smart-swimmingpool/pool-controller/openspec/changes/controller-architecture-contracts/tasks.md

# Tasks

- [x] Add typed `OperationMode` with stable external conversion helpers.
- [x] Keep operation-mode conversion compatible with the firmware C++ toolchain.
- [x] Add fixed-size `ControllerCommand` and source/type enums.
- [x] Cover the existing temperature-circulation setters in the command contract.
- [x] Preserve independent timer-start and timer-end update semantics in the command contract.
- [x] Cover mutable runtime controller settings (loop interval, timezone, time-loss and NORVI button thresholds).
- [x] Add `SensorSnapshot` and `SystemSnapshot` read models.
- [x] Project sensor mapping identity and configured/found state through `SensorSnapshot`.
- [x] Project timer schedule, effective runtime and circulation-extension state through `SystemSnapshot`.
- [x] Project temperature-circulation configuration through `SystemSnapshot`.
- [x] Project runtime controller settings through `SystemSnapshot`.
- [x] Preserve GREEN/YELLOW/RED time degradation in the health read model.
- [x] Project local IPv4 state through `NetworkSnapshot` without dynamic allocation.
- [x] Project both free heap and maximum allocatable heap through `SystemSnapshot`.
- [x] Assert command/snapshot value types remain trivially copyable.
- [x] Add bounded NTP-server command and settings projection with explicit non-truncating copy/validation.
- [x] Represent relative pool/solar pump toggles and mode cycling independently of adapter snapshots.
- [x] Preserve Web/NORVI/Olimex toggle mode policy as a single owner action.
- [x] Project the detected inventory with a 20-device cap, ROMs and independent temperature validity.
- [x] Add native tests for compatibility, text boundaries, full/empty inventory, diagnostics and copy semantics.
- [x] Document the minimal dependency graph, current #218 progress, #170 ownership gate and sensor projection bridge.
- [x] Add a bounded, allocation-free `ControllerCommandQueue` for adapter-to-loop hand-over.
- [x] Add a synchronized `ControllerSnapshotStore` for complete read-model publication.
- [ ] In #216/#217, verify the expanded payloads and transport resource budgets.
- [ ] In #218, validate Web/legacy NTP input without silent truncation and complete owner/adapter regressions.
- [ ] In #218/#220, verify both-bus inventory aggregation, deduplication, overflow and rescan replacement on the owning task.
- [x] Register native tests in CMake/test runner.
- [x] Store operation mode internally as the typed enum while preserving String compatibility at boundaries.
- [ ] Adopt typed commands in MQTT/Web/local UI in a follow-up change.
- [ ] Adopt `SystemSnapshot` in MQTT/Web/display in a follow-up change.
- [ ] Replace direct rule-to-relay writes with application decisions in a follow-up change.
