smart-swimmingpool/pool-controller/docs/security-references.de.md

# Sicherheitsreferenzen & Best Practices

Dieses Dokument enthält Sicherheitsreferenzen, Best Practices und
Implementierungsrichtlinien für das Pool Controller Projekt. Diese Referenzen
wurden während der umfassenden IoT-Sicherheitsanalyse am 2025-01-15 zusammengestellt.

## 📚 Sicherheitsstandards & Richtlinien

### Allgemeine Sicherheitsframeworks

- **[OWASP IoT Security Guidance](https://owasp.org/www-project-internet-of-things/)**
  Umfassendes IoT-Sicherheitsframework, das Gerätesicherheit, Netzwerksicherheit und Datenschutz abdeckt.

- \*\*[OWASP Secure Coding Practices Quick Reference Guide](https://owasp.org/www-project-secure-coding-practices-quick-reference-guide/)

\*\*
Allgemeine Richtlinien für sicheres Codieren, anwendbar auf eingebettete Systeme und IoT-Geräte.

- **[NIST IoT Device Cybersecurity Guidance](https://www.nist.gov/iot)**
  NIST-Empfehlungen für IoT-Gerätesicherheit, einschließlich Risikomanagement und Sicherheitskontrollen.

### Webanwendungssicherheit

- \*\*[OWASP CSRF Prevention Cheat Sheet](https://cheatsheetseries.owasp.org/cheatsheets/Cross-Site_Request_Forgery_Prevention_Cheat_Sheet.html)

\*\*
Umfassender Leitfaden zu CSRF-Schutzstrategien, einschließlich Token-basierter Ansätze und SameSite-Cookie-Attribute.

- \*\*[OWASP Session Management Cheat Sheet](https://cheatsheetseries.owasp.org/cheatsheets/Session_Management_Cheat_Sheet.html)

\*\*
Best Practices für sicheres Session-Management, einschließlich Timeout-Handling und Cookie-Sicherheit.

- **[OWASP Authentication Cheat Sheet](https://cheatsheetseries.owasp.org/cheatsheets/Authentication_Cheat_Sheet.html)**
  Richtlinien für sichere Authentifizierungsimplementierung, Passwortspeicherung und Credential-Management.

## 🔒 ESP32-spezifische Sicherheit

### Offizielle Espressif-Dokumentation

- **[ESP32 Sicherheitsfunktionen](https://docs.espressif.com/projects/esp-idf/en/latest/esp32/security/index.html)**
  Offizielle Espressif-Sicherheitsdokumentation, die alle Sicherheitsaspekte der ESP32-Plattform abdeckt.

- **[ESP32 Secure Boot](https://docs.espressif.com/projects/esp-idf/en/latest/esp32/security/secure-boot.html)**
  Vollständiger Leitfaden zur Implementierung von Secure Boot auf ESP32, einschließlich Schlüsselgenerierung und
  eFuse-Konfiguration.

- \*\*[ESP32 Flash-Verschlüsselung](https://docs.espressif.com/projects/esp-idf/en/latest/esp32/security/flash-encryption.html)

\*\*
Detaillierte Dokumentation zur Flash-Verschlüsselungskonfiguration und -implementierung.

- **[ESP32 eFuse-Referenz](https://docs.espressif.com/projects/esp-idf/en/latest/esp32/api-reference/system/efuse.html)
  **
  Referenzdokumentation für eFuse-Brennen und Konfigurationsoptionen.

- **[ESP32 Speichertypen](https://docs.espressif.com/projects/esp-idf/en/latest/esp32/api-guides/memory-types.html)**
  Verständnis der ESP32-Speicherarchitektur und verschiedener Speichertypen (DRAM, IRAM, etc.).

- \*\*[ESP32 Speicherverwaltung](https://docs.espressif.com/projects/esp-idf/en/latest/esp32/api-guides/memory-management.html)

\*\*
Speicherzuweisungsstrategien und Best Practices für die ESP32-Entwicklung.

- \*\*[ESP32 Heap-Fragmentierung](https://docs.espressif.com/projects/esp-idf/en/latest/esp32/api-guides/heap-fragmentation.html)

\*\*
Verständnis und Vermeidung von Heap-Fragmentierung in ESP32-Anwendungen.

- \*\*[ESP-IDF Speicher-Debugging](https://docs.espressif.com/projects/esp-idf/en/latest/esp32/api-guides/debugging/memory-leaks.html)

\*\*
Tools und Techniken zum Erkennen und Debuggen von Speicherlecks in ESP32-Anwendungen.

### Praktische Implementierungsbeispiele

- **[ESP32 HTTPS-Server](https://github.com/espressif/esp-idf/tree/master/examples/protocols/https_server)**
  Beispielimplementierung eines HTTPS-Servers auf ESP32 mit Zertifikatskonfiguration.

- **[ESP32 TLS-Client](https://github.com/espressif/esp-idf/tree/master/examples/protocols/https_request)**
  Beispiel für sichere Client-Verbindungen mit TLS auf ESP32.

## 🌐 Netzwerksicherheit

- **[IETF RFC 8520 - Manufacturer Usage Description (MUD)](https://datatracker.ietf.org/doc/html/rfc8520)**
  Standard für Manufacturer Usage Description, um Netzwerkgeräten zu ermöglichen, ihr beabsichtigtes Netzwerkverhalten
  zu signalisieren.

- **[NIST SP 800-213: IoT Device Cybersecurity Guidance](https://csrc.nist.gov/publications/detail/sp/800-213/final)**
  NIST Special Publication mit Leitlinien zur Cybersicherheit für IoT-Geräte.

## 🔧 Speicheroptimierung & Performance

### ESP32-Speicherverwaltung

- \*\*[ESP32 Speicheroptimierungsleitfaden](https://github.com/espressif/esp-idf/blob/master/docs/en/api-guides/memory-types.rst)

\*\*
Offizielle Speicheroptimierungsstrategien für die ESP32-Entwicklung.

- \*\*[Heap-Nutzungsüberwachung](https://docs.espressif.com/projects/esp-idf/en/latest/esp32/api-reference/system/heap_debug.html)

\*\*
ESP32 Heap-Debugging-Funktionen und Verwendungsbeispiele.

### Arduino & C++ Optimierung

- **[Arduino String vs char arrays](https://www.arduino.cc/en/Reference/String)**
  Wann String vs char arrays verwendet werden sollten, mit Performance-Überlegungen.

- **[ArduinoJson Speicheroptimierung](https://arduinojson.org/v6/how-to/reduce-memory-usage/)**
  Techniken zur Reduzierung des Speicherverbrauchs mit der ArduinoJson-Bibliothek.

- **[ArduinoJson Assistant](https://arduinojson.org/v6/assistant/)**
  Online-Tool zur Berechnung der benötigten Puffergrößen für JSON-Dokumente.

- **[Vermeiden von String in Arduino](https://hackingmajenkoblog.wordpress.com/2016/02/04/the-evils-of-arduino-strings/)
  **
  Warum und wie man die String-Klasse in Arduino für besseres Speichermanagement vermeidet.

- **[Statische vs Dynamische Zuweisung](https://embeddedartistry.com/blog/2017/02/22/always-use-the-right-sized-integer/)
  **
  Wahl der richtigen Zuweisungsstrategie für eingebettete Systeme.

- \*\*[Google C++ Style Guide - Speicherverwaltung](https://google.github.io/styleguide/cppguide.html#Ownership_and_Smart_Pointers)

\*\*
Richtlinien für die Verwendung von Smart Pointern und Speicherverwaltung.

## 🛡️ Sicherheitstools & Scanner

### Statische Analyse & Linting

- **[Gitleaks](https://github.com/gitleaks/gitleaks)**
  Schnelles und effizientes Erkennen von Geheimnissen in Git-Repositories. Wird in diesem Projekt zum Erkennen von
  hartcodierten Anmeldedaten und sensiblen Daten verwendet.

- **[CodeQL](https://codeql.github.com/)**
  Semantische Code-Analyse-Engine zum Auffinden von Sicherheitslücken. In GitHub Actions CI integriert.

- **[MegaLinter](https://megalinter.io/)**
  Multi-Sprachen-Linting-Framework von OX Security, das mehrere Linter kombiniert. Wird in der CI-Pipeline dieses Projekts verwendet.

- **[cpplint](https://github.com/cpplint/cpplint)**
  Googles C++-Linter zur Durchsetzung von Codierstandards und Erkennung potenzieller Probleme.

- **[clang-tidy](https://clang.llvm.org/extra/clang-tidy/)**
  Clang-basiertes statisches Analyse-Tool für C++-Code.

### Formatierungstools

- **[clang-format](https://clang.llvm.org/docs/ClangFormat.html)**
  Code-Formatierungstool mit konfigurierbaren Stilen. Wird in diesem Projekt mit benutzerdefinierter Konfiguration
  verwendet.

- **[Prettier](https://prettier.io/)**
  Meinungsstarkes Code-Formatierungstool für YAML-, JSON- und Markdown-Dateien.

- **[EditorConfig](https://editorconfig.org/)**
  Konsistente Codierstile über verschiedene Editoren und IDEs hinweg.

## 📋 Code-Qualität & CI/CD

### CI/CD Best Practices

- **[GitHub Actions Dokumentation](https://docs.github.com/en/actions)**
  Offizielle Dokumentation für die Konfiguration und Best Practices von GitHub Actions Workflows.

- **[PlatformIO CI](https://docs.platformio.org/en/latest/integration/ci/github-actions.html)**
  PlatformIO-Integration mit GitHub Actions für eingebettete Projekt-Builds.

- **[Quality Gates Pattern](https://martinfowler.com/articles/continuousIntegration.html#QualityGates)**
  Strategien zur Implementierung von Qualitätsgates in CI/CD-Pipelines.

### Linting & Formatierung

- **[MegaLinter Konfiguration](https://megalinter.io/latest/configuration/)**
  Konfigurations- und Anpassungsleitfaden für MegaLinter.

- **[clang-format Konfiguration](https://clang.llvm.org/docs/ClangFormatStyleOptions.html)**
  Vollständige Referenz für clang-format-Stiloptionen.

- **[EditorConfig-Eigenschaften](https://editorconfig.org/#file-format-details)**
  Verfügbare Konfigurationsoptionen für EditorConfig-Dateien.

## 🔐 Kryptographie & TLS

- **[mbedTLS-Dokumentation](https://github.com/Mbed-TLS/mbedtls)**
  TLS/SSL-Bibliothek, die von ESP32 für sichere Kommunikation verwendet wird.

- **[OpenSSL-Dokumentation](https://www.openssl.org/docs/)**
  Umfassende Dokumentation für die OpenSSL-Kryptographiebibliothek.

## 📖 Implementierungsleitfäden in diesem Projekt

### Sicherheitsverbesserungen (PR #112)

Die folgenden Sicherheitsverbesserungen wurden in
[PR #112](https://github.com/smart-swimmingpool/pool-controller/pull/112)
implementiert:

1. **CSRF-Schutz**

   - Token-Generierung und -Validierungssystem
   - SameSite-Cookie-Attribute für XSS/CSRF-Schutz
   - 30-minütige Token-Ablaufzeit mit automatischer Regenerierung

2. **Geheimnisverwaltung**

   - Gitleaks-Konfiguration für False Positives
   - Verbesserte Dokumentation für den Standard-Passwort-Hash
   - Bessere Code-Kommentare, die das absichtliche Hardcoding erklären

3. **Speichersicherheit**

   - Vermeidung von Dangling Pointern in TimeClientHelper
   - Speichereffiziente Utility-Funktionen in Utils.hpp
   - String-Optimierungs-Utilities

4. **Code-Qualität**
   - Zeilenlängen-Einhaltung (<130 Zeichen)
   - Entfernung von Trailing Whitespace
   - Korrekte Formatierung von Kontrollstrukturen

### Verwendungsbeispiele

#### CSRF-Token-Verwendung

```cpp
// CSRF-Tokens generieren und validieren
String token = WebPortal::generateCsrfToken();
bool isValid = WebPortal::validateCsrfToken(submittedToken);
String currentToken = WebPortal::getCurrentCsrfToken();
```

#### Speichereffiziente String-Operationen

```cpp
// Utility-Funktionen für speichereffiziente String-Operationen verwenden
String result;
Utils::safeStringConcat(result, "Hallo ", 32);
Utils::safeStringConcat(result, "Welt!", 32);

// Oder vorreservierte Strings erstellen
String reserved = Utils::createReservedString("Initial", 64);
```

## 🎯 Verwandte Skills

- **[IoT Security Skill](../.opencode/skills/iot-security/SKILL.md)** - Umfassende IoT-Sicherheitsrichtlinien
- **[C++ Memory Optimization Skill](../.opencode/skills/cpp-memory-opt/SKILL.md)** - Speicheroptimierungstechniken
- **[C++ Code Quality Skill](../.opencode/skills/cpp-code-quality/SKILL.md)** - Code-Qualitäts- und Linting-Standards

## 📝 Beitragsrichtlinien

Beim Beitragen von Sicherheitsverbesserungen zu diesem Projekt:

1. **OWASP-Richtlinien befolgen**: Halten Sie sich an OWASP-Sicherheitsbest Practices
2. **Etablierte Bibliotheken verwenden**: Bevorzugen Sie gut getestete Bibliotheken vor benutzerdefinierten Implementierungen
3. **Sicherheitsentscheidungen dokumentieren**: Dokumentieren Sie alle Sicherheitskompromisse klar
4. **Sicherheitsfunktionen testen**: Stellen Sie sicher, dass Sicherheitsfunktionen ordnungsgemäß getestet werden
5. **Dokumentation aktualisieren**: Halten Sie die Sicherheitsdokumentation auf dem neuesten Stand

## 🔍 Sicherheits-Audit-Checkliste

Verwenden Sie diese Checkliste bei der Durchführung von Sicherheitsaudits:

- [ ] Alle Anmeldedaten verschlüsselt im Ruhezustand (nicht im Klartext)
- [ ] Sichere Kommunikationsprotokolle verwendet (TLS/HTTPS)
- [ ] Eingabevalidierung für alle Benutzereingaben implementiert
- [ ] Ausgabe-Kodierung zur Verhinderung von Injection-Angriffen
- [ ] Session-Management mit angemessenen Timeouts
- [ ] CSRF-Schutz für alle zustandsändernden Operationen
- [ ] Ratenbegrenzung auf Authentifizierungs-Endpunkten
- [ ] Fehlermeldungen enthüllen keine sensiblen Informationen
- [ ] Logging enthält keine sensiblen Daten
- [ ] Speicherverwaltung verhindert Lecks und Beschädigungen

---

**📅 Zuletzt aktualisiert**: 2025-01-15
**🔍 Analyse durchgeführt von**: Vibe Code - IoT Security Expert Mode
**📝 Verwandter PR**: [#112 - IoT Security & Memory Optimization Analysis](https://github.com/smart-swimmingpool/pool-controller/pull/112)
