smart-swimmingpool/pool-controller/docs/security-references.md

# Security References & Best Practices

This document contains security references, best practices, and implementation
guidelines for the Pool Controller project. These references were compiled during the
comprehensive IoT security analysis performed on 2025-01-15.

## 📚 Security Standards & Guidelines

### General Security Frameworks

- **[OWASP IoT Security Guidance](https://owasp.org/www-project-internet-of-things/)**
  Comprehensive IoT security framework covering device security, network security, and data protection.

- \*\*[OWASP Secure Coding Practices Quick Reference Guide](https://owasp.org/www-project-secure-coding-practices-quick-reference-guide/)

\*\*

General secure coding guidelines applicable to embedded systems and IoT
devices.

- **[NIST IoT Device Cybersecurity Guidance](https://www.nist.gov/iot)**
  NIST recommendations for IoT device security, including risk management and security controls.

### Web Application Security

- \*\*[OWASP CSRF Prevention Cheat Sheet](https://cheatsheetseries.owasp.org/cheatsheets/Cross-Site_Request_Forgery_Prevention_Cheat_Sheet.html)

\*\*

Comprehensive guide to CSRF protection strategies, including token-based
approaches and SameSite cookie attributes.

- \*\*[OWASP Session Management Cheat Sheet](https://cheatsheetseries.owasp.org/cheatsheets/Session_Management_Cheat_Sheet.html)

\*\*

Best practices for secure session management, including timeout handling and
cookie security.

- **[OWASP Authentication Cheat Sheet](https://cheatsheetseries.owasp.org/cheatsheets/Authentication_Cheat_Sheet.html)**
  Guidelines for secure authentication implementation, password storage, and credential management.

## 🔒 ESP32 Specific Security

### Official Espressif Documentation

- **[ESP32 Security Features](https://docs.espressif.com/projects/esp-idf/en/latest/esp32/security/index.html)**
  Official Espressif security documentation covering all security aspects of the ESP32 platform.

- **[ESP32 Secure Boot](https://docs.espressif.com/projects/esp-idf/en/latest/esp32/security/secure-boot.html)**
  Complete guide to implementing Secure Boot on ESP32, including key generation and eFuse configuration.

- **[ESP32 Flash Encryption](https://docs.espressif.com/projects/esp-idf/en/latest/esp32/security/flash-encryption.html)
  **

  Detailed documentation on flash encryption configuration and implementation.

- **[ESP32 eFuse Reference](https://docs.espressif.com/projects/esp-idf/en/latest/esp32/api-reference/system/efuse.html)
  **

  Reference documentation for eFuse burning and configuration options.

- **[ESP32 Memory Types](https://docs.espressif.com/projects/esp-idf/en/latest/esp32/api-guides/memory-types.html)**
  Understanding ESP32 memory architecture and different memory types (DRAM, IRAM, etc.).

- \*\*[ESP32 Memory Management](https://docs.espressif.com/projects/esp-idf/en/latest/esp32/api-guides/memory-management.html)

\*\*

Memory allocation strategies and best practices for ESP32 development.

- \*\*[ESP32 Heap Fragmentation](https://docs.espressif.com/projects/esp-idf/en/latest/esp32/api-guides/heap-fragmentation.html)

\*\*

Understanding and preventing heap fragmentation in ESP32 applications.

- \*\*[ESP-IDF Memory Debugging](https://docs.espressif.com/projects/esp-idf/en/latest/esp32/api-guides/debugging/memory-leaks.html)

\*\*

Tools and techniques for detecting and debugging memory leaks in ESP32
applications.

### Practical Implementation Examples

- **[ESP32 HTTPS Server](https://github.com/espressif/esp-idf/tree/master/examples/protocols/https_server)**
  Example implementation of HTTPS server on ESP32 with certificate configuration.

- **[ESP32 TLS Client](https://github.com/espressif/esp-idf/tree/master/examples/protocols/https_request)**
  Example of secure client connections using TLS on ESP32.

## 🌐 Network Security

- **[IETF RFC 8520 - Manufacturer Usage Description (MUD)](https://datatracker.ietf.org/doc/html/rfc8520)**
  Standard for manufacturer usage description to enable network devices to signal their intended network behavior.

- **[NIST SP 800-213: IoT Device Cybersecurity Guidance](https://csrc.nist.gov/publications/detail/sp/800-213/final)**
  NIST Special Publication providing guidance on cybersecurity for IoT devices.

## 🔧 Memory Optimization & Performance

### ESP32 Memory Management

- \*\*[ESP32 Memory Optimization Guide](https://github.com/espressif/esp-idf/blob/master/docs/en/api-guides/memory-types.rst)

\*\*

Official memory optimization strategies for ESP32 development.

- \*\*[Heap Usage Monitoring](https://docs.espressif.com/projects/esp-idf/en/latest/esp32/api-reference/system/heap_debug.html)

\*\*

ESP32 heap debugging functions and usage examples.

### Arduino & C++ Optimization

- **[Arduino String vs char arrays](https://www.arduino.cc/en/Reference/String)**
  When to use String vs char arrays, with performance considerations.

- **[ArduinoJson Memory Optimization](https://arduinojson.org/v6/how-to/reduce-memory-usage/)**
  Techniques for reducing memory usage with ArduinoJson library.

- **[ArduinoJson Assistant](https://arduinojson.org/v6/assistant/)**
  Online tool to calculate required buffer sizes for JSON documents.

- **[Avoiding String in Arduino](https://hackingmajenkoblog.wordpress.com/2016/02/04/the-evils-of-arduino-strings/)**
  Why and how to avoid the String class in Arduino for better memory management.

- **[Static vs Dynamic Allocation](https://embeddedartistry.com/blog/2017/02/22/always-use-the-right-sized-integer/)**
  Choosing the right allocation strategy for embedded systems.

- \*\*[Google C++ Style Guide - Memory Management](https://google.github.io/styleguide/cppguide.html#Ownership_and_Smart_Pointers)

\*\*

Smart pointer usage guidelines and memory management best practices.

## 🛡️ Security Tools & Scanners

### Static Analysis & Linting

- **[Gitleaks](https://github.com/gitleaks/gitleaks)**
  Fast and efficient secret detection in git repositories. Used in this project
  for detecting hardcoded credentials and sensitive data.

- **[CodeQL](https://codeql.github.com/)**
  Semantic code analysis engine for finding security vulnerabilities. Integrated into GitHub Actions CI.

- **[MegaLinter](https://megalinter.io/)**
  Multi-language linting framework by OX Security. Combines multiple linters. Used in this project's CI pipeline.

- **[cpplint](https://github.com/cpplint/cpplint)**
  Google's C++ linter for enforcing coding style and detecting potential issues.

- **[clang-tidy](https://clang.llvm.org/extra/clang-tidy/)**
  Clang-based static analysis tool for C++ code.

### Formatting Tools

- **[clang-format](https://clang.llvm.org/docs/ClangFormat.html)**
  Code formatting tool with configurable styles. Used in this project with custom configuration.

- **[Prettier](https://prettier.io/)**
  Opinionated code formatter for YAML, JSON, and Markdown files.

- **[EditorConfig](https://editorconfig.org/)**
  Consistent coding styles across different editors and IDEs.

## 📋 Code Quality & CI/CD

### CI/CD Best Practices

- **[GitHub Actions Documentation](https://docs.github.com/en/actions)**
  Official documentation for GitHub Actions workflow configuration and best practices.

- **[PlatformIO CI](https://docs.platformio.org/en/latest/integration/ci/github-actions.html)**
  PlatformIO integration with GitHub Actions for embedded project builds.

- **[Quality Gates Pattern](https://martinfowler.com/articles/continuousIntegration.html#QualityGates)**
  Strategies for implementing quality gates in CI/CD pipelines.

### Linting & Formatting

- **[MegaLinter Configuration](https://megalinter.io/latest/configuration/)**
  Configuration and customization guide for MegaLinter.

- **[clang-format Configuration](https://clang.llvm.org/docs/ClangFormatStyleOptions.html)**
  Complete reference for clang-format style options.

- **[EditorConfig Properties](https://editorconfig.org/#file-format-details)**
  Available configuration options for EditorConfig files.

## 🔐 Cryptography & TLS

- **[mbedTLS Documentation](https://github.com/Mbed-TLS/mbedtls)**
  TLS/SSL library used by ESP32 for secure communications.

- **[OpenSSL Documentation](https://www.openssl.org/docs/)**
  Comprehensive documentation for OpenSSL cryptographic library.

## 📖 Implementation Guides in This Project

### Security Improvements (PR #112)

The following security improvements were implemented in
[PR #112](https://github.com/smart-swimmingpool/pool-controller/pull/112):

1. **CSRF Protection**

   - Token generation and validation system
   - SameSite cookie attributes for XSS/CSRF protection
   - 30-minute token expiration with automatic regeneration

2. **Secret Management**

   - Gitleaks configuration for handling false positives
   - Improved documentation for default password hash
   - Better code comments explaining intentional hardcoding

3. **Memory Safety**

   - Dangling pointer prevention in TimeClientHelper
   - Memory-efficient utility functions in Utils.hpp
   - String optimization utilities

4. **Code Quality**
   - Line length compliance (<130 characters)
   - Trailing whitespace removal
   - Proper control structure formatting

### Usage Examples

#### CSRF Token Usage

```cpp
// Generate and validate CSRF tokens
String token = WebPortal::generateCsrfToken();
bool isValid = WebPortal::validateCsrfToken(submittedToken);
String currentToken = WebPortal::getCurrentCsrfToken();
```

#### Memory-Efficient String Operations

```cpp
// Use utility functions for memory-efficient string operations
String result;
Utils::safeStringConcat(result, "Hello ", 32);
Utils::safeStringConcat(result, "World!", 32);

// Or create pre-reserved strings
String reserved = Utils::createReservedString("Initial", 64);
```

## 🎯 Related Skills

- **[IoT Security Skill](../.opencode/skills/iot-security/SKILL.md)** - Comprehensive IoT security guidelines
- **[C++ Memory Optimization Skill](../.opencode/skills/cpp-memory-opt/SKILL.md)** - Memory optimization techniques
- **[C++ Code Quality Skill](../.opencode/skills/cpp-code-quality/SKILL.md)** - Code quality and linting standards

## 📝 Contribution Guidelines

When contributing security improvements to this project:

1. **Follow OWASP Guidelines**: Adhere to OWASP security best practices
2. **Use Established Libraries**: Prefer well-tested libraries over custom implementations
3. **Document Security Decisions**: Clearly document any security trade-offs
4. **Test Security Features**: Ensure security features are properly tested
5. **Update Documentation**: Keep security documentation up to date

## 🔍 Security Audit Checklist

Use this checklist when performing security audits:

- [ ] All credentials encrypted at rest (not in plaintext)
- [ ] Secure communication protocols used (TLS/HTTPS)
- [ ] Input validation implemented for all user inputs
- [ ] Output encoding to prevent injection attacks
- [ ] Session management with proper timeouts
- [ ] CSRF protection for all state-changing operations
- [ ] Rate limiting on authentication endpoints
- [ ] Error messages don't reveal sensitive information
- [ ] Logging doesn't contain sensitive data
- [ ] Memory management prevents leaks and corruption

---

**📅 Last Updated**: 2025-01-15
**🔍 Analysis Performed By**: Vibe Code - IoT Security Expert Mode
**📝 Related PR**:
[#112 - IoT Security & Memory Optimization Analysis](https://github.com/smart-swimmingpool/pool-controller/pull/112)
