smart-swimmingpool/pool-controller/.slim/deepwork/pr113-and-branches.md

# Deepwork: PR #113 + Branch Audit

## Current State

### PR #113 — `vibe/security-memory-fixes-255c07` → `main`

**Merge Status**: Branch is up to date with main (0 behind, 15 ahead).
GitHub shows CONFLICTING but `git rebase main` says "up to date" — this is a stale status.

**CI Failures**:
1. **Super-Linter**: ❌ CPP (cpplint) + EDITORCONFIG errors
2. **test-and-coverage**: ❌ Compilation error in `test_security.cpp`

**Test Compilation Root Cause**: The `// NOLINT \` construct in `ASSERT_GT`/`ASSERT_GTE`/`ASSERT_LT` macros.
Backslash-newline splicing happens BEFORE comment processing (C++ phases 2→3), so `// NOLINT \` makes
the rest of the macro body a comment, leaving the `if` body unclosed.

**Codex Reviews**: 15 reviews, all COMMENTED. Most are boilerplate (no actual suggestions).
One substantive P2 comment: "Allow clearing MQTT passwords" — still unresolved.
Earlier P1/P2 comments have been addressed in subsequent commits.
The `@stritti` replied with detailed summaries (3x), all marked as addressed.
Codex hit usage limits, no further reviews possible.

**Last relevant Codex comment**: P2 about MQTT password clearing.

### Branches Overview

| Branch | Behind | Ahead | Status |
|---|---|---|---|
| `fix/ca-cert-isrg-root-x1` | 0 | 6 | current |
| `feat/kicad-schematics` | 0 | 12 | current |
| `docs/security-checklist` | 4 | 3 | stale |
| `docs/troubleshooting-matrix` | 4 | 3 | stale |
| `docs/build-from-zero` | 4 | 1 | stale |
| `opencode/lucky-garden` | 7 | 8 | stale |
| `opencode/witty-star` | 7 | 10 | stale |
| `fix/telemetry-mqtt-discovery` | 7 | 8 | stale |
| `chore/cleanup-dht-and-format` | 24 | 2 | very stale |
| `chore/skill-editorconfig-all-files` | 24 | 1 | very stale |
| `feat/mdns-discoverable` | 26 | 1 | very stale |
| `feature/norvi-ae01-r` | 26 | 7 | very stale |
| `feat/temp-based-circulation` | 44 | 5 | very stale |
| `feat/ha-climate-entity` | 46 | 4 | very stale |
