smart-swimmingpool/pool-controller/.opencode/skills/clean-code/SKILL.md

---
name: clean-code
description: "Clean Code checklist for the pool-controller C++ codebase — derived from Codex Review PR #143 findings. Systematic review categories for heap safety, duplication, debris, logging hygiene, boot sequencing, naming, const correctness, and testability. 🇩🇪 Deutsche Trigger: Sauberer Code, Code-Review, Clean Code Checkliste, Heap-Sicherheit, String-Verbot, Duplikate, Toter Code, Logging, Boot-Reihenfolge, const correctness, Testbarkeit, Entkopplung, Lesbarkeit, Wartbarkeit."
keywords:
  - clean code
  - sauberer code
  - code review checkliste
  - code review checklist
  - heap sicherheit
  - heap safety
  - string verbot
  - no string
  - duplikate vermeiden
  - code duplication
  - toter code
  - dead code
  - debris
  - logging hygiene
  - debug output
  - boot sequenz
  - boot sequence
  - degradation
  - const correctness
  - testbarkeit
  - testability
  - entkopplung
  - decoupling
  - lesbarkeit
  - readability
  - wartbarkeit
  - maintainability
  - codestandards
  - coding standards
  - naming conventions
  - early return
  - single responsibility
  - small functions
  - include hygiene
  - pre-merge review
---

# Clean Code — Pool Controller

Systematische Clean Code Review-Kategorien abgeleitet aus dem [Codex Review PR #143](https://github.com/smart-swimmingpool/pool-controller/pull/143).
Jede Kategorie beschreibt ein konkretes, prüfbares Muster — keine abstrakten Prinzipien.

Jeder PR durchläuft **alle 8 Kategorien** vor dem Merge.

> **🔍 Code Search**: `semble search "String" src/` → Heap-Verstöße finden.
> `semble search "Preferences.begin" src/` → mögliche NVS-Duplikate.
> `semble search "Serial.print" src/` → Debug-Output in Produktionscode.

---

## K1 — Heap Safety (String-Verbot in Hot Paths)

Heap-Allokationen fragmentieren den ESP32-Speicher und führen nach Tagen/Wochen zum OOM-Crash.
`String`, `std::string` und dynamische `new`-Allokationen sind nur in **Setup-/einmaligem Code** erlaubt.

### Prüfliste

| Check | Beschreibung | Konsequenz |
| --- | --- | --- |
| `String` im Loop/zyklischen Code | String-Konkatenation in `publishStates()`, `loop()`, `check*()` | **Blocked** — char-Buffer verwenden |
| `getBaseTopic()` kehrt `String` zurück | Rückgabe als `String` zwingt Caller zur Heap-Allokation | **Blocked** — `void getBaseTopic(char*, size_t, ...)` |
| `serializeJson(doc, payload)` mit `String payload` | ArduinoJson serialisiert in `String` → Heap | **Blocked** — `serializeJson(doc, payloadBuf, sizeof(payloadBuf))` |
| `String(poolTemp, 1)` für MQTT-Publish | temporäre String-Objekte im Hot Path | **Blocked** — `snprintf(valBuf, sizeof(valBuf), "%.1f", temp)` |
| `String` als Funktionsparameter | Kopie bei jedem Aufruf | `const String&` oder `const char*` |
| `str + str2` Konkatenation | Erzeugt temporäre String-Objekte | char-Array + `strlcat`/`snprintf` |

### Beispiel: Gut vs. Schlecht

```cpp
// ❌ BAD — Heap-Allokation im Hot Path
String MqttPublisher::getBaseTopic(const char *component, const char *objectId) {
  return String("homeassistant/") + component + "/pool-controller/" + objectId;
}
// → 3+ temporäre String-Objekte pro Aufruf, ~80ns + Heap-Fragmentierung

// ✅ GOOD — Stack-only
void MqttPublisher::getBaseTopic(char *buf, size_t bufSize, const char *component, const char *objectId) {
  snprintf(buf, bufSize, "homeassistant/%s/pool-controller/%s", component, objectId);
}
```

```cpp
// ❌ BAD — String als MQTT-Payload
String payload;
serializeJson(doc, payload);
NetworkManager::publish(topic, payload.c_str(), true);

// ✅ GOOD — pre-allocated char buffer
char payloadBuf[1024];
serializeJson(doc, payloadBuf, sizeof(payloadBuf));
NetworkManager::publish(topic, payloadBuf, true);
```

### Ausnahmen (akzeptabel)

- `deviceId_` im Konstruktor/`begin()` einmal gesetzt (nicht in Hot Path)
- `OtaUpdater::downloadUrl_` nur bei OTA-Update (selten)
- `ConfigManager` String-Member — nur bei `load()`/`save()` genutzt

---

## K2 — Code Duplication (DRY)

Duplizierte Logik = duplizierte Bugs. Jede Geschäftslogik existiert genau einmal.

### Prüfliste

| Muster | Fundort | Fix |
| --- | --- | --- |
| Identische NVS-Zugriffe (`Preferences::begin("ds18b20")`) | PoolController.cpp + WebPortal.cpp + ConfigManager | In ConfigManager zentralisieren |
| Gleiche Discovery-Payload-Struktur | Alle `publish*Discovery()` Methoden | Template-Methode oder Helper |
| Wiederholte `getBaseTopic(...) + "/state"` | publishStates() | `TopicBuilder`-Helper (anonymes namespace) |
| Gleiche Sensor-Mapping-Konvertierung (hexToString/addressToString) | PoolController.cpp + WebPortal.cpp | In ConfigManager oder Utility |
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
