smart-swimmingpool/pool-controller/docs/img/IMG_8198.jpg

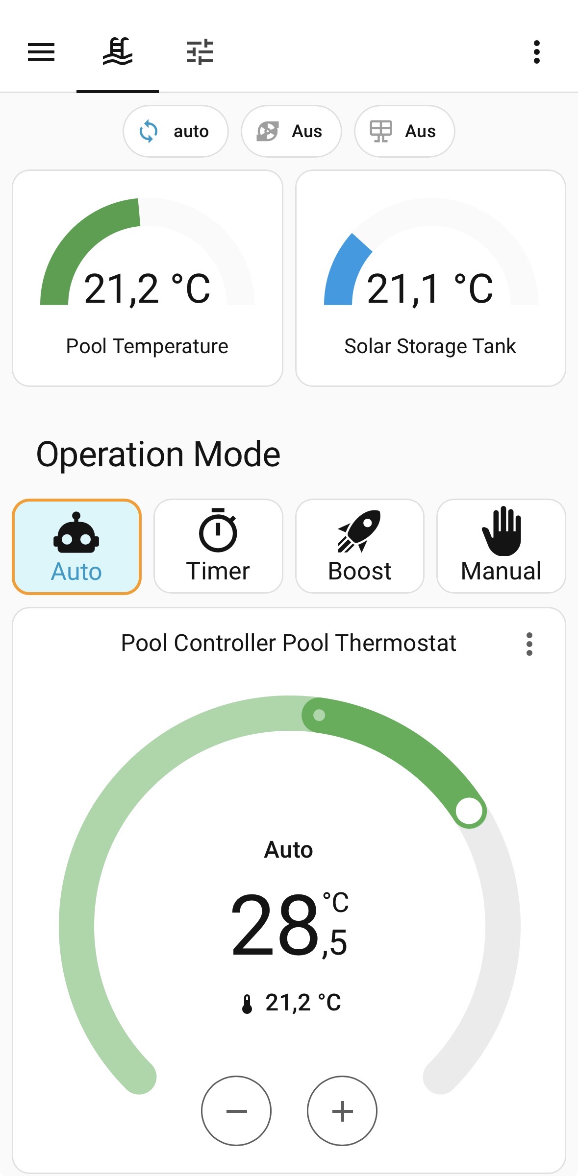
docs/img/IMG_8198.jpg
