smart-swimmingpool/pool-controller/docs/img/IMG_8199.jpg

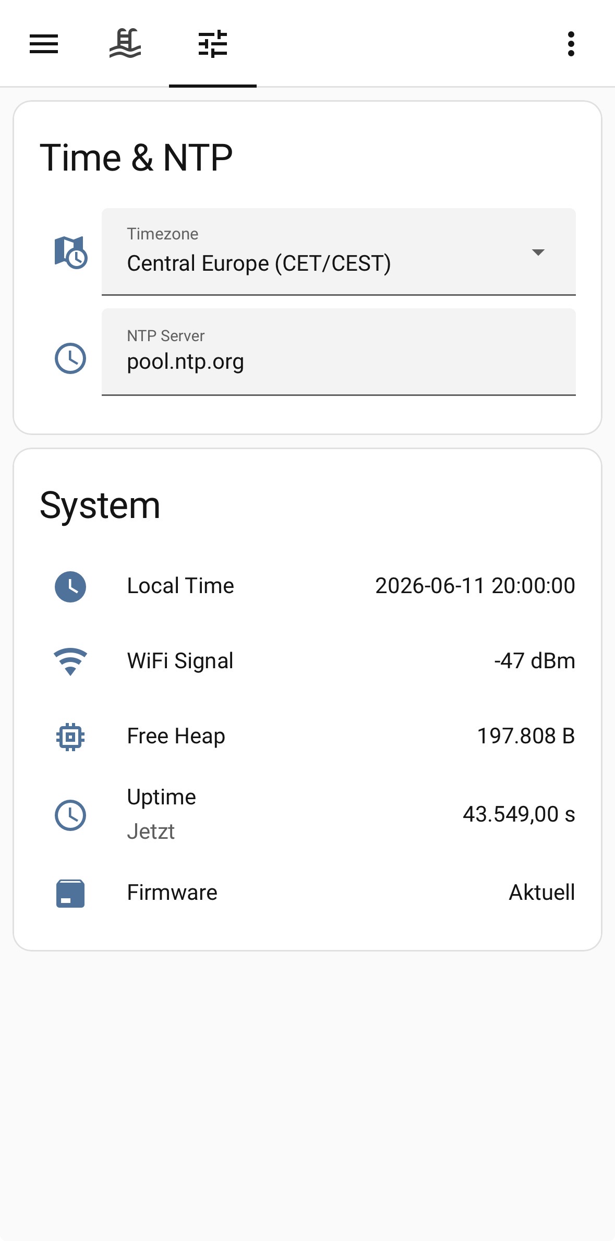
docs/img/IMG_8199.jpg
