smart-swimmingpool/pool-controller/docs/img/IMG_8200.jpg

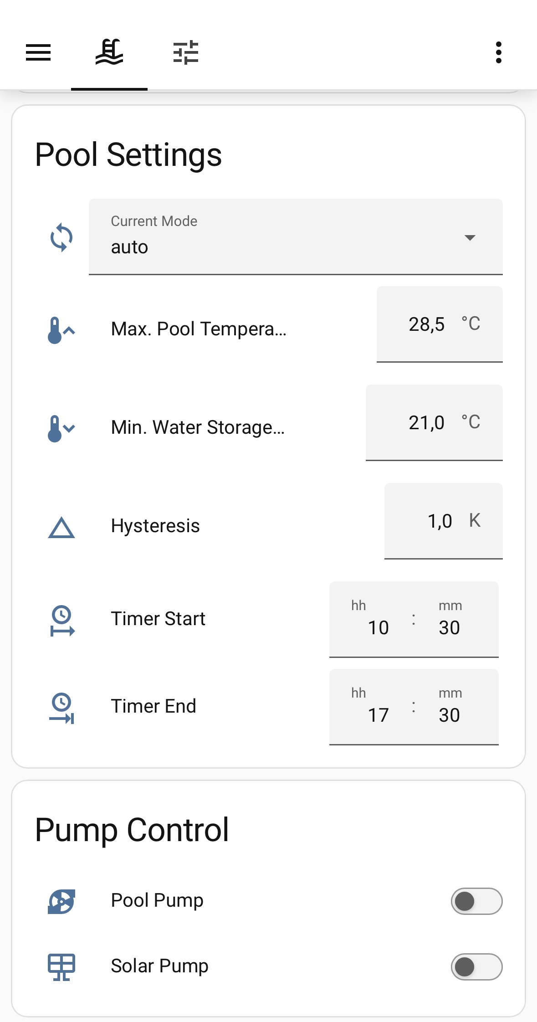
docs/img/IMG_8200.jpg
