smart-swimmingpool/pool-controller/docs/img/IMG_8207.jpg

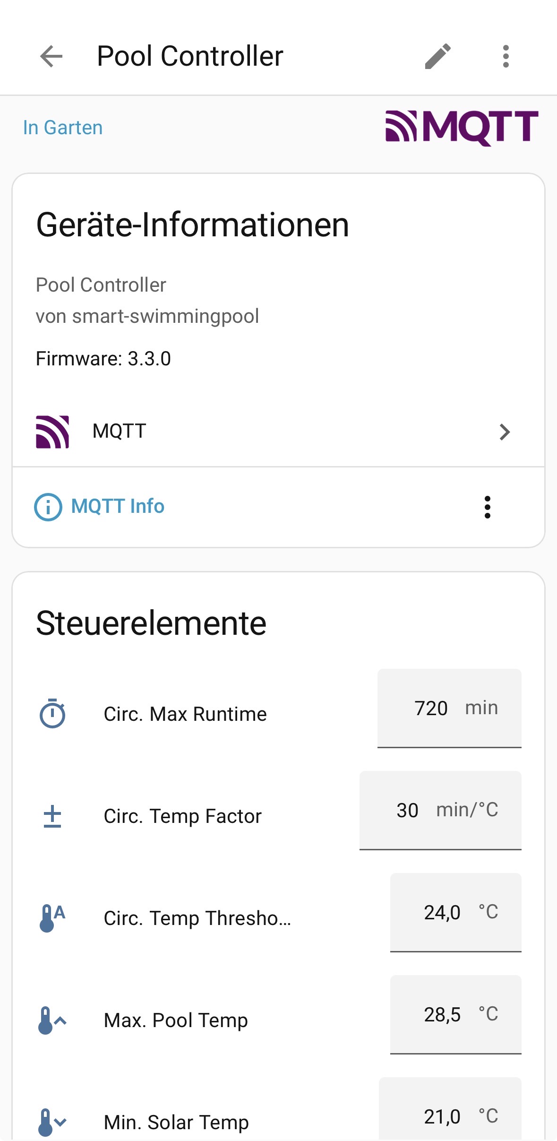
docs/img/IMG_8207.jpg
