smart-swimmingpool/pool-controller/docs/hardware-guide.de.md

---
title: Hardware-Anleitung
summary: Schritt-für-Schritt-Hardware-Anleitung für den ESP32-Pool-Controller — Teileliste mit Bezugsquellen, Schaltplan für DS18B20-Sensoren und Relaismodul, Löt- und Fertigungstipps, Stromversorgung und Inbetriebnahme
date: "2026-06-07"
lastmod: "2026-07-13"
draft: false
toc: true
type: docs
featured: true
tags: ["docs", "hardware", "anleitung", "schaltplan", "aufbau", "loeten"]
menu:
  docs:
    parent: Pool Controller
    name: Hardware-Anleitung
    weight: 20
---

## Übersicht

Diese Anleitung führt dich Schritt für Schritt durch den Hardware-Aufbau des
Pool-Controllers — von der Teileauswahl bis zur fertigen Schaltung. Auch wenn
du noch nie gelötet hast, helfen dir die detaillierten Erklärungen, alles
richtig zusammenzubauen.

> **Zielgruppe**: Elektronik-Bastler mit grundlegenden Lötkenntnissen.
> Gesamtkosten: **unter 100€** (ohne Pumpen und Pool-Infrastruktur).

## Sicherheitshinweise ⚠️

- Der Controller schaltet **230V Netzspannung** für die Pumpen. Fehlerhafte
  Verdrahtung kann zu Stromschlag oder Brand führen.
- Arbeite nur **spannungsfrei** an der Schaltung.
- Verwende einen **FI-Schutzschalter (RCD)** für den Pumpenstromkreis.
- Sensorleitungen (Niederspannung) und Netzleitungen **räumlich getrennt** führen.
- Im Zweifel die Netzinstallation von einem **Elektrofachbetrieb** prüfen lassen.

---

## Benötigte Teile (BOM)

| # | Bauteil | Menge |  ca. Preis  | Hinweise |
| --- | --- | :---: | :---: | --- |
| 1 | ESP32-Entwicklungsboard (z.B. ESP32 DevKit V1, NodeMCU-32S) | 1 | 10–15€ | Mindestens 4MB Flash |
| 2 | DS18B20-Temperatursensor (wasserfest, Edelstahl, 1m Kabel) | 2 | 8–12€ | Einer für Poolwasser, einer für Solarkollektor |
| 3 | 2-Kanal-5V-Relaismodul (mit Optokoppler) | 1 | 5–8€ | **Muss** active-high sein (siehe Hinweise) |
| 4 | Widerstand 4,7kΩ (¼W oder ⅛W, Metall- oder Kohleschicht) | 2 | < 1€ | Pull-up für die OneWire-Datenleitungen |
| 5 | Breadboard + Jumper-Kabel (zum Testen) **ODER** Lochrasterplatine + Stiftleisten/Schraubklemmen (für Daueraufbau) | 1 | 3–8€ | |
| 6 | USB-Netzteil 5V/≥1A (z.B. Handy-Ladegerät) | 1 | 5–10€ | Für den ESP32 allein |
| 7 | Schaltdraht, 0,14–0,5mm², verschiedene Farben | — | 3–5€ | |
| 8 | Optional: Gehäuse (ABS/PVC-Projektbox, IP54 oder besser) | 1 | 5–10€ | Schutz vor Spritzwasser/Staub |
| 9 | Optional: Schraubklemmen (2-polig, 5mm Raster) |  4–6  | 2–3€ | Für steckbare Sensor-/Stromanschlüsse |
| 10 | Optional: DS3231 RTC-Modul | 1 | 3–5€ | Backup-Uhr (nicht nötig bei NTP-Betrieb) |
| **Gesamt** | | | **~45–75€** | Ohne Gehäuse; deutlich unter 100€ |

### Bezugsquellen

Alle Teile gibt es bei Amazon, AliExpress, eBay oder bei Elektronik-Distributoren
wie:

- **Reichelt** (reichelt.de) — zuverlässig, schneller Versand in DE/AT
- **Pollin** (pollin.de) — günstige Komponenten
- **Conrad** (conrad.de) — großes Sortiment, etwas teurer
- **Amazon** — bequem, aber oft Aufpreis

Suchbegriffe:

- **ESP32**: "ESP32 DevKit V1" oder "ESP32 NodeMCU-32S". Kein ESP32-S2/S3/C3
  kaufen — die Firmware läuft auf dem Standard-ESP32 (Xtensa Dual-Core).
- **DS18B20**: **Edelstahl, wasserdicht** mit 1m Kabel. Günstige
  Kunststoff-Varianten gehen auch, sind aber weniger haltbar im Außeneinsatz.
- **Relaismodul**: **Achtung: Logikpegel prüfen!** Die Firmware schaltet per
  **active-high** (GPIO HIGH → Relais EIN). Viele günstige Module sind
  active-low (mit Jumper zum Umschalten). Vor dem Festlöten prüfen.

---

## Pin-Belegung (Firmware-Standard)

Die Firmware verwendet eine **optimierte Pin-Belegung**, die Strapping-Pins und
ADC2-Probleme vermeidet (Details siehe
[Alternative Pin-Belegung](#alternative-pin-belegung-original)). Definiert in
`src/Config.hpp`:

| Konstante | GPIO | Zweck |
| --- | :---: | --- |
| `PIN_DS_SOLAR` | **GPIO32** | DS18B20 Daten — Solarkollektor-Temperatur |
| `PIN_DS_POOL` | **GPIO33** | DS18B20 Daten — Pool-Wassertemperatur |
| `PIN_RELAY_POOL`  | **GPIO25** | Relais-Ansteuerung — Pool-Umwälzpumpe |
| `PIN_RELAY_SOLAR` | **GPIO26** | Relais-Ansteuerung — Solar-Heizungspumpe  |
| `PIN_LED_STATUS`  | **Eingebaute LED** | Status-LED (Homie-Blink-Codes) |

> **Hinweis**: Diese Pins sind auf maximale Kompatibilität ausgelegt. Die
> ursprüngliche Belegung (GPIO15/16/18/19) funktioniert ebenfalls, aber die
> optimierten Pins eliminieren jedes Boot-Risiko und vermeiden ADC2-Pins.

---

## Schaltplan

### Stromversorgung

```svgbob
 .---------------.        .---------------------.        .------------------.
 |  USB-Netzteil |        |        ESP32        |        |   Relaismodul    |
 |    5V, 1A+    |        |                     |        |     2 Kanal      |
 |               |        |                     |        |                  |
 |         5V o--+--------+--o VIN        5V o--+--------+--o VCC           |
 |               |        |                     |        |                  |
 |        GND o--+--------+--o GND       GND o--+--------+--o GND           |
 '---------------'        '---------------------'        '------------------'
```

### Sensoren

Beide Sensoren teilen sich die 3,3V-Schiene. Der 4,7kΩ-Widerstand ist die einzige Verbindung zwischen DATA und 3,3V.

```svgbob
 .---------------------.             .--------------------.
 |        ESP32        |             |   DS18B20 Solar    |
 |                     |             |                    |
 |           GPIO32 o--+----*--------+--o DATA            |
 |                     |    |        |                    |
 |                     | .--+--.     |                    |
 |                     | |4.7k |     |                    |
 |                     | '--+--'     |                    |
 |                     |    |        |                    |
 |              3V3 o--+----*--------+--o VDD             |
 |                     |             |                    |
 |              GND o--+-------------+--o GND             |
 '---------------------'             '--------------------'
```
```svgbob
 .---------------------.             .--------------------.
 |        ESP32        |             |    DS18B20 Pool    |
 |                     |             |                    |
 |           GPIO33 o--+----*--------+--o DATA            |
 |                     |    |        |                    |
 |                     | .--+--.     |                    |
 |                     | |4.7k |     |                    |
 |                     | '--+--'     |                    |
 |                     |    |        |                    |
 |              3V3 o--+----*--------+--o VDD             |
 |                     |             |                    |
 |              GND o--+-------------+--o GND             |
 '---------------------'             '--------------------'
```

### Relais-Steuersignale

```svgbob
 .---------------------.        .--------------------.
 |        ESP32        |        |    Relaismodul     |
 |                     |        |      2 Kanal       |
 |           GPIO25 o--+--------+--o IN1             |
 |           GPIO26 o--+--------+--o IN2             |
 |               5V o--+--------+--o VCC             |
 |              GND o--+--------+--o GND             |
 '---------------------'        '--------------------'
```

Statusanzeige: Die eingebaute LED (GPIO2) zeigt die Status-Blinkcodes (Homie).

---

## Schritt-für-Schritt-Verdrahtung

### 1. Temperatursensoren (DS18B20)

Der DS18B20 hat drei Adern (bei wasserdichten Fühlern: **rot = VDD**,
**gelb/weiß = DATA**, **schwarz = GND** — **immer mit Datenblatt deines
Sensors vergleichen!**):

| DS18B20-Ader | Farbe (typisch) | Anschluss |
| :---: | :---: | --- |
| VDD | **Rot** | ESP32 **3,3V** |
| GND | **Schwarz** | ESP32 **GND** |
| DATA |  **Gelb/Weiß**  | ESP32 **GPIO32** (Solar) oder **GPIO33** (Pool) |

**Wichtig — den 4,7kΩ-Pull-Up-Widerstand nicht vergessen:**

Jede DATA-Leitung **muss** über einen **4,7kΩ-Widerstand** mit **3,3V**
verbunden werden. Ohne diesen Widerstand wird der Sensor nicht erkannt —
das ist die **häufigste Fehlerquelle**.

```svgbob
 Solar DATA o----[ 4.7k ]----o 3V3
 Pool  DATA o----[ 4.7k ]----o 3V3
```

Löte den Widerstand möglichst nahe am ESP32-Pin-Header, zwischen DATA-Pin
und der 3,3V-Schiene. Geeignet ist jeder 4,7kΩ ±5%-Widerstand (¼W oder ⅛W,
Metall- oder Kohleschicht).

### 2. Relaismodul

| Relais-Anschluss | Typische Bezeichnung | Anschluss |  Kabelfarbe |
| :---: | :---: | --- | :---: |
| Modul-Versorgung | `VCC` oder `VDD` | **5V** (vom ESP32-VIN oder externem 5V-Netzteil) | **Rot** |
| Masse | `GND` | **GND** (gemeinsame Masse mit ESP32) |  **Schwarz**  |
| Steuereingang 1  | `IN1` oder `D1` | **GPIO25** (Pool-Pumpe) | **Gelb/Blau** |
| Steuereingang 2  | `IN2` oder `D2` | **GPIO26** (Solar-Pumpe) | **Grün/Blau** |

**Wichtig — Logikpegel**: Die Firmware setzt den GPIO-Pin auf **HIGH (3,3V)**
um das Relais zu aktivieren (active-high). Wenn dein Modul bei LOW schaltet
(active-low), suche nach einem **Jumper** auf der Modulplatine, um den Modus
zu wechseln. Active-high-Module sind einfacher in der Handhabung.

**Lastseite (230V-Seite) — Standard-Relaismodul:**

Lastseite des Relais (230V AC), dargestellt ist Kanal 1.
Kanal 2 (Solarpumpe) wird identisch verdrahtet. Der Neutralleiter geht direkt von der Neutralschiene zur Pumpe und wird nicht geschaltet.

```svgbob
 .-------------.   .---------------.   .---------------.   .----------------.   .-------------.
 |     Netz    |   |       FI      |   |       LS      |   |  Relaismodul   |   |    Pumpe    |
 |   230V AC   |   |               |   |               |   |    Kontakt     |   |             |
 |             |   |               |   |               |   |                |   |             |
 |        L o--+---+--o in  out o--+---+--o in  out o--+---+--o COM   NO o--+---+--o L        |
 '-------------'   '---------------'   '---------------'   '----------------'   '-------------'
```

- Den Außenleiter (L) der Pumpe an den **COM**-Kontakt (Mitte) des Relais.
- Den **NO**-Kontakt (Schließer, "normally open") mit der Pumpe verbinden.
- Den anderen Pumpenanschluss an **Neutralleiter (N)**.
- Den 230V-Stromkreis **immer** über einen FI-Schutzschalter und einen
  passend abgesicherten Leitungsschutzschalter führen.

   ╔══════════════════════════════════════════════════════════════════════╗
   ║  ⚠ WICHTIG — Grenze bei Motorlast (gleiches Problem wie NORVI)     ║
   ║                                                                     ║
   ║  Externe 5V-Relaismodule (z.B. SRD-05VDC-SL-C) sind für ohmsche    ║
   ║  Last spezifiziert (typ. 10A/250V AC). Eine **Pumpe ist eine        ║
   ║  induktive Motorlast** mit 5–10× höherem Einschaltstrom, der die    ║
   ║  Relaiskontakte nach wiederholtem Schalten verschweißen kann —      ║
   ║  genauso wie bei den NORVI-Bordrelais.                              ║
   ║                                                                     ║
   ║  Falls du Pumpen oder andere Motorlasten >300W schaltest:           ║
   ║  → Verwende das ESP32-Relais nur zur Ansteuerung eines              ║
   ║    **Hutschienen-Schützes** (Contacteur)                            ║
   ║  → Das Schütz übernimmt die Motorlast; das 5V-Relais ist nur        ║
   ║    noch die Steuerschnittstelle (kein Kontaktverschleiß)            ║
   ║                                                                     ║
   ║  Siehe → **[Schütz-Schaltung für Pumpen](contactor-guide.de.md)**   ║
   ╚══════════════════════════════════════════════════════════════════════╝

### 3. Stromversorgung

| Komponente | Spannung | Quelle | Hinweise |
| --- | :---: | --- | --- |
| ESP32-Board |  **5V**  | USB-Ladebuchse (am ESP32) | Versorgt Board + stellt 5V am VIN-Pin bereit |
| Relaisspulen |  **5V**  | ESP32-VIN-Pin (gleicher USB-Eingang) | Relaismodul bezieht Strom aus derselben 5V-Versorgung |
| DS18B20-Sensoren | **3,3V** | ESP32-3V3-Ausgangspin | Beide Sensoren teilen sich 3,3V-Schiene |
| (Optional) RTC DS3231 | **3,3V** | ESP32-3V3-Ausgangspin | Dieselbe Schiene wie Sensoren |

> **Wichtig**: Der eingebaute 3,3V-Spannungsregler des ESP32 liefert ca. 600mA.
> Die DS18B20-Sensoren brauchen zusammen < 5mA — völlig unkritisch. Wenn du
> viele zusätzliche 3,3V-Komponenten anschließt, einen externen 3,3V-Regler
> verwenden.

---

## Aufbau-Schritte

### Testaufbau auf dem Breadboard

1. **ESP32 aufstecken** — mittig auf dem Breadboard, über die Mittellücke
2. **Stromschienen verbinden** — 3,3V und GND auf beiden Seiten
3. **Pull-Up-Widerstände einstecken** — zwischen DATA-Reihe und 3,3V-Schiene
4. **DS18B20-Sensoren anschließen** — Jumper-Kabel für VDD (3,3V), GND und DATA
5. **Relaismodul anschließen** — Jumper für VCC (5V), GND, IN1, IN2
6. **Stromversorgung per USB** — Der VIN/USB-Pin des ESP32 liefert 5V fürs
   Relaismodul
7. **Alle Verbindungen prüfen** bevor du Spannung anlegst
8. **Test**: Siehe [Inbetriebnahme](#inbetriebnahme-und-test)

{{< figure
  library="true"
  src="pool-controller_breadboard.png"
  title="Pool-Controller Breadboard-Aufbau mit ESP32, zwei DS18B20-Temperatursensoren, 4,7kΩ-Pull-Up-Widerständen und 2-Kanal-Relaismodul"
  lightbox="true" >}}

> 💡 **Tipp**: Unterschiedliche Jumper-Farben verwenden — z.B. rot für
> Spannung (3,3V/5V), schwarz für Masse (GND), gelb für Sensordaten, blau für
> Relais-Steuerung.

### Dauerhafter Aufbau auf Lochrasterplatine

Wenn der Testaufbau auf dem Breadboard funktioniert, baust du die endgültige
Version:

1. **Layout planen**: Komponenten vor dem Löten auf der Platine anordnen.
   230V-Relais-Anschlüsse an einer Kante, Sensoranschlüsse an der gegenüber-
   liegenden Seite.
2. **In dieser Reihenfolge löten**:
   - Stiftleisten / Schraubklemmen für den ESP32 (fasse ihn in eine Sockelleiste,
     löte nicht direkt auf die Platine)
   - Widerstände (4,7kΩ)
   - Stiftleisten fürs Relaismodul (auch hier sockeln)
   - Schraubklemmen für Sensoranschlüsse
3. **Verbindungen führen**: Massivdraht für die Verbindungen. Datenleitungen
   kurz halten.
4. **Auf Lötzinnbrücken prüfen**: Jede Lötstelle mit der Lupe oder Multimeter
   (Durchgangsprüfung) kontrollieren.
5. **Ins Gehäuse einbauen**: Abstandsbolzen oder doppelseitiges Klebeband
   verwenden. Löcher für Sensor- und Relaiskabel bohren. **Kabelverschraubungen**
   (PG7/PG9) für wasserdichte Kabeldurchführung nutzen.

---

## Fertigungstipps

### Löten

- **Blei-Lot verwenden** (Sn60Pb40 oder Sn63Pb37) — es fließt besser als
  bleifreies Lot, besonders für Anfänger. (In DE/AT für Hobbyzwecke weiterhin
  erlaubt und empfohlen.)
- **Flussmittel**: Flussmittelkern-Lot nehmen; bei widerspenstigen Lötstellen
  zusätzlich Flüssig-Flussmittel.
- **Temperatur**: Lötkolben auf 320–350°C (Bleilot) oder 370–400°C (bleifrei)
  einstellen.
- **Spitze sauber halten**: Vor **jeder** Lötstelle an feuchtem Schwamm oder
  Messingwolle reinigen.
- **Gute Lötstelle**: Glänzend, konkave Verrundung, die um den Draht herum
  fließt. Eine matte, rissige oder kugelförmige Stelle ist **schlecht** —
  nachwärmen und frisches Lot zugeben.

### Gehäuse

- **ABS- oder PVC-Projektbox** mit mindestens IP54-Schutzart für den
  Außeneinsatz (Spritzwasserschutz).
- **Lüftungsschlitze** bohren, wenn das Relaismodul warm wird — aber nach
  unten gerichtet, damit kein Wasser eindringt.
- ESP32 auf **M2,5- oder M3-Nylon-Abstandsbolzen** montieren, um
  Kurzschlüsse zu vermeiden.
- Außenanschlüsse beschriften (Pool-Sensor, Solar-Sensor, Pumpe 1, Pumpe 2,
  USB-Strom).
- **Kabelverschraubungen** (PG7 für dünne Sensorkabel, PG9 für dickere
  Stromkabel) an den Kabeleinführungen verwenden.

### Kabelmanagement

- **Beide Enden jedes Kabels beschriften** — mit Schrumpfschlauch-Etiketten
  oder kleinen Klebeetiketten. Zukünftiges Du wird es dir danken.
- **Sensor- und Relaiskabel getrennt führen** im Gehäuse, um
  Einstreuungen zu minimieren.
- **Zugentlastung**: Kabel an Montagepunkten oder mit Kabelbindern fixieren,
  damit Zug an den Außenkabeln nicht die Lötstellen belastet.
- **Service-Schlaufe**: Genug Drahtreserve im Gehäuse lassen, damit du es
  öffnen und arbeiten kannst ohne alles zu trennen.

### Sensoren im Außenbereich

- **DS18B20-Fühler** sind wasserdicht, aber der Kabeleingang am Sensor ist
  nicht immer dicht. **Schrumpfschlauch** über die Kabelverbindung ziehen
  oder **selbstverschmelzendes Silikonband** für Außeninstallationen.
- Sensorkabel in **Leerrohr** (PVC oder flexibel) verlegen, wo sie
  mechanisch belastet werden (Rasen, Einfahrt).
- **Maximale Kabellänge**: DS18B20 funktioniert zuverlässig bis ca. 30m mit
  4,7kΩ-Pull-up und verdrilltem Kabel. Bei längeren Strecken den Pull-up auf
  2,2kΩ verringern oder einen OneWire-Treiber verwenden.
- Pool-Sensor in den **Pumpenkreislauf** einbauen (nach dem Filter, vor dem
  Rücklauf) für eine genaue Durchschnittstemperatur.
- Solar-Sensor an der **heißesten Stelle des Solarkollektors** (meist das
  obere Austrittsrohr) anlegen.

---

## Stromversorgungs-Optionen

| Option | Vorteile | Nachteile |
| --- | --- | --- |
| **USB-Handy-Ladegerät** (5V/1A+) | Günstig, überall verfügbar, sicher | Begrenzter Strom für Zusatzgeräte |
| **Hutschienen-Netzteil** (Mean Well HDR-15-5 o.ä.) | Professionell, zuverlässig, passt in Verteiler | Etwas teurer (~15€) |
| **ESP32-VIN via USB** + Relais von derselben 5V | Einfache Verdrahtung | Gesamtstrom muss unter Grenze des ESP32-Boards bleiben |

**Empfehlung**: Wenn du einen festen Installationsort in der Nähe deiner
Pumpensteuerung hast, nimm ein **Hutschienen-5V-Netzteil** (z.B. Mean Well
HDR-15-5). Das ist sauber, zuverlässig und versorgt ESP32 und Relaismodul
problemlos.

> **Alternative — Industriesteuerung:** Der [NORVI IIOT-AE01-R](norvi-ae01-r.de.md)
> ist ein ESP32-basierter Industriecontroller mit **integrierten Relais,
> 24V-DC-Versorgung, Hutschienenmontage und CE-Zertifizierung**. Wenn du bereits
> ein 230V AC → 24V DC Netzteil hast, wird kein zusätzliches 5V-Netzteil
> benötigt. Siehe [NORVI AE01-R Konfigurationsanleitung](norvi-ae01-r.de.md) für
> Details.

---

## Inbetriebnahme und Test

### 1. Sichtprüfung

Vor dem Anlegen der Spannung:

- Auf **Lötbrücken** zwischen benachbarten Pins prüfen
- **Polung** aller Komponenten kontrollieren (DS18B20 VDD/GND, Relais VCC/GND)
- **Keine losen Drahtenden**, die benachbarte Pins kurzschließen
- Widerstand zwischen **3,3V und GND** messen — sollte > 10kΩ sein (kein Kurzschluss)

### 2. Einschalten

1. USB-Strom (oder 5V-Netzteil) anschließen
2. Die **eingebaute LED** zeigt den Systemstatus nach Homie-Convention:
   - **Schnelles Blinken (5 Hz)** — AP-Modus (kein WLAN konfiguriert)
   - **Langsames Blinken (1 Hz)** — WLAN-Verbindung läuft
   - **Meist an, kurzes Blinken alle 2s** — WLAN OK, MQTT getrennt
   - **Dauerhaft an** — WLAN + MQTT verbunden

### 3. Sensoren prüfen

Serielles Monitor öffnen (115200 Baud):

```
Pool Controller v3.3.0
Starting up...
✓ Pin configuration validated - no conflicts (optimierte Belegung)
  Solar Temp (DS18B20): GPIO32
  Pool Temp  (DS18B20): GPIO33
  Pool Pump  (Relay):   GPIO25
  Solar Pump (Relay):   GPIO26
  Status LED:           GPIO2 (LED_BUILTIN)
```

Wenn die Sensoren angeschlossen sind und funktionieren:

```
Solar temperature: 25.3°C
Pool temperature:  22.1°C
```

Bei `Sensor error` oder `-127°C`, prüfe:

- [ ] 4,7kΩ-Pull-up-Widerstand auf jeder DATA-Leitung vorhanden?
- [ ] DS18B20 VDD an 3,3V (nicht 5V)?
- [ ] DS18B20 GND an gemeinsamer Masse?
- [ ] DATA-Pin stimmt mit Firmware-Konfiguration überein?

### 4. Relais testen

Über das Web-UI (Reiter Konfiguration) oder per seriellem Befehl:

```
Mode: manual
Pool pump: ON  → Relais klickt hörbar, Pumpe läuft an
Solar pump: ON → Relais klickt hörbar, Pumpe läuft an
```

Wenn das Relais nicht klickt:

- [ ] Ist das Relaismodul mit Strom versorgt (5V zwischen VCC und GND)?
- [ ] Stimmt der Logikpegel (active-high vs. active-low)?
- [ ] Leuchtet die LED auf dem Relaismodul, wenn GPIO auf HIGH geht?

---

## ⚠ Wichtig: Relaiskontakte bei Motorlast (Pumpen)

Die verwendeten Relais (NORVI-Bordrelais wie auch externe 5V-Module) sind für
**ohmsche Lasten** spezifiziert. Eine **Pumpe ist eine induktive Motorlast**
mit 5–10× höherem Einschaltstrom (Inrush). Dies kann nach einigen hundert
Schaltvorgängen zu **verschweißten Relaiskontakten** führen — das Relais
klickt dann zwar noch, aber der NO-Kontakt trennt nicht mehr, und die Pumpe
läuft dauerhaft, obwohl der Controller AUS anzeigt.

**Empfehlung:** Verwende bei Pumpen >300W grundsätzlich **externe
Installationsschütze** zwischen Relais und Pumpe. Das Relais schaltet dann
nur die 24V-Spule des Schützes (einige mA) — die Hauptkontakte des Schützes
schalten die 230V-Last. Siehe die separate Anleitung:

👉 **[Schütz-Schaltung für Pumpen – Anleitung](contactor-guide.de.md)**

## Fehlersuche

| Symptom | Wahrscheinliche Ursache | Lösung |
| --- | --- | --- |
| "Sensor error" oder `-127°C` | Pull-up-Widerstand fehlt | 4,7kΩ zwischen DATA und 3,3V einlöten |
| "Sensor error" | Falscher GPIO-Pin | `PIN_DS_SOLAR`/`PIN_DS_POOL` in `src/Config.hpp` prüfen |
| Unbeständige Messwerte | Wackelkontakt oder Einstreuungen | Lötstellen prüfen, Daten- und Relaisleitungen trennen |
| Relais schaltet nicht | Falscher Logikpegel | Active-high vs. active-low prüfen; Jumper umstecken |
| Relais klickt, Pumpe läuft nicht | 230V-Verdrahtungsfehler | COM/NO-Kontakte prüfen, Pumpenanschluss kontrollieren |
| Pumpe läuft trotz AUS-Anzeige | Relaiskontakt verschweißt (Motorlast) | **Schütz zwischenschalten** (siehe [Schütz-Anleitung](contactor-guide.de.md)) |
| ESP32 startet nicht (Brownout) | Zu schwache Stromversorgung | 5V/≥1A-Netzteil verwenden; 100µF-Kondensator nahe VIN |
| ESP32 resetet beim Relais-Schalten | Spannungsspitze an der Relais-Spule | Freilaufdiode parallel zur Spule, oder Modul mit eingebautem Schutz |
| Messwerte springen beim Schalten | Elektrisches Rauschen | Sensorleitungen getrennt von Relais-/Stromkabeln führen |

---

## Alternative Pin-Belegung (Original)

Die Firmware verwendet jetzt standardmäßig die **optimierten Pins (GPIO32/33/25/26)**
(siehe [Pin-Belegung](#pin-belegung-firmware-standard) oben). Die ursprüngliche
Belegung (GPIO15/16/18/19) steht als Alternative zur Verfügung, falls du
Legacy-Hardware oder bestimmte Shield-Boards verwenden möchtest:

```cpp
constexpr uint8_t PIN_DS_SOLAR{15};     // war 32
constexpr uint8_t PIN_DS_POOL{16};      // war 33
constexpr uint8_t PIN_RELAY_POOL{18};   // war 25
constexpr uint8_t PIN_RELAY_SOLAR{19};  // war 26
```

| Funktion | Optimiert (Default) | Original-Pin | Grund der Änderung |
| --- | :---: | :---: | --- |
| DS18B20 Solar | **GPIO32** | GPIO15 | GPIO15 ist Strapping-Pin — OneWire entfernt Boot-Risiko |
| DS18B20 Pool  | **GPIO33** | GPIO16 | Saubere Trennung vom verbleibenden Strapping-Pin GPIO0 |
| Relais Pool | **GPIO25** | GPIO18 | ADC2-Pins (18/19) vermieden; GPIO25 ist sauberer Digitalausgang |
| Relais Solar  | **GPIO26** | GPIO19 | Gleicher Grund wie oben |

Die Optimierung ist im Dokument
[ESP32 Schaltplananalyse und Optimierung](esp32-schematic-optimization.de.md)
ausführlich analysiert und begründet.

---

## LED-Status-Codes (Homie-Convention)

Der Controller nutzt die **eingebaute LED** zur Signalisierung des
Systemzustands nach der [Homie Convention](https://homieiot.github.io/),
dem Standard für IoT-Statusanzeigen.

| LED-Muster | Systemzustand | Darstellung |
| --- | --- | --- |
| **Schnelles Blinken** (100ms an/aus = 5 Hz) | **AP-Modus** — kein WLAN konfiguriert, Setup-Portal aktiv | |
| **Langsames Blinken** (500ms an/aus = 1 Hz) | **Verbindungsaufbau** — WLAN-Verbindung läuft | WLAN-Verbindung |
| **Meist an, kurzer Aus-Blinker alle 2s** | **WLAN OK, MQTT getrennt** — Netzwerk aktiv, Broker nicht erreichbar | MQTT getrennt |
| **Dauerhaft an** | **Voll verbunden** — WLAN + MQTT betriebsbereit | |
| **Sehr schnelles Blinken** (50ms an/aus = 10 Hz) | **OTA-Update** — Firmware-Download/-Installation aktiv | |
| **Doppel-Blink** (200/200/200/600ms) | **Safe-Mode** — Boot-Loop erkannt oder kritische Degradation | |

**Was beim ersten Einschalten passiert:**

1. **Schnelles Blinken** — AP-Modus (noch kein WLAN konfiguriert)
2. Nach WLAN-Konfiguration im Webportal → **langsames Blinken** während der Verbindung
3. Sobald WLAN verbunden → **meist an** während MQTT-Verbindung
4. **Dauerhaft an** — alles läuft normal

> **Tipp**: Bleibt die LED nach dem Einschalten im **schnellen Blinken**,
> öffne das WLAN-Netzwerk `Pool-Controller-Setup`, um dein Heim-WLAN zu
> konfigurieren.

---

## Referenzen

- Fritzing-Quelldatei: [pool-controller.fzz](pool-controller.fzz)
- [KiCad-Schaltplan: ESP32 Dev Board](kicad/esp32-dev-board/esp32-dev-board-schematic.pdf) — KiCad-9.0-PDF-Export
- [KiCad-Schaltplan: NORVI AE01-R](kicad/norvi-ae01-r/norvi-ae01-r-schematic.pdf) — KiCad-9.0-PDF-Export
- [NORVI AE01-R Konfigurationsanleitung](norvi-ae01-r.de.md) — Industrie-ESP32-Controller Pinbelegung & Verdrahtung
- [ESP32 Schaltplananalyse und Optimierung](esp32-schematic-optimization.de.md)
- [ESP32 Komplett-Schaltplan](esp32-complete-wiring-schematic.de.md)
- [Schütz-Schaltung für Pumpen](contactor-guide.de.md) — Externe Schütze für dauerhaft zuverlässiges Pumpenschalten
- [SVG-Schaltplan: Schütz-Schaltung](wiring-contactor.svg)
- [DS18B20 Datenblatt](https://www.analog.com/media/en/technical-documentation/data-sheets/DS18B20.pdf)
- [ESP32 Pin-Referenz](https://docs.espressif.com/projects/esp-idf/en/latest/esp32/api-reference/peripherals/gpio.html)
- [Config.hpp Pin-Quelle](https://github.com/smart-swimmingpool/pool-controller/blob/main/src/Config.hpp)
