smart-swimmingpool/pool-controller/(threads)

Thread 3 (2019-08-03):

Automatic adjustable filtration runs

stritti, 2019-08-03:
The pool user wants automatic calculation of filtration runs depending on water temperature to have optimal water quality.

Verify, that
* the water of the pool is completely filtered at 20°C on time.
* the water of the pool is completely filtered at 28°C twice.
* the volume of the pool (m³) is configurable.
* the pump capacity (m³/h) is configurable.

See also:
https://poolinfos.de/poolfilter/pumpe/dimensionierung-poolpumpe-berechnen/
https://poolinfos.de/poolfilter/sandfilter/richtige-laufzeit-der-sandfilteranlage/

Thread 7 (2020-08-03):

Memory leaks

MrTroble, 2020-08-03:
https://github.com/smart-swimmingpool/pool-controller/blob/97b6b59d9d36d87e5567086f0d6f9f531a3b8d4a/src/DallasTemperatureNode.cpp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

Sie zerstören die Memory nie, da sie keinen Dekonstruktor haben. Daher entsteht hier ein Memory leak, weil die Ressourcen nicht mehr freigegeben werden.

"An object created by 'new' lives until destroyed by delete" - Bjarne Stroustrup, A Tour of C++

Ich schlage vor einfach das new weg zu lassen und die (de)allocation RAII zu überlassen.

 ```c++
oneWire = OneWire(_pin);
sensor  = DallasTemperature(oneWire);
```

Ich würde auch raten das überall zu ändern.

MrTroble, 2020-09-16:
I will try to make a PR to fix all memory leaks that I can find in the next couple of days.
Let's see how this will go...

Closed 2022-01-11.

Thread 9 (2020-09-16):

After several days the controller looses WIFI connection

stritti, 2020-09-16:
After several days (3-4) the controller looses WIFI connection and does not reconnect automatically.
A restart is required. Probably also a result of https://github.com/smart-swimmingpool/pool-controller/issues/7

May be a restart could be initiated by something like mentioned on Twitter:
https://twitter.com/Alpensichtung/status/1304730957598142466

MrTroble, 2020-09-16:
I would certainly try to find the underlying issue then just restarting the controller xD
I can say with confidence that memory leaks can cause such behavior.

MrTroble, 2020-09-16:
I can look over it in the next couple of days

MrTroble, 2020-09-24:
So it would be good to know if it only kills the wifi or it just kills the whole device. I have the feeling that the growing log exceeds the memory limit at some point and just kills everything because it overflows. Haven't tried to look deeper into it tho

stritti, 2020-09-25:
It seems to just drop the connection. The system LED is blinking for status "connecting Wi-Fi..."

Thread 11 (2021-01-11):

Config.json file is ignored if additional settings are not defined

2delarosa, 2021-01-11:
To bypass the GUI config mode, one must define loglevel, logserial, and flushlog in the settings section of the config.json for it to be valid.  See log output below for loglevel

12:42:52.553 > 68 [DEBUG]: void setup(): Before Homie setup())
12:42:52.608 > ✖ Config file is not valid, reason: loglevel setting is missing
12:42:52.614 > Configuration invalid. Using CONFIG MODE
12:42:52.692 > 💡 Firmware pool-controller (2.0.0)
12:42:52.692 > 🔌 Booting into config mode 🔌

Thread 12 (2021-01-11):

Implement invert signal in RelayModuleNode.cpp

2delarosa, 2021-01-11:
Simple enhancement to accommodate a greater number of relays and configuration options.

  relay = new RelayModule(_pin, **true**); // The second parameter is whether to invert the signal.  The default value is false if omitted.

Thread 13 (2021-02-17):

Add WPS mode for WiFi connection

stritti, 2021-02-17:
For initial connection WPS should be supported.

See:

https://github.com/espressif/arduino-esp32/blob/master/libraries/WiFi/examples/WPS/WPS.ino

https://www.az-delivery.de/blogs/azdelivery-blog-fur-arduino-und-raspberry-pi/wps-mit-dem-esp8266

Thread 14 (2021-08-10):

Wemos D1 mini Pro crashed in debug mode because of watchdog reset

breezer15, 2021-08-10:
Hi,

I wanted to run the pool controller on a "Wemos D1 mini Pro".

Unfortunately the ESP always crashed (WDT reset), see in the log.

The code is only executable when I change "build_type = release" to "build_type = build" in the platformio.ini.

Is it possible that the code is too slow in debug mode or that the serial interface is too slow and the watchdog is triggered as a result?

Many greetings

log:
```
11:29:27.817 > ✖ /homie/config.json doesn't exist

11:29:27.817 > Configuration invalid. Using CONFIG MODE

11:29:27.817 > 💡 Firmware pool-controller (2.0.0)

11:29:27.817 > 🔌 Booting into config mode 🔌

11:29:27.817 > Device ID is f4cfa2d0904a

11:29:27.817 > AP started as smart-swimmingpool-f4cfa2d0904a with IP 192.168.123.1

11:29:27.817 > 1227 [DEBUG]: void setup(): ngpool-f4cfa2d0904a
11:29:27.817 > Free heap: 31080

11:29:27.817 > Triggering Wi-Fi scan...

11:29:35.377 >

11:29:35.378 >  ets Jan  8 2013,rst cause:4, boot mode:(3,7)

11:29:35.378 >

11:29:35.378 > wdt reset

11:29:35.378 > load 0x4010f000, len 3656, room 16

11:29:35.384 > tail 8

11:29:35.385 > chksum 0x0c

11:29:35.385 > csum 0x0c

11:29:35.385 > v9c56ed1f

11:29:35.385 > ~ld
11:29:35.456 > 72 [DEBUG]: void setup(): Before Homie setup())
11:29:36.547 > ✖ /homie/config.json doesn't exist

11:29:36.548 > Configuration invalid. Using CONFIG MODE

11:29:36.625 > 💡 Firmware pool-controller (2.0.0)

11:29:36.626 > 🔌 Booting into config mode 🔌

11:29:36.626 > Device ID is f4cfa2d0904a

11:29:36.626 > AP started as smart-swimmingpool-f4cfa2d0904a with IP 192.168.123.1

11:29:36.626 > 1228 [DEBUG]: void setup(): ngpool-f4cfa2d0904a
11:29:36.626 > Free heap: 31080

11:29:36.626 > Triggering Wi-Fi scan...

11:29:44.999 >

11:29:44.999 >  ets Jan  8 2013,rst cause:4, boot mode:(3,7)

11:29:44.999 >

11:29:44.999 > wdt reset

11:29:44.999 > load 0x4010f000, len 3656, room 16

11:29:45.006 > tail 8

11:29:45.006 > chksum 0x0c

11:29:45.006 > csum 0x0c

11:29:45.006 > v9c56ed1f

11:29:45.006 > ~ld
```

platformio.ini:
```
; PlatformIO Project Configuration File
;
;   Build options: build flags, source filter
;   Upload options: custom upload port, speed and extra flags
;   Library options: dependencies, extra library storages
;   Advanced options: extra scripting
;
; Please visit documentation for the other options and examples
; https://docs.platformio.org/page/projectconf.html

[platformio]
;default_envs = esp32dev
;default_envs = nodemcuv2
default_envs = d1_mini_pro

[common]
; build_flags = -g -DDEBUG_PORT=Serial
;Add the PIO_FRAMEWORK_ARDUINO_LWIP2_LOW_MEMORY build flag to ensure reliable OTA updates.
build_flags = -D PIO_FRAMEWORK_ARDUINO_LWIP2_LOW_MEMORY

; serial_speed = 74880
serial_speed = 115200

; You MUST inject these options into [env:] section
; using ${common_env_data.***} (see below)
[common_env_data]
lib_deps =
	DallasTemperature
	Wire
	paulstoffregen/OneWire
	Adafruit Unified Sensor
	DHT sensor library
	RelayModule
	NTPClient @ 3.1.0
	TimeZone @ 1.2.4
	ArduinoJson @ 6.18.0
	me-no-dev/ESP Async WebServer
  	thomasfredericks/Bounce2
  	marvinroger/AsyncMqttClient
	Homie
	; git+https://github.com/xoseperez/Time.git
	; git+https://github.com/homieiot/homie-esp8266.git#develop
	;../homie-esp8266

[env:esp32dev]
platform = espressif32
board = esp32dev
framework = arduino
build_flags = -D SERIAL_SPEED=${common.serial_speed}
build_unflags = -Werror=reorder
lib_deps = ${common_env_data.lib_deps}
monitor_speed = ${common.serial_speed}

; Monitor filters: https://docs.platformio.org/en/latest/core/userguide/device/cmd_monitor.html#filters
monitor_filters = esp32_exception_decoder, log2file, time, default

upload_speed = 230400
;upload_protocol = esptool
;upload_port = 192.168.178.23
;upload_flags =
;  --timeout=20
;  --port=3232
;   --auth=st25277472

; Unit Testing options
test_ignore = test_desktop

[env:nodemcuv2]
platform = espressif8266 @ 2.5.0
board = nodemcuv2
framework = arduino
build_type = debug
build_flags = -D SERIAL_SPEED=${common.serial_speed}
lib_deps = ${common_env_data.lib_deps}
monitor_speed = ${common.serial_speed}

; Monitor filters: https://docs.platformio.org/en/latest/core/userguide/device/cmd_monitor.html#filters
monitor_filters = esp8266_exception_decoder, log2file, time, default

upload_speed = 230400
test_ignore = test_desktop

[env:d1_mini_pro]
platform = espressif8266 @ 2.5.0
board = d1_mini_pro
board_build.filesystem = SPIFFS
board_build.ldscript = eagle.flash.8m7m.ld
framework = arduino
build_type = debug
build_flags = -D SERIAL_SPEED=${common.serial_speed}
lib_deps = ${common_env_data.lib_deps}
monitor_speed = ${common.serial_speed}

; Monitor filters: https://docs.platformio.org/en/latest/core/userguide/device/cmd_monitor.html#filters
monitor_filters = esp8266_exception_decoder, log2file, time, default

upload_speed = 115200
```

stritti, 2021-08-15:
Hm, probably the memory of D1 is too small. The release version is smaller than debug version.
