smart-swimmingpool/pool-controller/docs/kicad/esp32-dev-board/esp32-dev-board-schematic.pdf

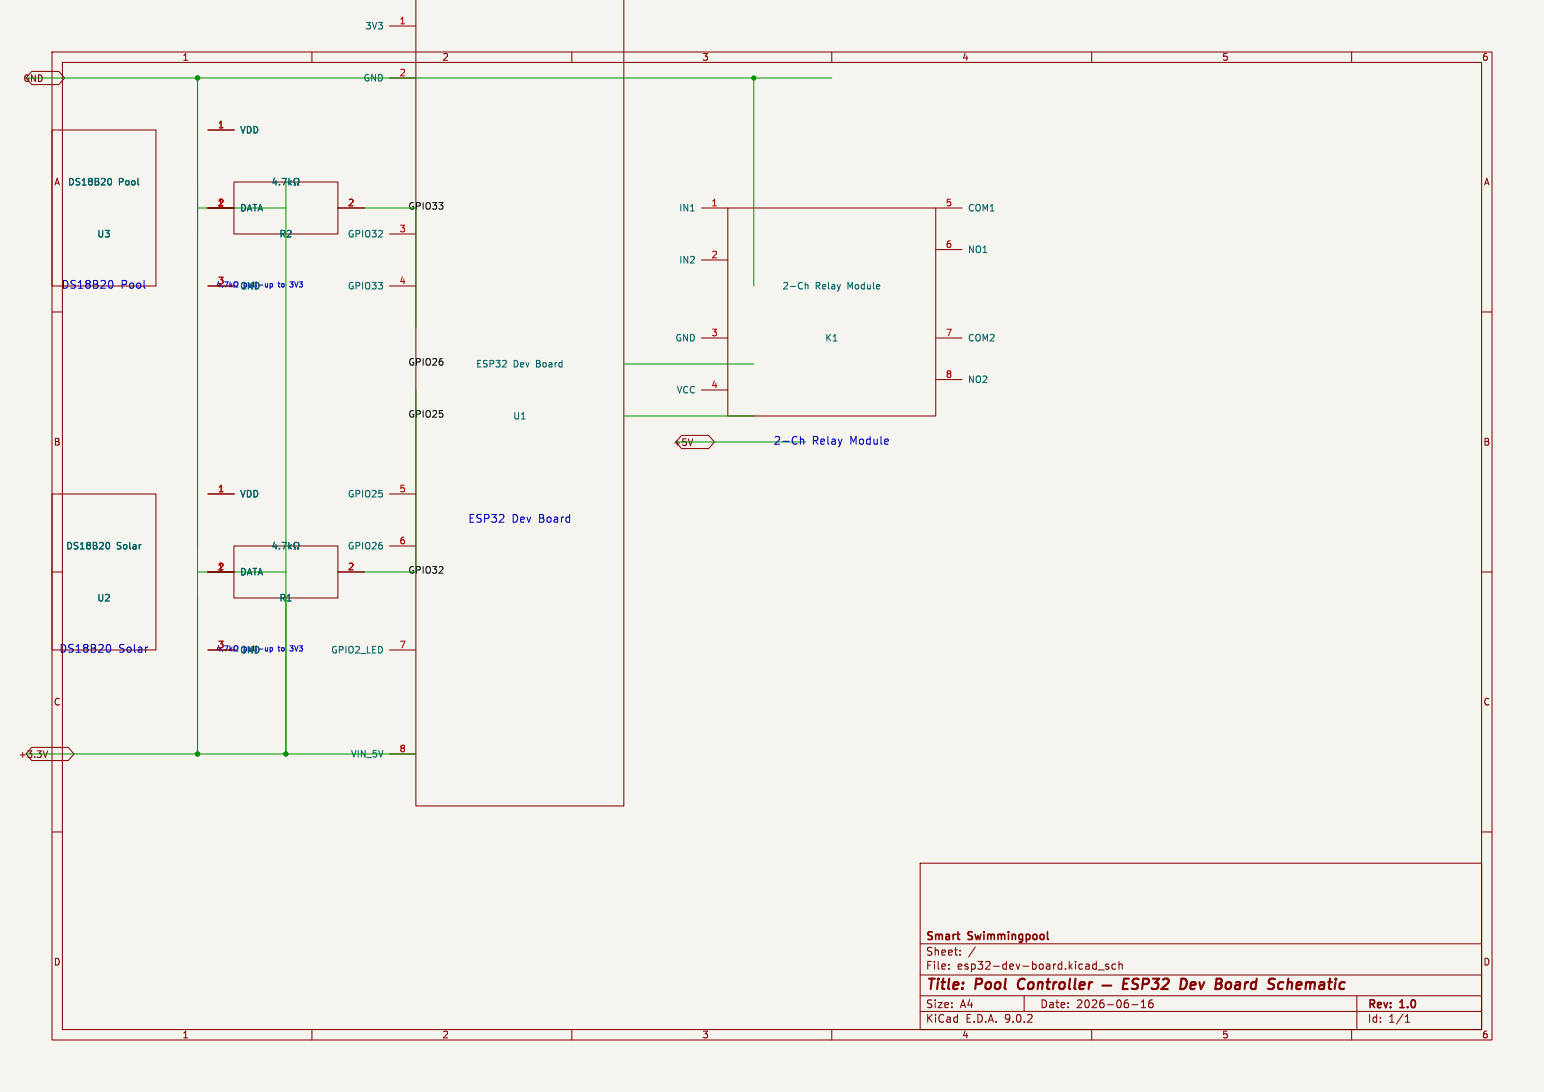
[picture p6: page 1]

File: esp32-dev-board.kicad_sch Sheet: / Smart Swimmingpool

Id: 1/1 Title: Pool Controller þÿ ESP32 Dev Board Schematic
