smart-swimmingpool/pool-controller/docs/kicad/norvi-ae01-r/norvi-ae01-r-schematic.pdf

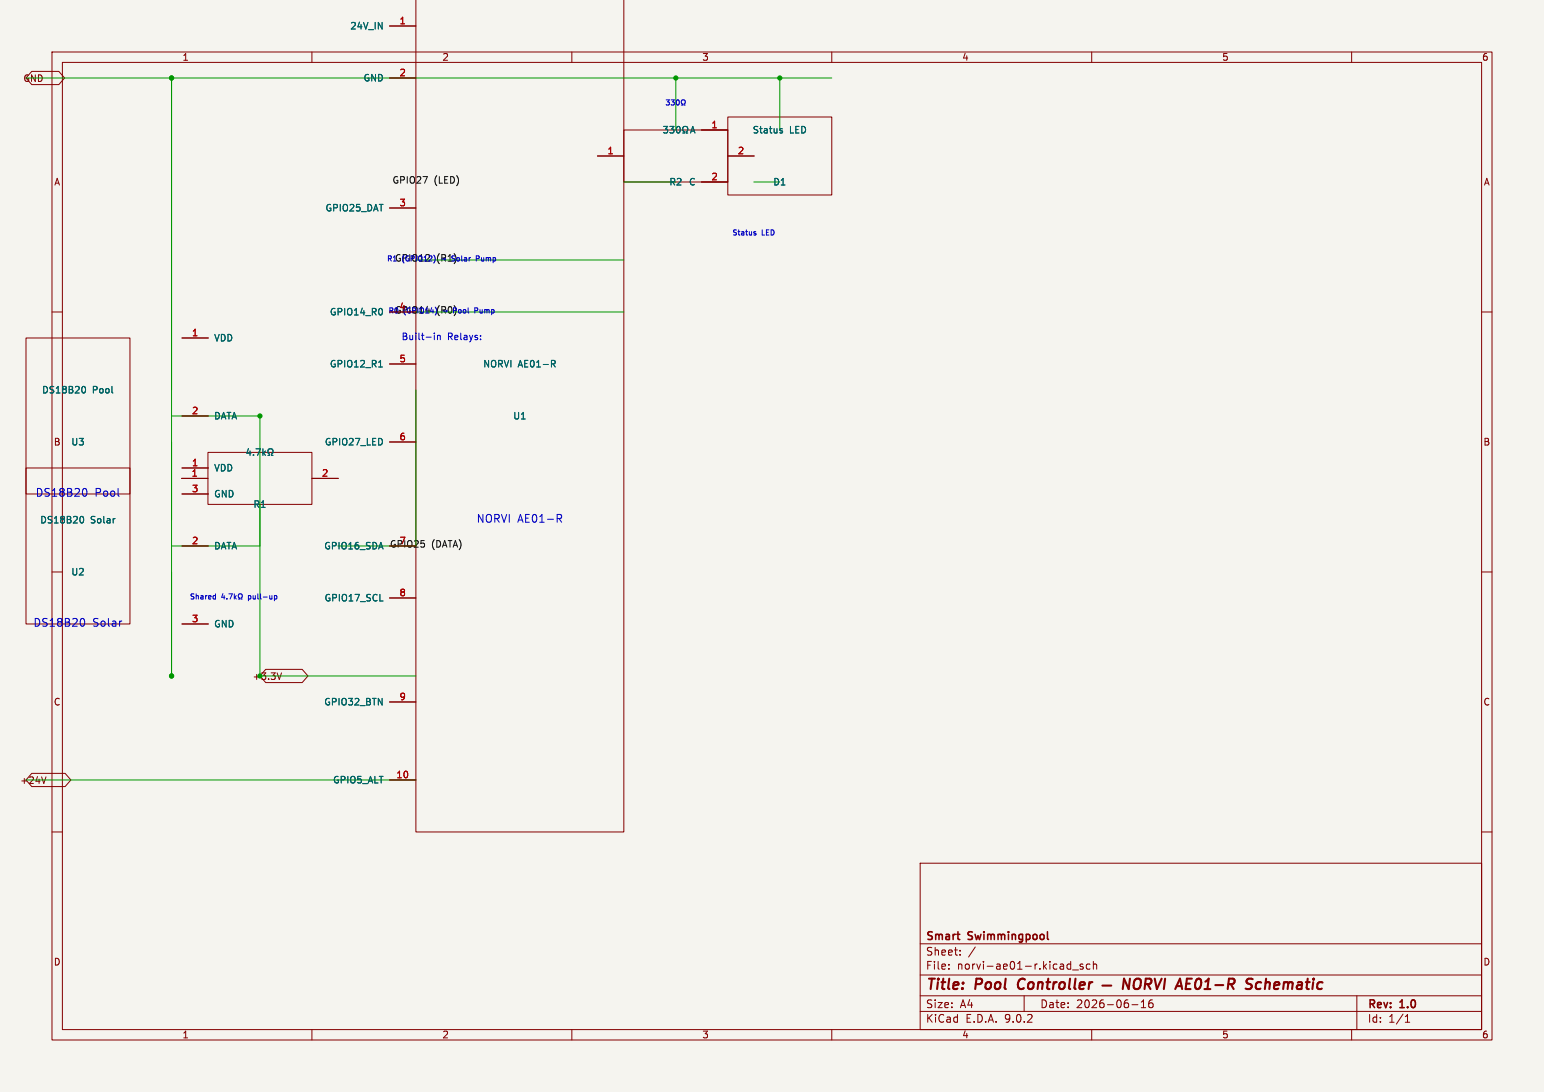
[picture p7: page 1]

File: norvi-ae01-r.kicad_sch Sheet: / Smart Swimmingpool
