smart-swimmingpool/pool-controller/(list of files, drawings)

Other design files:
docs/pool-controller.fzz
