smart-swimmingpool/pool-controller/docs/kicad/esp32-dev-board/esp32-dev-board.kicad_sch

## KiCad design docs/kicad/esp32-dev-board/esp32-dev-board.kicad_sch (2026-06-17)

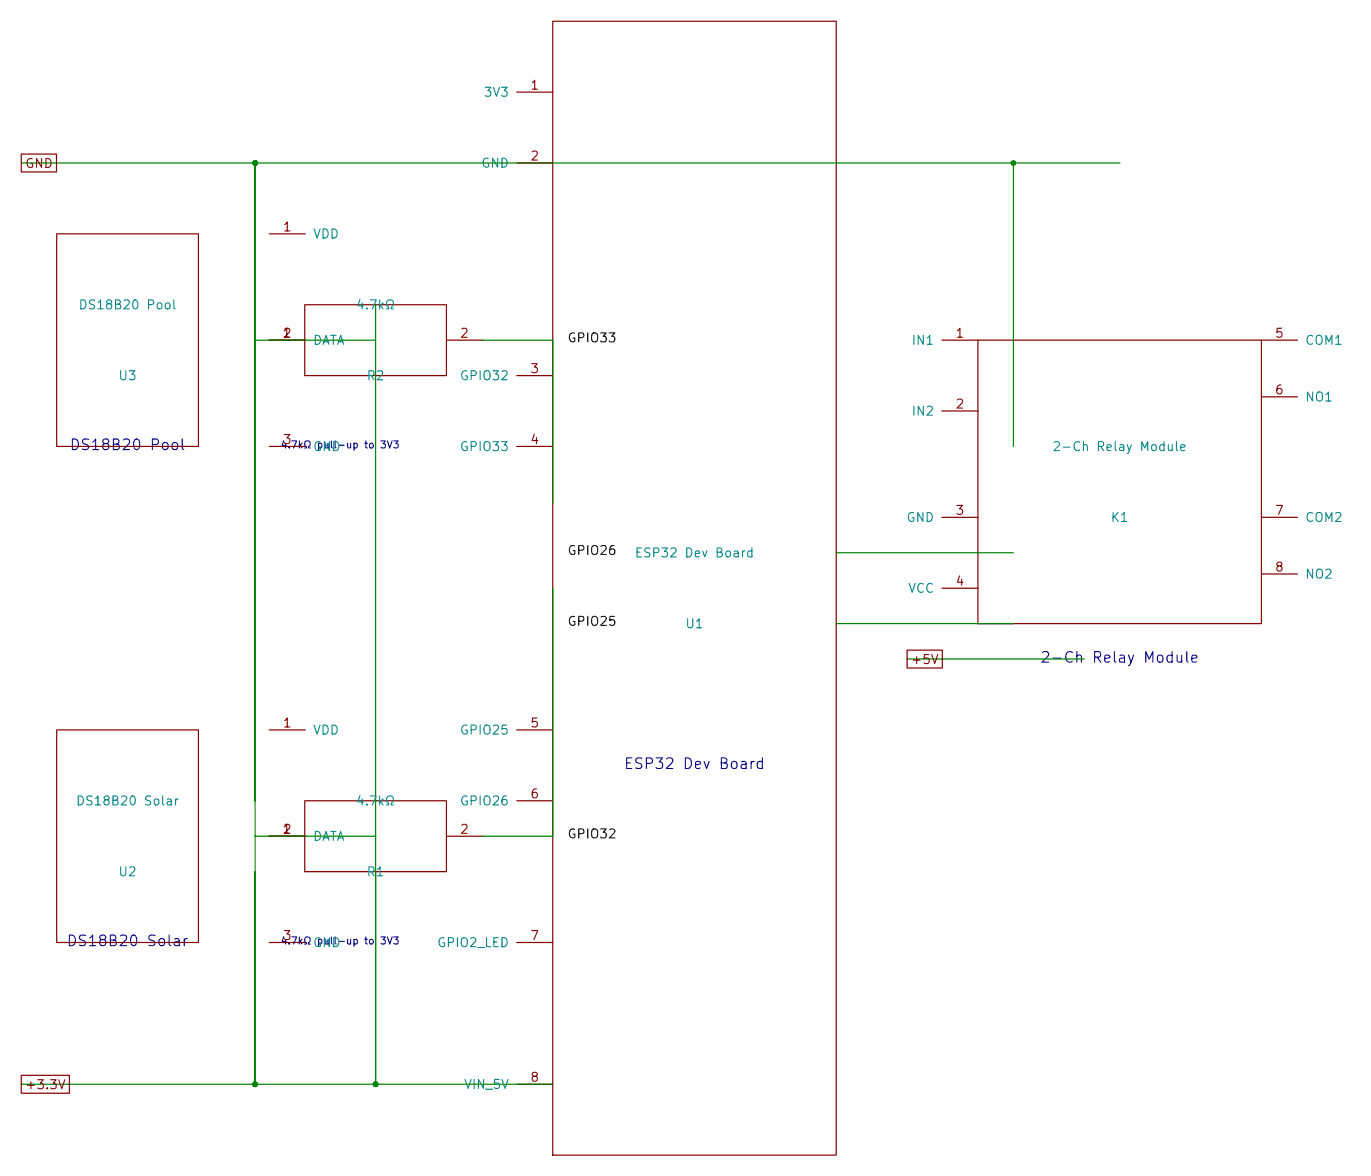
[picture p8: schematic esp32-dev-board.kicad_sch]

Parts:
K1: 2-Ch Relay Module
R1, R2: 4.7kΩ
U1: ESP32 Dev Board
U2: DS18B20 Solar
U3: DS18B20 Pool

Connections:
+3.3V: U1.8 (VIN_5V)

Notes on the sheet:
DS18B20 Solar
DS18B20 Pool
4.7kΩ pull-up to 3V3
ESP32 Dev Board
2-Ch Relay Module
