smart-swimmingpool/pool-controller/docs/kicad/norvi-ae01-r/norvi-ae01-r.kicad_sch

## KiCad design docs/kicad/norvi-ae01-r/norvi-ae01-r.kicad_sch (2026-06-17)

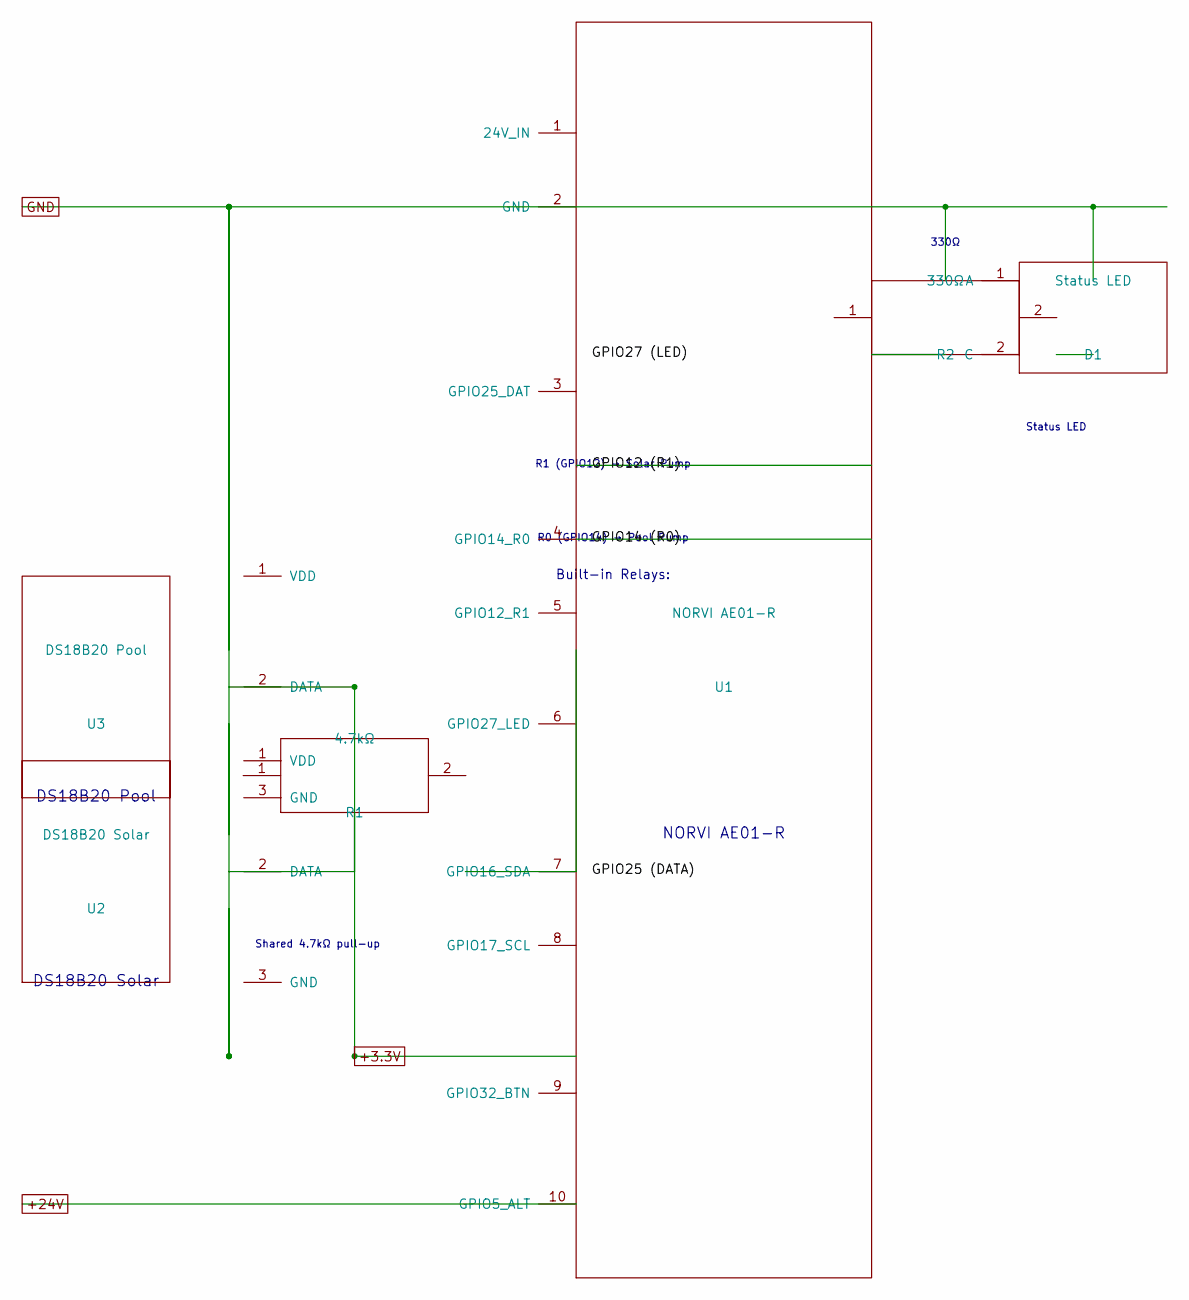
[picture p9: schematic norvi-ae01-r.kicad_sch]

Parts:
D1: Status LED
R1: 4.7kΩ
R2: 330Ω
U1: NORVI AE01-R
U2: DS18B20 Solar
U3: DS18B20 Pool

Connections:
+24V: U1.10 (GPIO5_ALT)
GPIO14 (R0): U1.4 (GPIO14_R0)

Notes on the sheet:
DS18B20 Solar
DS18B20 Pool
Shared 4.7kΩ pull-up
NORVI AE01-R
Status LED
330Ω
Built-in Relays:
R0 (GPIO14) → Pool Pump
R1 (GPIO12) → Solar Pump
