smart-swimmingpool/pool-controller/src/pool-control.hpp

#pragma once

#include <Homie.h>

#include <OneWire.h>
#include <DallasTemperature.h>
#include <RCSwitch.h>

#include "CurrentValue.hpp"


#define cHumidity "humidity"
#define cSwitch "switch"
#define cVoltage "voltage"

#define cDataTypFloat "float"
#define cDataTypBoolean "boolean"

#define cUnitTemperature "°C"
