smart-swimmingpool/pool-controller/src/WebPortal.cpp

// Copyright (c) 2018-2026 Smart Swimming Pool, Stephan Strittmatter
//
// SPDX-License-Identifier: MIT

/**
 * @file WebPortal.cpp
 * @brief Web server implementation — dashboard HTML, REST API handlers,
 *        static asset serving, session management, and OTA upload.
 */

#include "WebPortal.hpp"

#include <memory>

#include <ArduinoJson.h>
#include <LittleFS.h>
#include <Preferences.h>
#include <Update.h>

// ESP32 specific headers
#if defined(ESP32) || defined(ARDUINO_ARCH_ESP32)
#include <esp_random.h>
#else
#include <cstdlib>  // for random() in native tests
#include <ctime>    // for time() in native tests
#endif

#include "ConfigManager.hpp"
#include "DegradationManager.hpp"
#include "DallasTemperatureNode.hpp"
#include "ESP32TemperatureNode.hpp"
#include "NetworkManager.hpp"
#include "Nodes.hpp"
#include "OtaUpdater.hpp"
#include "OperationModeNode.hpp"
#include "PoolController.hpp"
#include "RelayModuleNode.hpp"
#include "SystemMonitor.hpp"
#include "TimeClientHelper.hpp"
#include "Version.h"
#include "LogCapture.hpp"

#ifdef NORVI_AE01_R
#include "NorviButtonHandler.hpp"
#include "CalibrationManager.hpp"
#endif

namespace PoolController {

// File-scoped state for streaming LittleFS upload (used by handleFsUploadStream)
static File fsUploadFile;

WebServer WebPortal::server_(80);
DNSServer WebPortal::dnsServer_;
bool WebPortal::dnsServerStarted_ = false;
String WebPortal::activeSessionToken_ = "";
String WebPortal::csrfToken_ = "";
uint32_t WebPortal::sessionStartTime_ = 0;
uint32_t WebPortal::lastLoginAttemptTime_ = 0;
uint8_t WebPortal::loginAttemptCount_ = 0;
constexpr uint32_t WebPortal::kSessionTimeoutMs;
constexpr uint16_t WebPortal::kDnsPort;

// PROGMEM fallbacks removed — web assets are served from LittleFS only.
// Run `pio run --target uploadfs` to deploy data/web/ to the device.

bool WebPortal::begin() {
  if (!LittleFS.begin(false)) {
    LOG_ERROR("✖ LittleFS mount failed — static web assets may be unavailable\n");
  }

  setupRoutes();

  // If AP mode, setup Captive DNS Server
  if (NetworkManager::isApMode()) {
    dnsServer_.setErrorReplyCode(DNSReplyCode::NoError);
    dnsServer_.start(kDnsPort, "*", WiFi.softAPIP());
    LOG_INFO("✓ Captive Portal DNS running.\n");
    dnsServerStarted_ = true;
  }

  server_.begin();
  LOG_INFO("✓ Web Server running on port 80.\n");

  // Initialize CSRF token
  generateCsrfToken();

  return true;
}

void WebPortal::loop() {
  if (NetworkManager::isApMode()) {
    if (!dnsServerStarted_) {
      dnsServer_.setErrorReplyCode(DNSReplyCode::NoError);
      dnsServer_.start(kDnsPort, "*", WiFi.softAPIP());
      LOG_INFO("✓ Captive Portal DNS running.\n");
      dnsServerStarted_ = true;
    }
    dnsServer_.processNextRequest();
  }
  server_.handleClient();

  // Session timeout checking
  if (activeSessionToken_.length() > 0 && (millis() - sessionStartTime_ > kSessionTimeoutMs)) {
    LOG_WARN("Session timed out.\n");
    activeSessionToken_ = "";
  }
}

// Generate secure random token - uses ESP32 hardware RNG when available
static String generateSecureToken(size_t length) {
  const char charset[] = "abcdefghijklmnopqrstuvwxyzABCDEFGHIJKLMNOPQRSTUVWXYZ0123456789";
  String token;

#if !defined(ESP32) && !defined(ARDUINO_ARCH_ESP32)
  // Seed random for native tests
  static bool seeded = false;
  if (!seeded) {
    srandom(time(nullptr));
    seeded = true;
  }
#endif

  for (size_t i = 0; i < length; i++) {
#if defined(ESP32) || defined(ARDUINO_ARCH_ESP32)
    // Use ESP32 hardware RNG for cryptographic security
    uint32_t randomValue = esp_random();
    token += charset[randomValue % (sizeof(charset) - 1)];
#else
    // Fallback for native tests - use standard random
    // Use String constructor with single char and then append
    char c = charset[random() % (sizeof(charset) - 1)];
    token = token + String(c);
#endif
  }

  return token;
}

void WebPortal::generateSessionToken() {
  // Generate cryptographically secure session token using ESP32 hardware RNG
  activeSessionToken_ = generateSecureToken(32);  // 32 characters = 192 bits of entropy
  csrfToken_ = generateSecureToken(32);           // Generate new CSRF token for the session
  sessionStartTime_ = millis();
  loginAttemptCount_ = 0;  // Reset login attempts on new session
}

void WebPortal::generateCsrfToken() {
  csrfToken_ = generateSecureToken(32);
}

String WebPortal::getCsrfToken() {
  return csrfToken_;
}

bool WebPortal::isClientAuthenticated() {
  if (NetworkManager::isApMode()) {
    // In AP fallback mode with saved credentials, require admin password.
    // Only allow unauthenticated AP access for truly unconfigured devices.
    if (!ConfigManager::isConfigured()) {
      return true;  // Initial setup — no password set yet
    }
    // Fall through to session-cookie check below
  }

  // Only check cookie if a session token was actually generated
  // (empty token would match 'session=' in any cookie)
  if (activeSessionToken_.length() > 0 && server_.hasHeader("Cookie")) {
    String cookie = server_.header("Cookie");
    if (cookie.indexOf("session=" + activeSessionToken_) != -1) {
      sessionStartTime_ = millis();  // Refresh timeout
      return true;
    }
  }
  return false;
}

bool WebPortal::handleAuthentication() {
  if (!isClientAuthenticated()) {
    handleLogin();
    return false;
  }
  return true;
}

void WebPortal::setupRoutes() {
  // HTML Handlers
  server_.on("/", handleRoot);
  server_.on("/login", handleLogin);

  // Static web assets (no authentication required)
  server_.on("/style.css", HTTP_GET, handleStyleCss);
  server_.on("/app.js", HTTP_GET, handleAppJs);
  server_.on("/manifest.json", HTTP_GET, handleManifestJson);
  server_.on("/sw.js", HTTP_GET, handleSwJs);
  server_.on("/icon.svg", HTTP_GET, handleIconSvg);

  // API Handlers (some password protected)
  server_.on("/api/status", HTTP_GET, apiGetStatus);
  server_.on("/api/scan", HTTP_GET, []() {
    if (!handleAuthentication())
      return;
    apiScanWiFi();
  });
  server_.on("/api/config", HTTP_GET, []() {
    if (!handleAuthentication())
      return;
    apiGetConfig();
  });
  server_.on("/api/config", HTTP_POST, []() {
    if (!handleAuthentication())
      return;
    apiSaveConfig();
  });

#ifdef NORVI_AE01_R
  // Button calibration wizard (NORVI)
  server_.on("/api/calibrate/start", HTTP_POST, []() {
    if (!handleAuthentication())
      return;
    apiCalibrateStart();
  });
  server_.on("/api/calibrate/status", HTTP_GET, []() {
    if (!handleAuthentication())
      return;
    apiCalibrateStatus();
  });
  server_.on("/api/calibrate/cancel", HTTP_POST, []() {
    if (!handleAuthentication())
      return;
    apiCalibrateCancel();
  });
#endif
  server_.on("/api/mode", HTTP_POST, []() {
    if (!handleAuthentication())
      return;
    apiSetMode();
  });
  server_.on("/api/pump", HTTP_POST, []() {
    if (!handleAuthentication())
      return;
    apiTogglePump();
  });

  server_.on("/api/login", HTTP_POST, apiLogin);
  server_.on("/api/logout", HTTP_GET, apiLogout);
  server_.on("/api/restart", HTTP_GET, []() {
    if (!handleAuthentication())
      return;
    apiRestart();
  });
  server_.on("/api/factory_reset", HTTP_GET, []() {
    if (!handleAuthentication())
      return;
    apiFactoryReset();
  });

  // OTA Update management
  server_.on("/api/update/check", HTTP_GET, []() {
    if (!handleAuthentication())
      return;
    apiUpdateCheck();
  });
  server_.on("/api/update/status", HTTP_GET, []() {
    if (!handleAuthentication())
      return;
    apiUpdateStatus();
  });
  server_.on("/api/update/install", HTTP_POST, []() {
    if (!handleAuthentication())
      return;
    apiUpdateInstall();
  });

  // Sensor mapping endpoints — GET is unauthenticated (read-only display),
  // POST (save) remains authenticated.
  server_.on("/api/sensors", HTTP_GET, apiGetSensors);
  server_.on("/api/sensors/map", HTTP_POST, []() {
    if (!handleAuthentication())
      return;
    apiSaveSensorMapping();
  });

  // Log view — GET is unauthenticated (read-only), clear remains authenticated.
  server_.on("/api/logs", HTTP_GET, apiGetLogs);
  server_.on("/api/logs/clear", HTTP_POST, []() {
    if (!handleAuthentication())
      return;
    apiClearLogs();
  });

  // LittleFS file upload (for OTA-safe web asset deployment)
  server_.on(
    "/api/fs/upload", HTTP_POST,
    []() {
      if (!handleAuthentication())
        return;
      apiFsUpload();
    },
    []() { handleFsUploadStream(); });

  // OTA Firmware handling (manual upload via web form)
  server_.on(
    "/api/update", HTTP_POST,
    []() {
      if (!handleAuthentication())
        return;
      server_.sendHeader("Connection", "close");
      server_.send(Update.hasError() ? 500 : 200, "text/plain", Update.hasError() ? "FAIL" : "OK");
      NetworkManager::restart();
    },
    []() {
      if (!isClientAuthenticated())
        return;
      HTTPUpload &upload = server_.upload();
      if (upload.status == UPLOAD_FILE_START) {
        LOG_INFO("Signed OTA Update Starting: %s\n", upload.filename.c_str());
        if (!Update.begin(UPDATE_SIZE_UNKNOWN)) {
          Update.printError(Serial);
        }
      } else if (upload.status == UPLOAD_FILE_WRITE) {
        if (Update.write(upload.buf, upload.currentSize) != upload.currentSize) {
          Update.printError(Serial);
        }
      } else if (upload.status == UPLOAD_FILE_END) {
        if (Update.end(true)) {
          LOG_INFO("Signed OTA Update Success: %u bytes\n", upload.totalSize);
        } else {
          Update.printError(Serial);
        }
      }
    });

  server_.onNotFound(handleNotFound);

  // Collect Cookie headers for authentication checking
  const char *headerkeys[] = {"Cookie"};
  server_.collectHeaders(headerkeys, 1);
}

// Serve a LittleFS web asset, preferring a pre-compressed .gz variant (created
// by scripts/gzip-web-assets.sh before upload). Falls back to the plain file
// when no .gz is present, so deployments without the script keep working.
bool WebPortal::serveWebFile(const char *path, const char *contentType, const char *cacheControl) {
  char gzPath[64];
  snprintf(gzPath, sizeof(gzPath), "%s.gz", path);

  File f = LittleFS.open(gzPath, "r");
  if (f) {
    // streamFile() sets Content-Encoding: gzip automatically for .gz files.
    server_.sendHeader("Cache-Control", cacheControl);
    server_.streamFile(f, contentType);
    f.close();
    return true;
  }

  f = LittleFS.open(path, "r");
  if (f) {
    server_.sendHeader("Cache-Control", cacheControl);
    server_.streamFile(f, contentType);
    f.close();
    return true;
  }
  return false;
}

void WebPortal::handleRoot() {
  // Dashboard is always served — interactive controls are gated by the frontend
  // based on the "authenticated" field from /api/status.
  // Entry point: always revalidate so freshly uploaded assets are picked up.
  // The service worker provides the instant-load cache for repeat visits.
  if (serveWebFile("/web/index.html", "text/html", "no-cache"))
    return;

  // No PROGMEM fallback — tell user to upload web assets
  String html = R"HTML(
<!DOCTYPE html><html><head>
<meta charset="utf-8"><meta name="viewport" content="width=device-width,initial-scale=1">
<title>Pool Controller</title>
<style>body{background:#06121e;color:#8aadc4;font-family:system-ui,sans-serif;display:flex;flex-direction:column;align-items:center;justify-content:center;min-height:100vh;padding:2rem;text-align:center;line-height:1.6}
h1{color:#00e5ff;margin-bottom:0.5rem}a{color:#48cae4}</style>
</head><body>
<h1>Pool Controller</h1>
<p>Firmware is running but web assets are not uploaded.</p>
<p style="font-size:0.875rem">Run <code style="background:rgba(255,255,255,0.08);padding:0.2rem 0.5rem;border-radius:4px">pio run --target uploadfs</code> to deploy <code>data/web/</code> to the device.</p>
<p style="margin-top:2rem;font-size:0.8rem">Or visit <a href="/update">/update</a> for OTA firmware update.</p>
</body></html>
)HTML";
  server_.send(200, "text/html", html);
}

void WebPortal::handleStyleCss() {
  if (serveWebFile("/web/style.css", "text/css", "public, max-age=3600"))
    return;
  server_.send(404, "text/plain", "Not Found");
}

void WebPortal::handleAppJs() {
  if (serveWebFile("/web/app.js", "application/javascript", "public, max-age=3600"))
    return;
  server_.send(404, "text/plain", "Not Found");
}

void WebPortal::handleManifestJson() {
  if (serveWebFile("/web/manifest.json", "application/manifest+json", "public, max-age=3600"))
    return;
  server_.send(404, "text/plain", "Not Found");
}

void WebPortal::handleSwJs() {
  // Never cache the service worker script — browsers must check for updates
  // on every navigation so new cache versions take effect promptly.
  if (serveWebFile("/web/sw.js", "application/javascript", "no-cache"))
    return;
  server_.send(404, "text/plain", "Not Found");
}

void WebPortal::handleIconSvg() {
  if (serveWebFile("/web/icon.svg", "image/svg+xml", "public, max-age=3600"))
    return;
  server_.send(404, "text/plain", "Not Found");
}

// Minimal inline login — no PROGMEM CSS framework, just a functional form
void WebPortal::handleLogin() {
  String html = R"HTML(
<!DOCTYPE html><html><head>
<meta charset="utf-8"><meta name="viewport" content="width=device-width,initial-scale=1">
<title>Pool Controller — Login</title>
<style>body{background:#06121e;color:#e2f0f7;font-family:system-ui,sans-serif;display:flex;flex-direction:column;align-items:center;justify-content:center;min-height:100vh;padding:2rem}
.card{background:rgba(8,28,48,0.75);backdrop-filter:blur(16px);border:1px solid rgba(0,200,220,0.12);border-radius:16px;padding:2rem;max-width:400px;width:100%}
h1{color:#00e5ff;text-align:center;margin-bottom:0.25rem;font-size:1.5rem}
p{color:#8aadc4;text-align:center;margin-bottom:2rem;font-size:0.9rem}
input{width:100%;padding:0.75rem 1rem;background:rgba(0,0,0,0.3);border:1px solid rgba(0,200,220,0.1);border-radius:8px;color:#e2f0f7;font-size:1rem}
input:focus{outline:none;border-color:#00e5ff;box-shadow:0 0 0 3px rgba(0,229,255,0.2)}
button{width:100%;padding:0.75rem;margin-top:1rem;background:linear-gradient(135deg,#00b4d8,#00e5ff);border:none;border-radius:8px;color:#000;font-weight:600;font-size:1rem;cursor:pointer}
.error{color:#ef4444;margin-top:0.5rem;display:none;font-size:0.875rem}
</style></head><body>
<div class="card">
<h1>Pool Controller</h1>
<p>Web Administration Sign In</p>
<form id="loginForm">
<input type="password" id="password" required placeholder="Administrator Password">
<div class="error" id="error">Invalid Password!</div>
<button type="submit">Unlock Console</button>
</form></div>
<script>
document.getElementById('loginForm').addEventListener('submit', async (e) => {
  e.preventDefault();
  const pwd = document.getElementById('password').value;
  const err = document.getElementById('error');
  const res = await fetch('/api/login', {
    method: 'POST',
    headers: { 'Content-Type': 'application/x-www-form-urlencoded' },
    body: 'password=' + encodeURIComponent(pwd)
  });
  if (res.status === 200) { window.location.reload(); }
  else { err.style.display = 'block'; }
});
</script></body></html>
)HTML";
  server_.send(200, "text/html", html);
}
void WebPortal::handleNotFound() {
  // Captive Portal DNS redirection
  if (NetworkManager::isApMode()) {
    server_.sendHeader("Location", "http://192.168.4.1/", true);
    server_.send(302, "text/plain", "");
    return;
  }

  server_.send(404, "text/plain", "Page Not Found");
}

void WebPortal::apiGetStatus() {
  JsonDocument doc;

  doc["pool_temp"] = poolTemperatureNode.getTemperature();
  doc["solar_temp"] = solarTemperatureNode.getTemperature();
  doc["ctrl_temp"] = ctrlTemperatureNode.getTemperature();
  doc["pool_pump"] = poolPumpNode.getSwitch();
  doc["solar_pump"] = solarPumpNode.getSwitch();
  doc["op_mode"] = operationModeNode.getMode();
  doc["uptime"] = millis() / 1000;
  doc["free_heap"] = ESP.getFreeHeap();
  doc["max_alloc"] = ESP.getMaxAllocHeap();
  doc["ap_mode"] = NetworkManager::isApMode();
  doc["rssi"] = NetworkManager::getWiFiRSSI();
  doc["wifi_connected"] = NetworkManager::isWiFiConnected();
  doc["mqtt_connected"] = NetworkManager::isMqttConnected();
  doc["local_ip"] = NetworkManager::getLocalIP();
  doc["fw_version"] = FW_VERSION;
  doc["authenticated"] = isClientAuthenticated();
#ifdef NORVI_AE01_R
  doc["norvi"] = true;
#else
  doc["norvi"] = false;
#endif

  // Current date/time in configured timezone
  TimeChangeRule *tcr;
  time_t localTime = getTimeFor(ConfigManager::getSettings().timezoneIndex, &tcr);
  char timeBuf[64];
  snprintf(timeBuf, sizeof(timeBuf), "%04d-%02d-%02d %02d:%02d:%02d", year(localTime), month(localTime), day(localTime),
    hour(localTime), minute(localTime), second(localTime));
  doc["local_time"] = timeBuf;
  doc["local_time_epoch"] = static_cast<long>(localTime);
  doc["timezone_name"] = getTimeInfoFor(ConfigManager::getSettings().timezoneIndex);
  doc["time_degradation"] = static_cast<int>(getTimeDegradation());

  // Thresholds — also in apiGetConfig, but duplicated here so the dashboard
  // can show them without authentication (apiGetStatus is unauthenticated).
  doc["temp_max_pool"] = ConfigManager::getSettings().tempMaxPool;
  doc["temp_min_solar"] = ConfigManager::getSettings().tempMinSolar;
  doc["temp_hysteresis"] = ConfigManager::getSettings().tempHysteresis;
  doc["temp_circ_threshold"] = ConfigManager::getSettings().tempCircThreshold;
  doc["temp_circ_factor"] = ConfigManager::getSettings().tempCircFactor;
  doc["temp_circ_max_runtime"] = ConfigManager::getSettings().tempCircMaxRuntime;
  doc["loop_interval"] = ConfigManager::getSettings().loopInterval;
  doc["timezone"] = ConfigManager::getSettings().timezoneIndex;
  doc["time_loss_green_hours"] = ConfigManager::getSettings().timeLossGreenHours;
  doc["time_loss_red_hours"] = ConfigManager::getSettings().timeLossRedHours;
  doc["ntp_server"] = ConfigManager::getNtp().server;

  // Effective runtime (temperature-based circulation) — actual minutes, not end-of-day
  {
    Rule *active = operationModeNode.getRule();
    doc["effective_runtime"] = (active != nullptr) ? active->getEffectiveRuntimeMinutes() : 0;
    doc["circulation_extension"] = (active != nullptr) ? active->getCirculationExtensionMinutes() : 0;
  }

  // Timer settings for dashboard display
  {
    TimerSetting ts = operationModeNode.getTimerSetting();
    doc["timer_start_h"] = ts.timerStartHour;
    doc["timer_start_m"] = ts.timerStartMinutes;
    doc["timer_end_h"] = ts.timerEndHour;
    doc["timer_end_m"] = ts.timerEndMinutes;

    // Extended end time in minutes since midnight (0 when no extension active)
    Rule *active = operationModeNode.getRule();
    doc["timer_extended_end"] = (active != nullptr) ? active->getActiveEndMinutes() : 0;
  }

  // Serialize directly to a pre-allocated buffer to minimize String usage
  // Use a static buffer to avoid heap fragmentation
  static char jsonBuffer[1536];
  size_t jsonLength = serializeJson(doc, jsonBuffer, sizeof(jsonBuffer));
  if (jsonLength > 0) {
    server_.send(200, "application/json", jsonBuffer);
  } else {
    server_.send(500, "text/plain", "JSON serialization error");
  }
}

// ── Log view (REST /api/logs) ──────────────────────────────────────────────

size_t WebPortal::buildLogsJson(uint32_t since, uint32_t epoch, size_t count, LogLevel minLevel, char *buf, size_t bufSize) {
  if (buf == nullptr || bufSize == 0) {
    return 0;
  }

  // Copy entries out of the ring into a fixed array (snapshot consistency —
  // getEntries reads under the log mutex). Static: no stack pressure.
  static LogEntry entries[LogCapture::LOG_BUFFER_ENTRIES];
  size_t n = LogCapture::getEntries(since, epoch, count, minLevel, entries, LogCapture::LOG_BUFFER_ENTRIES);

  JsonDocument doc;
  doc["ok"] = true;
  // The client echoes the boot epoch it last saw; a mismatch with the current
  // boot tells it to discard its cursor even when the new sequence has already
  // grown past it. Always report the CURRENT epoch, not the requested one.
  doc["boot"] = LogCapture::epoch();
  // getEntries() treats `since` as an exclusive cursor (skips entry.seq <= since),
  // so next must be the highest sequence actually consumed, not lastSeq()+1:
  // a cursor of lastSeq()+1 would skip the entry whose seq equals that value on
  // the next poll, and truncated responses would jump past unreturned entries.
  // With no entries, keep the previous cursor (no progress, nothing skipped).
  doc["next"] = (n > 0) ? entries[n - 1].seq : since;

  JsonArray arr = doc["entries"].to<JsonArray>();
  for (size_t i = 0; i < n; ++i) {
    JsonObject obj = arr.add<JsonObject>();
    obj["seq"] = entries[i].seq;
    obj["t"] = entries[i].uptimeMs;
    obj["level"] = LogCapture::levelName(entries[i].level);
    obj["msg"] = entries[i].message;
  }

  size_t jsonLength = serializeJson(doc, buf, bufSize);
  // Signal truncation (buffer too small) instead of returning broken JSON
  if (jsonLength >= bufSize) {
    return 0;
  }
  return jsonLength;
}

void WebPortal::apiGetLogs() {
  uint32_t since = 0;
  // Omitted boot parameter = current boot: the documented since-polling flow
  // keeps working incrementally. Only clients that explicitly send a boot epoch
  // get reboot detection (a stale epoch forces a full dump).
  uint32_t epoch = LogCapture::epoch();
  size_t count = 200;
  LogLevel minLevel = LogLevel::Info;

  if (server_.hasArg("since")) {
    since = static_cast<uint32_t>(atol(server_.arg("since").c_str()));
  }
  if (server_.hasArg("boot")) {
    // Parse as unsigned 32-bit: esp_random() produces values above LONG_MAX
    // on roughly half of boots, which atol() would overflow (→ stale epoch →
    // full ring + duplicate entries on every poll). strtoul reconstructs the
    // full uint32 range; on invalid input we keep the current boot (safe
    // fallback that preserves incremental since-polling).
    char *end = nullptr;
    const unsigned long v = strtoul(server_.arg("boot").c_str(), &end, 10);
    if (end != server_.arg("boot").c_str() && v <= UINT32_MAX) {
      epoch = static_cast<uint32_t>(v);
    }
  }
  if (server_.hasArg("count")) {
    long c = atol(server_.arg("count").c_str());
    if (c > 0 && c <= 500) {
      count = static_cast<size_t>(c);
    }
  }
  if (server_.hasArg("level")) {
    minLevel = LogCapture::parseLevel(server_.arg("level").c_str());
  }

  // Serialize directly to a pre-allocated buffer to minimize String usage.
  // Worst case: LOG_BUFFER_ENTRIES entries x ~140 bytes each + envelope.
  // Use a static buffer to avoid heap fragmentation.
  static char jsonBuffer[16384];
  size_t jsonLength = buildLogsJson(since, epoch, count, minLevel, jsonBuffer, sizeof(jsonBuffer));
  if (jsonLength > 0) {
    server_.send(200, "application/json", jsonBuffer);
  } else {
    server_.send(500, "text/plain", "JSON serialization error");
  }
}

void WebPortal::apiClearLogs() {
  LogCapture::clear();
  server_.send(200, "application/json", "{\"ok\":true}");
}

void WebPortal::apiScanWiFi() {
  int n = WiFi.scanNetworks();
  JsonDocument doc;
  JsonArray arr = doc.to<JsonArray>();

  for (int i = 0; i < n; ++i) {
    JsonObject obj = arr.add<JsonObject>();
    obj["ssid"] = WiFi.SSID(i);
    obj["rssi"] = WiFi.RSSI(i);
    obj["secure"] = WiFi.encryptionType(i) != WIFI_AUTH_OPEN;
  }

  // Serialize directly to buffer to minimize String usage
  // Increased buffer size to handle environments with many visible APs or long SSIDs
  // Per P2 review: avoid truncating WiFi scan JSON responses
  static char jsonBuffer[4096];
  size_t jsonLength = serializeJson(doc, jsonBuffer, sizeof(jsonBuffer));
  if (jsonLength > 0) {
    // Check if serialization was truncated
    if (jsonLength >= sizeof(jsonBuffer) - 1) {
      server_.send(500, "text/plain", "JSON buffer overflow");
      return;
    }
    server_.send(200, "application/json", jsonBuffer);
  } else {
    server_.send(500, "text/plain", "JSON serialization error");
  }
}

void WebPortal::apiGetConfig() {
  JsonDocument doc;

  JsonObject wifiObj = doc["wifi"].to<JsonObject>();
  wifiObj["ssid"] = ConfigManager::getWiFi().ssid;

  JsonObject mqttObj = doc["mqtt"].to<JsonObject>();
  mqttObj["host"] = ConfigManager::getMqtt().host;
  mqttObj["port"] = ConfigManager::getMqtt().port;
  mqttObj["username"] = ConfigManager::getMqtt().username;

  JsonObject ntpObj = doc["ntp"].to<JsonObject>();
  ntpObj["server"] = ConfigManager::getNtp().server;

  JsonObject settingsObj = doc["settings"].to<JsonObject>();
  settingsObj["op_mode"] = ConfigManager::getSettings().opMode;
  settingsObj["loop_interval"] = ConfigManager::getSettings().loopInterval;
  settingsObj["temp_max_pool"] = ConfigManager::getSettings().tempMaxPool;
  settingsObj["temp_min_solar"] = ConfigManager::getSettings().tempMinSolar;
  settingsObj["temp_hysteresis"] = ConfigManager::getSettings().tempHysteresis;
  settingsObj["temp_circ_threshold"] = ConfigManager::getSettings().tempCircThreshold;
  settingsObj["temp_circ_factor"] = ConfigManager::getSettings().tempCircFactor;
  settingsObj["temp_circ_max_runtime"] = ConfigManager::getSettings().tempCircMaxRuntime;
  settingsObj["timezone"] = ConfigManager::getSettings().timezoneIndex;
  settingsObj["time_loss_green_hours"] = ConfigManager::getSettings().timeLossGreenHours;
  settingsObj["time_loss_red_hours"] = ConfigManager::getSettings().timeLossRedHours;
  settingsObj["btn1_min"] = ConfigManager::getSettings().btn1Min;
  settingsObj["btn1_max"] = ConfigManager::getSettings().btn1Max;
  settingsObj["btn2_min"] = ConfigManager::getSettings().btn2Min;
  settingsObj["btn2_max"] = ConfigManager::getSettings().btn2Max;
  settingsObj["btn3_min"] = ConfigManager::getSettings().btn3Min;
  settingsObj["btn3_max"] = ConfigManager::getSettings().btn3Max;
  settingsObj["btn_no_press"] = ConfigManager::getSettings().btnNoPress;
  settingsObj["timer_start_hour"] = operationModeNode.getTimerSetting().timerStartHour;
  settingsObj["timer_start_min"] = operationModeNode.getTimerSetting().timerStartMinutes;
  settingsObj["timer_end_hour"] = operationModeNode.getTimerSetting().timerEndHour;
  settingsObj["timer_end_min"] = operationModeNode.getTimerSetting().timerEndMinutes;

  // Serialize directly to buffer to minimize String usage
  // Increased buffer size to handle long MQTT host/user and NTP server values
  // Per P2 review: check config JSON serialization for truncation
  static char jsonBuffer[2048];
  size_t jsonLength = serializeJson(doc, jsonBuffer, sizeof(jsonBuffer));
  if (jsonLength > 0) {
    // Check if serialization was truncated
    if (jsonLength >= sizeof(jsonBuffer) - 1) {
      server_.send(500, "text/plain", "JSON buffer overflow");
      return;
    }
    server_.send(200, "application/json", jsonBuffer);
  } else {
    server_.send(500, "text/plain", "JSON serialization error");
  }
}

void WebPortal::apiSaveConfig() {
  if (!server_.hasArg("type")) {
    server_.send(400, "text/plain", "Missing Configuration Type");
    return;
  }

  String type = server_.arg("type");

  if (type == "wifi") {
    String ssid = server_.arg("ssid");
    String password = server_.arg("password");

    // Input validation for SSID
    if (ssid.length() == 0 || ssid.length() > 32) {
      server_.send(400, "text/plain", "Invalid SSID length (1-32 characters)");
      return;
    }

    // Input validation for password
    if (password.length() > 64) {
      server_.send(400, "text/plain", "Password too long (max 64 characters)");
      return;
    }

    // SSIDs are limited by byte length (32 bytes), not by character set
    // Allow any byte values including UTF-8/non-ASCII characters
    // The ESP32 WiFi stack handles the actual validation

    ConfigManager::getWiFi().ssid = ssid;
    ConfigManager::getWiFi().password = password;
    ConfigManager::setConfigured(true);  // P1: Mark device as configured
    ConfigManager::save();
    server_.send(200, "text/plain", "OK");

    // Restart to apply new WiFi connection setup
    NetworkManager::restart();
    return;
  } else if (type == "mqtt") {
    ConfigManager::getMqtt().host = server_.arg("host");
    ConfigManager::getMqtt().port = server_.arg("port").toInt();
    ConfigManager::getMqtt().username = server_.arg("username");
    // Always update password (even blank) to allow clearing stale passwords
    // This allows switching to a username-only/no-password broker
    ConfigManager::getMqtt().password = server_.arg("password");
    ConfigManager::save();

    // Disconnect MQTT to reconnect immediately with new config
    NetworkManager::disconnectMqtt();
    server_.send(200, "text/plain", "OK");
    return;
  } else if (type == "settings") {
    ConfigManager::getSettings().opMode = server_.arg("mode");
    ConfigManager::getSettings().loopInterval = server_.arg("interval").toInt();
    ConfigManager::getSettings().tempMaxPool = server_.arg("max_pool").toFloat();
    ConfigManager::getSettings().tempMinSolar = server_.arg("min_solar").toFloat();
    ConfigManager::getSettings().tempHysteresis = server_.arg("hysteresis").toFloat();
    if (server_.hasArg("circ_threshold"))
      ConfigManager::getSettings().tempCircThreshold = server_.arg("circ_threshold").toFloat();
    if (server_.hasArg("circ_factor"))
      ConfigManager::getSettings().tempCircFactor = server_.arg("circ_factor").toInt();
    if (server_.hasArg("circ_max_runtime"))
      ConfigManager::getSettings().tempCircMaxRuntime = server_.arg("circ_max_runtime").toInt();
    if (server_.hasArg("btn1_min"))
      ConfigManager::getSettings().btn1Min = server_.arg("btn1_min").toInt();
    if (server_.hasArg("btn1_max"))
      ConfigManager::getSettings().btn1Max = server_.arg("btn1_max").toInt();
    if (server_.hasArg("btn2_min"))
      ConfigManager::getSettings().btn2Min = server_.arg("btn2_min").toInt();
    if (server_.hasArg("btn2_max"))
      ConfigManager::getSettings().btn2Max = server_.arg("btn2_max").toInt();
    if (server_.hasArg("btn3_min"))
      ConfigManager::getSettings().btn3Min = server_.arg("btn3_min").toInt();
    if (server_.hasArg("btn3_max"))
      ConfigManager::getSettings().btn3Max = server_.arg("btn3_max").toInt();
    if (server_.hasArg("btn_no_press"))
      ConfigManager::getSettings().btnNoPress = server_.arg("btn_no_press").toInt();
    ConfigManager::getSettings().timezoneIndex = server_.arg("timezone").toInt();
    ConfigManager::getSettings().timeLossGreenHours = server_.arg("green").toInt();
    ConfigManager::getSettings().timeLossRedHours = server_.arg("red").toInt();

    ConfigManager::save();

#ifdef NORVI_AE01_R
    // Apply button thresholds to the running handler immediately so the
    // new values take effect without a reboot (P2 review fix).
    NorviButtonHandler::applySettings();
#endif

    // Apply timezone change to running clock immediately (P2)
    setTimezoneIndex(ConfigManager::getSettings().timezoneIndex);

    // Apply time-loss degradation thresholds immediately (P2 review fix)
    setTimeDegradationGreenHours(static_cast<uint8_t>(ConfigManager::getSettings().timeLossGreenHours));
    setTimeDegradationRedHours(static_cast<uint8_t>(ConfigManager::getSettings().timeLossRedHours));

    // Propagate loop interval to all running nodes (P2 review fix)
    solarTemperatureNode.setMeasurementInterval(ConfigManager::getSettings().loopInterval);
    poolTemperatureNode.setMeasurementInterval(ConfigManager::getSettings().loopInterval);
    ctrlTemperatureNode.setMeasurementInterval(ConfigManager::getSettings().loopInterval);
    poolPumpNode.setMeasurementInterval(ConfigManager::getSettings().loopInterval);
    solarPumpNode.setMeasurementInterval(ConfigManager::getSettings().loopInterval);
    operationModeNode.setMeasurementInterval(ConfigManager::getSettings().loopInterval);

    // Propagate changes directly into runtime parameters
    operationModeNode.setMode(ConfigManager::getSettings().opMode.c_str(), "web:settings");
    operationModeNode.setPoolMaxTemperature(ConfigManager::getSettings().tempMaxPool);
    operationModeNode.setSolarMinTemperature(ConfigManager::getSettings().tempMinSolar);
    operationModeNode.setTemperatureHysteresis(ConfigManager::getSettings().tempHysteresis);

    // NTP server live update
    if (server_.hasArg("ntp_server")) {
      ConfigManager::getNtp().server = server_.arg("ntp_server");
      ConfigManager::save();
      timeClientSetup(ConfigManager::getNtp().server.c_str());
    }

    // Apply timer settings
    {
      TimerSetting ts = operationModeNode.getTimerSetting();
      if (server_.hasArg("timer_start_h"))
        ts.timerStartHour = server_.arg("timer_start_h").toInt();
      if (server_.hasArg("timer_start_m"))
        ts.timerStartMinutes = server_.arg("timer_start_m").toInt();
      if (server_.hasArg("timer_end_h"))
        ts.timerEndHour = server_.arg("timer_end_h").toInt();
      if (server_.hasArg("timer_end_m"))
        ts.timerEndMinutes = server_.arg("timer_end_m").toInt();
      operationModeNode.setTimerSetting(ts);
    }

    server_.send(200, "text/plain", "OK");
    return;
  } else if (type == "password") {
    String currentPassword = server_.arg("current_password");
    String newPassword = server_.arg("password");
    String confirmPassword = server_.arg("password_confirm");

    // Verify current password
    if (!ConfigManager::verifyAdminPassword(currentPassword)) {
      server_.send(403, "text/plain", "Current password is incorrect");
      return;
    }

    // Input validation for new password - align with UI (min 4 chars)
    if (newPassword.length() < 4) {
      server_.send(400, "text/plain", "New password must be at least 4 characters");
      return;
    }

    if (newPassword.length() > 64) {
      server_.send(400, "text/plain", "New password too long (max 64 characters)");
      return;
    }

    // Verify confirmation matches
    if (newPassword != confirmPassword) {
      server_.send(400, "text/plain", "New password and confirmation do not match");
      return;
    }

    ConfigManager::setAdminPassword(newPassword);
    ConfigManager::save();
    server_.send(200, "text/plain", "OK");
    return;
  }

  server_.send(400, "text/plain", "Invalid Config Request");
}

#ifdef NORVI_AE01_R
// ── Button calibration (NORVI) ────────────────────────────────────────────

void WebPortal::apiCalibrateStart() {
  if (!CalibrationManager::start()) {
    server_.send(409, "text/plain", "Calibration already running");
    return;
  }
  server_.send(200, "text/plain", "OK");
}

void WebPortal::apiCalibrateStatus() {
  const auto st = CalibrationManager::getStatus();
  JsonDocument doc;
  doc["step"] = static_cast<int>(st.step);
  doc["live_adc"] = st.liveAdc;
  doc["resting"] = st.restingLevel;
  doc["s1"] = st.s1;
  doc["s2"] = st.s2;
  doc["s3"] = st.s3;
  doc["message"] = st.message;
  String json;
  serializeJson(doc, json);
  server_.send(200, "application/json", json);
}

void WebPortal::apiCalibrateCancel() {
  CalibrationManager::cancel();
  server_.send(200, "text/plain", "OK");
}
#endif  // NORVI_AE01_R

void WebPortal::apiSetMode() {
  if (!server_.hasArg("mode")) {
    server_.send(400, "application/json", "{\"status\":\"error\",\"message\":\"Missing mode\"}");
    return;
  }

  String mode = server_.arg("mode");
  if (operationModeNode.setMode(mode, "web:apiSetMode")) {
    ConfigManager::getSettings().opMode = mode;
    ConfigManager::save();
    server_.send(200, "application/json", "{\"status\":\"ok\",\"mode\":\"" + mode + "\"}");
  } else {
    server_.send(400, "application/json", "{\"status\":\"error\",\"message\":\"Invalid mode\"}");
  }
}

void WebPortal::apiTogglePump() {
  if (!server_.hasArg("pump")) {
    server_.send(400, "application/json", "{\"status\":\"error\",\"message\":\"Missing pump parameter\"}");
    return;
  }

  // Only allow pump toggling in manual mode
  if (operationModeNode.getMode() != "manu") {
    server_.send(400, "application/json", "{\"status\":\"error\",\"message\":\"Pump control only available in manual mode\"}");
    return;
  }

  String pump = server_.arg("pump");
  bool newState;

  if (pump == "pool") {
    newState = !poolPumpNode.getSwitch();
    poolPumpNode.setSwitch(newState);
  } else if (pump == "solar") {
    newState = !solarPumpNode.getSwitch();
    solarPumpNode.setSwitch(newState);
  } else {
    server_.send(400, "application/json", "{\"status\":\"error\",\"message\":\"Invalid pump. Use 'pool' or 'solar'\"}");
    return;
  }

  String json = "{\"status\":\"ok\",\"state\":" + String(newState ? "true" : "false") + "}";
  server_.send(200, "application/json", json);
}

bool WebPortal::isLoginLockedOut() {
  if (loginAttemptCount_ >= kMaxLoginAttempts) {
    uint32_t now = millis();
    // Check if lockout period has passed (handle unsigned wrap-around)
    if (now - lastLoginAttemptTime_ < kLoginLockoutMs && now >= lastLoginAttemptTime_) {
      return true;  // Still locked out
    }
    // Lockout period has passed, reset counter
    loginAttemptCount_ = 0;
  }
  return false;
}

void WebPortal::apiLogin() {
  // Rate limiting check
  if (isLoginLockedOut()) {
    uint32_t remaining = kLoginLockoutMs - (millis() - lastLoginAttemptTime_);
    server_.sendHeader("Retry-After", String(remaining / 1000));
    server_.send(429, "text/plain", "Too many attempts. Try again later.");
    return;
  }

  if (!server_.hasArg("password")) {
    server_.send(400, "text/plain", "Password Required");
    return;
  }

  String pass = server_.arg("password");

  // Input validation - limit password length for NEW passwords only
  // Existing passwords (stored as SHA-256 hash) may be longer than 64 chars
  // and should still be allowed to authenticate (P2 review fix)
  // Only enforce max length when setting new passwords via apiSaveConfig

  if (ConfigManager::verifyAdminPassword(pass)) {
    generateSessionToken();
    // Cookie with HttpOnly, SameSite, and shorter expiry
    // Note: Secure attribute removed because device serves UI on HTTP (port 80)
    // Adding Secure would prevent browsers from sending cookie back over http://
    String cookieHeader = "session=" + activeSessionToken_ + "; Path=/; HttpOnly; SameSite=Strict; Max-Age=600";
    server_.sendHeader("Set-Cookie", cookieHeader);
    loginAttemptCount_ = 0;  // Reset on successful login
    server_.send(200, "text/plain", "OK");
  } else {
    // Increment failed attempt counter
    loginAttemptCount_++;
    lastLoginAttemptTime_ = millis();
    server_.send(401, "text/plain", "Unauthorized");
  }
}

void WebPortal::apiLogout() {
  activeSessionToken_ = "";
  // Clear cookie with SameSite attribute for consistency
  server_.sendHeader("Set-Cookie", "session=deleted; Path=/; HttpOnly; SameSite=Lax; Expires=Thu, 01 Jan 1970 00:00:00 GMT");
  server_.send(200, "text/plain", "OK");
}

void WebPortal::apiRestart() {
  server_.send(200, "text/plain", "OK");
  NetworkManager::restart();
}

void WebPortal::apiFactoryReset() {
  server_.send(200, "text/plain", "OK");

  // Clear NVS Preferences (relay states, operation mode, timer settings)
  // that survive a config.json wipe (P2 review fix)
  Preferences prefs;
  prefs.begin("pool-pump", false);
  prefs.clear();
  prefs.end();
  prefs.begin("solar-pump", false);
  prefs.clear();
  prefs.end();
  prefs.begin("pool-controller", false);
  prefs.clear();
  prefs.end();

  ConfigManager::reset();
  ConfigManager::save();
  NetworkManager::restart();
}

void WebPortal::apiUpdateCheck() {
  if (!NetworkManager::isWiFiConnected()) {
    server_.send(503, "application/json", "{\"status\":\"error\",\"message\":\"No WiFi\"}");
    return;
  }

  if (OtaUpdater::isUpdateInProgress()) {
    server_.send(409, "application/json", "{\"status\":\"error\",\"message\":\"Update in progress\"}");
    return;
  }

  bool available = OtaUpdater::checkForUpdate();

  JsonDocument doc;
  doc["status"] = available ? "update_available" : "up_to_date";
  doc["current_version"] = OtaUpdater::getCurrentVersion();
  doc["latest_version"] = OtaUpdater::getLatestVersion();
  if (available) {
    doc["release_url"] = OtaUpdater::getReleaseUrl();
  }

  String json;
  serializeJson(doc, json);
  server_.send(200, "application/json", json);
}

void WebPortal::apiUpdateStatus() {
  JsonDocument doc;
  doc["current_version"] = OtaUpdater::getCurrentVersion();
  doc["latest_version"] = OtaUpdater::getLatestVersion();
  doc["update_available"] = OtaUpdater::isUpdateAvailable();
  doc["update_in_progress"] = OtaUpdater::isUpdateInProgress();
  doc["progress"] = OtaUpdater::getProgress();
  doc["status_message"] = OtaUpdater::getStatusMessage();
  doc["release_url"] = OtaUpdater::getReleaseUrl();

  String json;
  serializeJson(doc, json);
  server_.send(200, "application/json", json);
}

void WebPortal::apiUpdateInstall() {
  if (!NetworkManager::isWiFiConnected()) {
    server_.send(503, "application/json", "{\"status\":\"error\",\"message\":\"No WiFi\"}");
    return;
  }

  if (!OtaUpdater::isUpdateAvailable()) {
    server_.send(400, "application/json", "{\"status\":\"error\",\"message\":\"No update available\"}");
    return;
  }

  if (OtaUpdater::isUpdateInProgress()) {
    server_.send(409, "application/json", "{\"status\":\"error\",\"message\":\"Already installing\"}");
    return;
  }

  // Send immediate response before update starts
  server_.send(200, "application/json", "{\"status\":\"started\"}");

  OtaUpdater::startUpdate();
  // If we return here, the update failed (success reboots)
}

// ── Sensor mapping helpers ─────────────────────────────────────────────

/**
 * @brief Parse a 16-character hex string into an 8-byte DeviceAddress.
 * @param hex  Hex string like "28AABBCCDDEEFF11" (case-insensitive).
 * @param addr Output buffer for the 8-byte address.
 * @return true on success, false if the string is malformed.
 */
static bool hexStringToAddress(const String &hex, uint8_t addr[8]) {
  if (hex.length() != 16)
    return false;
  for (uint8_t i = 0; i < 8; i++) {
    char byteStr[3] = {hex[i * 2], hex[i * 2 + 1], '\0'};
    char *end = nullptr;
    unsigned long val = strtoul(byteStr, &end, 16);
    if (end != byteStr + 2)
      return false;
    addr[i] = static_cast<uint8_t>(val);
  }
  return true;
}

// ═══════════════════════════════════════════════════════════════════════
// Sensor REST API handlers
// ═══════════════════════════════════════════════════════════════════════

void WebPortal::apiGetSensors() {
  JsonDocument doc;

  // ── Detected devices ────────────────────────────────────────────────
  // Collect unique addresses from both temperature node buses.
  // In shared-bus mode (NORVI) this produces one list; in dual-bus mode
  // devices from both segments are merged.
  JsonArray detected = doc["detected"].to<JsonArray>();
  uint8_t maxDevices = max(solarTemperatureNode.getDeviceCount(), poolTemperatureNode.getDeviceCount());

  // Dedup with a fixed-size array (practical max ~20 DS18B20 per bus)
  static constexpr uint8_t kMaxDevices = 20;
  String seen[kMaxDevices];
  uint8_t seenCount = 0;

  for (uint8_t i = 0; i < maxDevices && seenCount < kMaxDevices; i++) {
    DeviceAddress addr;
    float temp = NAN;

    // Try solar node first, fall back to pool node
    if (i < solarTemperatureNode.getDeviceCount() && solarTemperatureNode.getDetectedDeviceAddress(i, addr)) {
      temp = solarTemperatureNode.getDetectedDeviceTemperature(i);
    } else if (i < poolTemperatureNode.getDeviceCount() && poolTemperatureNode.getDetectedDeviceAddress(i, addr)) {
      temp = poolTemperatureNode.getDetectedDeviceTemperature(i);
    } else {
      continue;
    }

    // Format address as hex string
    char addrStr[17];
    snprintf(addrStr, sizeof(addrStr), "%02X%02X%02X%02X%02X%02X%02X%02X", addr[0], addr[1], addr[2], addr[3], addr[4], addr[5],
      addr[6], addr[7]);

    // Deduplicate (same address may appear on shared bus)
    bool alreadySeen = false;
    for (uint8_t si = 0; si < seenCount; si++) {
      if (seen[si] == addrStr) {
        alreadySeen = true;
        break;
      }
    }
    if (alreadySeen)
      continue;
    seen[seenCount++] = addrStr;

    JsonObject dev = detected.add<JsonObject>();
    dev["address"] = addrStr;
    if (!isnan(temp))
      dev["temperature"] = temp;
  }

  // ── Current role mapping ────────────────────────────────────────────
  JsonObject mapping = doc["mapping"].to<JsonObject>();

  if (solarTemperatureNode.hasAddressFilter()) {
    char buf[17];
    solarTemperatureNode.getDeviceAddressString(buf, sizeof(buf));
    mapping["solar"] = buf;
  } else {
    mapping["solar"] = nullptr;
  }

  if (poolTemperatureNode.hasAddressFilter()) {
    char buf[17];
    poolTemperatureNode.getDeviceAddressString(buf, sizeof(buf));
    mapping["pool"] = buf;
  } else {
    mapping["pool"] = nullptr;
  }

  // Also include whether the address is currently found on the bus
  mapping["solar_found"] = solarTemperatureNode.isSensorFound();
  mapping["pool_found"] = poolTemperatureNode.isSensorFound();

  // Sensor node names for display
  mapping["solar_name"] = "Solar Temperature";
  mapping["pool_name"] = "Pool Temperature";

  String json;
  serializeJson(doc, json);
  server_.send(200, "application/json", json);
}

void WebPortal::apiSaveSensorMapping() {
  uint8_t solarAddr[8] = {0};
  uint8_t poolAddr[8] = {0};
  bool hasSolar = false, hasPool = false;

  if (server_.hasArg("solar_addr") && server_.arg("solar_addr").length() > 0) {
    if (!hexStringToAddress(server_.arg("solar_addr"), solarAddr)) {
      server_.send(400, "application/json", "{\"status\":\"error\",\"message\":\"Invalid solar address format\"}");
      return;
    }
    hasSolar = true;
  }

  if (server_.hasArg("pool_addr") && server_.arg("pool_addr").length() > 0) {
    if (!hexStringToAddress(server_.arg("pool_addr"), poolAddr)) {
      server_.send(400, "application/json", "{\"status\":\"error\",\"message\":\"Invalid pool address format\"}");
      return;
    }
    hasPool = true;
  }

  if (!hasSolar && !hasPool) {
    server_.send(400, "application/json", "{\"status\":\"error\",\"message\":\"At least one sensor address required\"}");
    return;
  }

  // Save to NVS (persistent across reboots)
  ConfigManager::saveSensorMapping(solarAddr, poolAddr);

  // Apply to running instances immediately
  if (hasSolar) {
    solarTemperatureNode.setAddressFilter(solarAddr);
  }
  if (hasPool) {
    poolTemperatureNode.setAddressFilter(poolAddr);
  }

  server_.send(200, "application/json", "{\"status\":\"ok\",\"message\":\"Sensor mapping saved. Reboot to apply.\"}");
}

// ═══════════════════════════════════════════════════════════════════════
// LittleFS file upload handler
// ═══════════════════════════════════════════════════════════════════════

void WebPortal::apiFsUpload() {
  // POST completion handler — called after all upload chunks are processed.
  // The actual file writing is done in handleFsUploadStream().
  // If fsUploadFile is still open, close it as a safety net.
  if (fsUploadFile) {
    fsUploadFile.close();
  }
  server_.send(200, "text/plain", "OK");
}

void WebPortal::handleFsUploadStream() {
  if (!isClientAuthenticated())
    return;

  HTTPUpload &upload = server_.upload();

  if (upload.status == UPLOAD_FILE_START) {
    // Close any previously open file (safety cleanup)
    if (fsUploadFile) {
      fsUploadFile.close();
    }

    // Resolve the target path — try multipart form field "path" first,
    // then fall back to upload.filename (which is set from the Content-Disposition
    // filename attribute). server_.arg("path") is unreliable during the upload
    // callback because the multipart arg parser may not have finished yet for
    // fields that arrive before the file part.
    String path;
    if (server_.hasArg("path")) {
      path = server_.arg("path");
    } else if (upload.filename.length() > 0) {
      path = upload.filename;
    }
    if (path.length() == 0) {
      LOG_WARN("FS Upload: missing path argument — aborting\n");
      return;
    }

    // Security: only allow files under /web/
    if (!path.startsWith("/web/")) {
      LOG_WARN("FS Upload: path \"%s\" not under /web/ — rejected\n", path.c_str());
      return;
    }

    // Security: prevent path traversal
    if (path.indexOf("..") != -1) {
      LOG_WARN("FS Upload: path traversal detected: \"%s\"\n", path.c_str());
      return;
    }

    // Ensure the /web/ directory exists
    if (!LittleFS.exists("/web")) {
      LittleFS.mkdir("/web");
    }

    // Invalidate a stale pre-compressed sibling: serveWebFile() prefers the
    // .gz variant, so uploading a newer plain asset must not leave an old
    // .gz in place (it would be served forever). The .gz is re-created by
    // the next upload of the compressed variant.
    if (!path.endsWith(".gz")) {
      String gzPath = path + ".gz";
      if (LittleFS.exists(gzPath.c_str())) {
        LittleFS.remove(gzPath.c_str());
        LOG_INFO("FS Upload: removed stale \"%s\"\n", gzPath.c_str());
      }
    }

    fsUploadFile = LittleFS.open(path, "w");
    if (!fsUploadFile) {
      LOG_ERROR("FS Upload: failed to open \"%s\" for writing\n", path.c_str());
      return;
    }

    LOG_INFO("FS Upload: started \"%s\" (%u bytes)\n", path.c_str(), upload.totalSize);

  } else if (upload.status == UPLOAD_FILE_WRITE) {
    if (fsUploadFile) {
      fsUploadFile.write(upload.buf, upload.currentSize);
    }

  } else if (upload.status == UPLOAD_FILE_END) {
    if (fsUploadFile) {
      fsUploadFile.close();
      LOG_INFO("FS Upload: finished \"%s\" (%u bytes)\n", upload.filename.c_str(), upload.totalSize);
    }
  }
}

}  // namespace PoolController
