smart-swimmingpool/pool-controller/src/Rule.hpp

// Copyright (c) 2018-2026 Smart Swimming Pool, Stephan Strittmatter
//
// SPDX-License-Identifier: MIT

/**
 * @file Rule.hpp
 * @brief Abstract base class for all operation mode rules.
 */

#pragma once

#include <Arduino.h>
#include "Timer.hpp"

// Uncomment to enable verbose timer debugging (reduces ~50K log lines/day)
// #define DEBUG_RULE_TIMER

/**
 * @brief Abstract base for operation mode rule implementations.
 *
 * Each concrete subclass (RuleAuto, RuleManu, RuleBoost, RuleTimer)
 * implements a specific pump control strategy. The base class provides
 * shared temperature accessors and the pool-pump timer logic.
 */
class Rule {
public:
  Rule() : _poolTemp(0.0), _solarTemp(0.0), _poolMaxTemp(0.0), _solarMinTemp(0.0), _hysteresis(0.0) {}
  virtual ~Rule() = default;

  void setPoolTemperature(float temp) { _poolTemp = temp; }
  float getPoolTemperature() const { return _poolTemp; }
  void setSolarTemperature(float temp) { _solarTemp = temp; }
  float getSolarTemperature() const { return _solarTemp; }

  void setPoolMaxTemperature(float temp) { _poolMaxTemp = temp; }
  float getPoolMaxTemperature() const { return _poolMaxTemp; }

  void setSolarMinTemperature(float temp) { _solarMinTemp = temp; }
  float getSolarMinTemperature() const { return _solarMinTemp; }

  void setTemperatureHysteresis(float temp) { _hysteresis = temp; }
  float getTemperatureHysteresis() const { return _hysteresis; }

  void setTimerSetting(TimerSetting setting) { _timerSetting = setting; }
  TimerSetting getTimerSetting() const { return _timerSetting; }

  /**
   * @brief Get the mode identifier for this rule.
   * @return String constant e.g. "auto", "manu", "boost", "timer".
   */
  virtual const char *getMode() = 0;
  virtual void loop() = 0;

  /**
   * @brief Reset temperature-based runtime extension (call on mode change).
   */
  void resetTemperatureExtension() {
    _activeEndMinutes = 0;
    _activeEndTime = 0;
  }

  /**
   * @brief Get current temperature-extended end time in minutes since midnight.
   * @return 0 if no extension active, otherwise extended end in minutes since midnight.
   */
  uint16_t getActiveEndMinutes() const { return _activeEndMinutes; }

  /**
   * @brief Get the effective runtime in minutes (actual circulation duration).
   *
   * Computes the difference between the extended end time and the timer start,
   * handling midnight crossing. When no extension is active, returns the base
   * timer runtime.
   *
   * @return Effective runtime in minutes (0-1440).
   */
  uint16_t getEffectiveRuntimeMinutes() const {
    TimerSetting ts = getTimerSetting();
    uint16_t baseStart = ts.timerStartHour * 60 + ts.timerStartMinutes;
    uint16_t baseEnd = ts.timerEndHour * 60 + ts.timerEndMinutes;

    // Base runtime (handles midnight crossing)
    uint16_t baseRuntime;
    if (baseEnd >= baseStart) {
      baseRuntime = baseEnd - baseStart;
    } else {
      baseRuntime = (1440 - baseStart) + baseEnd;
    }

    if (_activeEndMinutes == 0) {
      return baseRuntime;
    }

    // Extended runtime
    if (_activeEndMinutes >= baseStart) {
      return _activeEndMinutes - baseStart;
    } else {
      // Extended end wraps past midnight
      return (1440 - baseStart) + _activeEndMinutes;
    }
  }

  /**
   * @brief Get the temperature-based circulation extension in minutes.
   *
   * Returns how many extra minutes beyond the base timer runtime are active
   * due to warm water. When no extension is active, returns 0.
   *
   * @return Extension in minutes (0-1440).
   */
  uint16_t getCirculationExtensionMinutes() const {
    if (_activeEndMinutes == 0) {
      return 0;
    }

    uint16_t total = getEffectiveRuntimeMinutes();
    TimerSetting ts = getTimerSetting();
    uint16_t baseStart = ts.timerStartHour * 60 + ts.timerStartMinutes;
    uint16_t baseEnd = ts.timerEndHour * 60 + ts.timerEndMinutes;

    uint16_t baseRuntime;
    if (baseEnd >= baseStart) {
      baseRuntime = baseEnd - baseStart;
    } else {
      baseRuntime = (1440 - baseStart) + baseEnd;
    }

    return (total > baseRuntime) ? (total - baseRuntime) : 0;
  }

protected:
  static constexpr const char *cIndent = "  ";

  /**
   * @brief Check pool pump timer with temperature-based runtime extension.
   *
   * Extends the timer end time when pool temperature exceeds the configured
   * threshold (tempCircThreshold). The end time only moves later ("only-extend"
   * policy) to avoid the pump shutting off unexpectedly during a cycle.
   *
   * @param poolTemp  Current pool water temperature in °C. Pass NaN or <= 0
   *                  to use the standard timer without extension.
   * @return true if the pump should be ON (within the timer window or extended
   *         window).
   */
  bool checkPoolPumpTimer(float poolTemp) {
#ifdef DEBUG_RULE_TIMER
    Serial.println("↕  checkPoolPumpTimer");
#endif

    tm time = getCurrentDateTime();

    // Check if time sync is valid
    if (time.tm_year == -1) {
#ifdef DEBUG_RULE_TIMER
      Serial.println("  ⚠ Time sync RED - timer disabled");
#endif
#ifdef DEBUG_RULE_TIMER
      Serial.println("  Pool pump stays ON for safety & hygiene");
#endif
      return true;
    }

    TimerSetting ts = getTimerSetting();
    tm startTime = getStartTime(time, ts);
    tm endTime = getEndTime(time, ts);
    uint16_t baseStartMinutes = ts.timerStartHour * 60 + ts.timerStartMinutes;
    uint16_t baseEndMinutes = ts.timerEndHour * 60 + ts.timerEndMinutes;

#ifdef DEBUG_RULE_TIMER
    char timeBuf[26];
    asctime_r(&time, timeBuf);
    Serial.printf("  currenttime = %s", timeBuf);
#endif
#ifdef DEBUG_RULE_TIMER
    char startBuf[26];
    asctime_r(&startTime, startBuf);
    Serial.printf("  startTime   = %s", startBuf);
#endif
#ifdef DEBUG_RULE_TIMER
    char endBuf[26];
    asctime_r(&endTime, endBuf);
    Serial.printf("  endTime     = %s", endBuf);
#endif

    time_t now = mktime(&time);
    time_t start = mktime(&startTime);
    time_t end = mktime(&endTime);

    bool crossesMidnight = (ts.timerStartHour > ts.timerEndHour) ||
      (ts.timerStartHour == ts.timerEndHour && ts.timerStartMinutes > ts.timerEndMinutes);

    // Determine if the base timer window is active
    bool timerActive;
    if (crossesMidnight) {
      timerActive = (difftime(now, start) >= 0) || (difftime(now, end) <= 0);
    } else {
      timerActive = (difftime(now, start) >= 0) && (difftime(now, end) <= 0);
    }

    // Step 1: If timer is active, apply temperature extension
    if (timerActive && poolTemp > 0.0f && poolTemp == poolTemp) {
      uint16_t extendedEnd = calculateEffectiveEndMinutes(baseStartMinutes, baseEndMinutes, poolTemp);

      // Absolute expiry anchored to the current cycle's base start. Minutes
      // since midnight alone cannot tell a wrap-past-midnight end apart from
      // the next cycle's start — e.g. a full-day extension (max runtime 1440)
      // ends exactly at the next base start and would otherwise never expire,
      // keeping the pump on even after the water cools.
      time_t cycleStart = start;
      if (crossesMidnight && now < start) {
        // Post-midnight part of a midnight-crossing window: the cycle started
        // on the previous day.
        cycleStart = start - 86400;
      }
      int totalRuntime = static_cast<int>(extendedEnd) - static_cast<int>(baseStartMinutes);
      time_t expiry = cycleStart + static_cast<time_t>(totalRuntime) * 60;

      // Only extend, never shorten (within the current cycle)
      if (expiry > _activeEndTime) {
        _activeEndTime = expiry;
        _activeEndMinutes = extendedEnd;
        uint8_t eh = (_activeEndMinutes / 60) % 24;
        uint8_t em = _activeEndMinutes % 60;
#ifdef DEBUG_RULE_TIMER
        Serial.printf("  → Temperature extension: end now %02d:%02d\n", eh, em);
#endif
      }
    }

    // Step 2: Check if we're within the extended window
    if (_activeEndTime > 0) {
      if (now < _activeEndTime) {
#ifdef DEBUG_RULE_TIMER
        uint16_t normalizedEnd = _activeEndMinutes % 1440;
        Serial.printf(
          "  checkPoolPumpTimer = true (extended to %02d:%02d)\n", (uint8_t)(normalizedEnd / 60), (uint8_t)(normalizedEnd % 60));
#endif
        return true;
      }

      // Extended window expired — reset
      _activeEndTime = 0;
      _activeEndMinutes = 0;
    }

    // Step 3: Base timer active (no extension or extension expired)
    if (timerActive) {
#ifdef DEBUG_RULE_TIMER
      Serial.printf("  checkPoolPumpTimer = true\n");
#endif
      return true;
    }

// Timer not active and no extension → pump stays OFF
#ifdef DEBUG_RULE_TIMER
    Serial.printf("  checkPoolPumpTimer = false\n");
#endif
    return false;
  }

  /** @brief Standard timer check without temperature extension. */
  bool checkPoolPumpTimer() {
#ifdef DEBUG_RULE_TIMER
    Serial.println("↕  checkPoolPumpTimer");
#endif

    tm time = getCurrentDateTime();

    // Check if time sync is valid
    if (time.tm_year == -1) {
#ifdef DEBUG_RULE_TIMER
      Serial.println("  ⚠ Time sync RED - timer disabled");
#endif
#ifdef DEBUG_RULE_TIMER
      Serial.println("  Pool pump stays ON for safety & hygiene");
#endif
      return true;
    }

    bool retval;

    tm startTime = getStartTime(time, getTimerSetting());
    tm endTime = getEndTime(time, getTimerSetting());

#ifdef DEBUG_RULE_TIMER
    char timeBuf[26];
    asctime_r(&time, timeBuf);
    Serial.printf("  currenttime = %s", timeBuf);
#endif
#ifdef DEBUG_RULE_TIMER
    char startBuf[26];
    asctime_r(&startTime, startBuf);
    Serial.printf("  startTime   = %s", startBuf);
#endif
#ifdef DEBUG_RULE_TIMER
    char endBuf[26];
    asctime_r(&endTime, endBuf);
    Serial.printf("  endTime     = %s", endBuf);
#endif

    // Convert tm structs to time_t once to avoid multiple mktime calls
    time_t now = mktime(&time);
    time_t start = mktime(&startTime);
    time_t end = mktime(&endTime);

    // Handle midnight crossing: check if timer spans midnight
    TimerSetting ts = getTimerSetting();
    bool crossesMidnight = (ts.timerStartHour > ts.timerEndHour) ||
      (ts.timerStartHour == ts.timerEndHour && ts.timerStartMinutes > ts.timerEndMinutes);

    if (crossesMidnight) {
      // Timer crosses midnight (e.g., 22:00 - 02:00)
      // Active if: time >= start OR time <= end
      retval = (difftime(now, start) >= 0) || (difftime(now, end) <= 0);
    } else {
      // Normal case: timer within same day
      // Active if: time >= start AND time <= end
      retval = (difftime(now, start) >= 0) && (difftime(now, end) <= 0);
    }

#ifdef DEBUG_RULE_TIMER
    Serial.printf("  checkPoolPumpTimer = %s\n", retval ? "true" : "false");
#endif
    return retval;
  }

  float _poolTemp;
  float _solarTemp;

  float _poolMaxTemp;
  float _solarMinTemp;

  float _hysteresis;

  TimerSetting _timerSetting;
  uint16_t _activeEndMinutes = 0;  ///< Temperature-extended end in minutes since midnight
  time_t _activeEndTime = 0;       ///< Absolute expiry of the temperature extension (0 = none)
};
