smart-swimmingpool/pool-controller/src/OperationModeNode.hpp

// Copyright (c) 2018-2026 Smart Swimming Pool, Stephan Strittmatter
//
// SPDX-License-Identifier: MIT

/**
 * @file OperationModeNode.hpp
 * @brief Operation mode selector — manages rules, mode switching, and state persistence.
 */

#pragma once

#include <Arduino.h>
#include <vector>
#include <memory>

#include "DallasTemperatureNode.hpp"
#include "OperationMode.hpp"
#include "Rule.hpp"
#include "Timer.hpp"
#include "TimeClientHelper.hpp"

/**
 * @brief Manages the active operation mode and delegates control to the matching Rule.
 *
 * Holds a vector of Rule instances (Auto, Manu, Boost, Timer), switches between
 * them on mode change, and persists the active mode and temperature thresholds
 * to NVS. Exposes configuration properties for Home Assistant integration.
 */
class OperationModeNode {
public:
  OperationModeNode(const char *id, const char *name, const int measurementInterval = MEASUREMENT_INTERVAL);
  ~OperationModeNode() = default;

  void setMeasurementInterval(uint32_t interval) { _measurementInterval = interval; }
  uint32_t getMeasurementInterval() const { return _measurementInterval; }

  // String overloads remain as protocol/persistence compatibility adapters.
  bool setMode(String mode);
  bool setMode(String mode, const char *source);
  bool setMode(PoolController::OperationMode mode, const char *source = "unspecified");

  String getMode() const { return String(PoolController::toString(_mode)); }
  const char *getModeCStr() const { return PoolController::toString(_mode); }
  PoolController::OperationMode getTypedMode() const { return _mode; }

  void addRule(Rule *rule);
  Rule *getRule();

  void setPoolTemperatureNode(DallasTemperatureNode *node) { _currentPoolTempNode = node; }
  void setSolarTemperatureNode(DallasTemperatureNode *node) { _currentSolarTempNode = node; }

  void setPoolMaxTemperature(float temp) {
    _poolMaxTemp = temp;
    if (!_suppressPersist)
      saveState();
  }
  float getPoolMaxTemperature() const { return _poolMaxTemp; }

  void setSolarMinTemperature(float temp) {
    _solarMinTemp = temp;
    if (!_suppressPersist)
      saveState();
  }
  float getSolarMinTemperature() const { return _solarMinTemp; }

  void setTemperatureHysteresis(float temp) {
    _hysteresis = temp;
    if (!_suppressPersist)
      saveState();
  }
  float getTemperatureHysteresis() const { return _hysteresis; }

  void setTimerSetting(TimerSetting setting) {
    _timerSetting = setting;
    if (!_suppressPersist)
      saveState();
  }
  TimerSetting getTimerSetting() const { return _timerSetting; }

  void loadState();
  void saveState();
  bool handleHomeAssistantCommand(const char *property, const char *value);
  bool applyProperty(const String &property, const String &value);

  static void suppressPersist(bool suppress) { _suppressPersist = suppress; }

  static constexpr const char *STATUS_AUTO = "auto";
  static constexpr const char *STATUS_MANU = "manu";
  static constexpr const char *STATUS_BOOST = "boost";
  static constexpr const char *STATUS_TIMER = "timer";

  void begin();
  void loop();

private:
  static bool _suppressPersist;

  static const int MIN_INTERVAL = 10;  // in seconds
  static const int MEASUREMENT_INTERVAL = 300;

  const char *_id;
  const char *_name;

  PoolController::OperationMode _mode = PoolController::OperationMode::AUTO;
  float _poolMaxTemp = 28.5f;
  float _solarMinTemp = 55.0f;
  float _hysteresis = 1.0f;

  // Use unique_ptr to manage rules automatically and safely (F19 Fix!)
  std::vector<std::unique_ptr<Rule>> _ruleVec;

  DallasTemperatureNode *_currentPoolTempNode = nullptr;
  DallasTemperatureNode *_currentSolarTempNode = nullptr;

  TimerSetting _timerSetting;

  uint32_t _measurementInterval;
  uint32_t _lastMeasurement;
};
