smart-swimmingpool/pool-controller/src/MqttPublisher.hpp

// Copyright (c) 2018-2026 Smart Swimming Pool, Stephan Strittmatter
//
// SPDX-License-Identifier: MIT

/**
 * @file MqttPublisher.hpp
 * @brief Home Assistant MQTT Discovery — publishes entities and telemetry.
 */

#pragma once

#include <Arduino.h>
#include <ArduinoJson.h>
#include <AsyncMqttClient.h>
#include <cstdint>

namespace PoolController {

/**
 * @brief Publishes Home Assistant MQTT Discovery configs and telemetry states.
 *
 * On startup and MQTT (re)connect, announces all entities via HA Discovery
 * topics. Periodically publishes sensor values and relay states. Handles
 * incoming MQTT commands (mode, pump toggle, config changes).
 */
class MqttPublisher {
public:
  MqttPublisher() = default;

  /** @brief Initialize MQTT publisher — set up message callback and subscribe to command topics. */
  static void begin();
  /** @brief Publish Home Assistant MQTT Discovery configs for all entities. */
  static void publishDiscovery();
  /** @brief Publish current telemetry states (temperatures, relays, mode). */
  static void publishStates();
  /**
   * @brief Handle an incoming MQTT message from Home Assistant.
   *
   * Changes controller state — call only on the loop task (via
   * processPendingCommands()), never from the MQTT client callback.
   * @param topic   The MQTT topic the message was received on.
   * @param payload Null-terminated payload string.
   * @param properties  Message properties (QoS, retain, dup).
   * @param len     Payload length.
   * @param index   Chunk index (0 for single-chunk messages).
   * @param total   Total payload size across all chunks.
   */
  static void handleMqttMessage(
    char *topic, char *payload, AsyncMqttClientMessageProperties properties, size_t len, size_t index, size_t total);

  /**
   * MQTT client callback — runs on the AsyncTCP task. Only copies the message
   * into the command queue; it is handled by processPendingCommands() on the
   * loop task. Incomplete (chunked) or oversized messages are dropped.
   */
  static void onMqttMessage(
    char *topic, char *payload, AsyncMqttClientMessageProperties properties, size_t len, size_t index, size_t total);

  /// Maximum number of queued commands handled per loop iteration.
  static constexpr size_t kMaxCommandsPerLoop = 2;

  /// Handle up to kMaxCommandsPerLoop queued MQTT commands. Call from the loop task only.
  static void processPendingCommands();

  // ── Command validation (public for testing) ──
  /** @brief Validate a command against a whitelist. */
  static bool isValidCommand(const char *value, const char *const validCommands[], size_t count);
  static bool isValidCommand(const String &value, const char *const validCommands[], size_t count);

private:
  static void publishTextDiscovery(
    const char *objectId, const char *name, const char *icon = nullptr, const char *entityCategory = nullptr);
  static void publishSensorDiscovery(const char *objectId, const char *name, const char *deviceClass = nullptr,
    const char *unit = nullptr, const char *icon = nullptr, const char *entityCategory = nullptr,
    const char *stateClass = nullptr);
  static void publishBinarySensorDiscovery(const char *objectId, const char *name, const char *payloadOn = "ON",
    const char *payloadOff = "OFF", const char *deviceClass = nullptr, const char *icon = nullptr,
    const char *entityCategory = nullptr);
  static void publishSwitchDiscovery(const char *objectId, const char *name, const char *icon = nullptr,
    const char *entityCategory = nullptr, const char *deviceClass = nullptr);
  static void publishSelectDiscovery(const char *objectId, const char *name, const char *const *options, size_t optionCount,
    const char *icon = nullptr, const char *entityCategory = nullptr);
  static void publishNumberDiscovery(const char *objectId, const char *name, double minVal, double maxVal, double step,
    const char *unit = nullptr, const char *icon = nullptr, const char *entityCategory = nullptr);
  static void publishTimeDiscovery(
    const char *objectId, const char *name, const char *icon = nullptr, const char *entityCategory = nullptr);
  static void publishUpdateDiscovery();
  static void publishClimateDiscovery();
  /** @brief Publish select-entity discovery for sensor-to-role mapping (detected addresses as options). */
  static void publishSensorMappingDiscovery();
  /**
   * @brief Publish HA MQTT "event" component discovery for curated log events.
   * @param objectId  Entity object id (e.g. "logs").
   * @param name      Display name.
   * @param icon      Optional MDI icon.
   */
  static void publishEventDiscovery(const char *objectId, const char *name, const char *icon = nullptr);
  /**
   * @brief Export new LogCapture entries as MQTT events (WARN/ERROR + curated
   * logEvent markers). Called from publishStates(); deduplicated via
   * s_lastExportedSeq and guarded against reentrancy from the AsyncTCP
   * callback task (handleMqttMessage → publishStates).
   */
  static void exportLogEvents();

  static void getBaseTopic(char *buf, size_t bufSize, const char *component, const char *objectId);
  static void addDeviceInfo(JsonDocument &doc);
  static void publishUpdateState();
  static void publishClimateState();

  static String deviceId_;
  /** @brief Sequence watermark for the MQTT log-event export pump (LogCapture::seq). */
  static std::uint32_t s_lastExportedSeq;
};

}  // namespace PoolController
