smart-swimmingpool/pool-controller/src/RelayModuleNode.cpp

// Copyright (c) 2018-2026 Smart Swimming Pool, Stephan Strittmatter
//
// SPDX-License-Identifier: MIT

/**
 * @file RelayModuleNode.cpp
 * @brief Relay node implementation — state persistence via NVS and safe-mode
 *        override for boot-loop protection.
 */

#include "RelayModuleNode.hpp"
#include "Utils.hpp"
#include "DegradationManager.hpp"
#include "LogCapture.hpp"

RelayModuleNode::RelayModuleNode(const char *id, const char *name, const uint8_t pin) : RelayModuleNode(id, name, pin, true) {}

RelayModuleNode::RelayModuleNode(const char *id, const char *name, const uint8_t pin, const bool activeLow) {
  _id = id;
  _name = name;
  _pin = pin;
  _activeLow = activeLow;
  _measurementInterval = MEASUREMENT_INTERVAL;
  _lastMeasurement = 0;
}

void RelayModuleNode::begin() {
  LOG_INFO("• RelayModule Node '%s' initializing on PIN %d...\n", _id, _pin);

  // ── Safe-start sequence ───────────────────────────────────────────────
  //
  // 1. Pre-set GPIO output register to OFF level BEFORE pinMode(OUTPUT).
  //    On ESP32, digitalWrite() writes to the GPIO_OUT register via W1TS/W1TC
  //    even while the pin is still in INPUT mode — the safe level is ready
  //    the moment pinMode() switches the pin to OUTPUT.
  //
  //    This prevents:
  //    • A stale NVS state ("switch"=true) from a previous relay pin
  //      (e.g. R1→R5 migration) from immediately energizing the new relay.
  //    • Any glitch from the GPIO_OUT register's power-on reset value
  //      (which is undefined / bootloader-dependent).
  //    • A window between pinMode() and the first digitalWrite() where the
  //      output could float or hold an old register value.
  //
  //    Polarity-independent OFF:
  //      active-LOW  → OFF = HIGH
  //      active-HIGH → OFF = LOW
  digitalWrite(_pin, _activeLow ? HIGH : LOW);
  pinMode(_pin, OUTPUT);

  // 2. Load persisted state from NVS
  preferences.begin(_id, false);
  _currentState = preferences.getBool("switch", false);
  preferences.end();

  // 3. Apply polarity and transition to persisted state (OFF→ON if needed)
  digitalWrite(_pin, _currentState == _activeLow ? LOW : HIGH);

  LOG_INFO("  ◦ Relay restored to state: %s\n", _currentState ? "ON" : "OFF");
}

void RelayModuleNode::setSwitch(const bool state) {
  if (_currentState == state) {
    return;
  }

  // P8: In safe mode (boot-loop detected / CRITICAL degradation), never allow
  // a relay to switch ON. Only OFF transitions are permitted so relays default
  // to the safe OFF state.
  if (state && PoolController::DegradationManager::isSafe()) {
    LOG_WARN("  ⚠ SAFE MODE — ignoring relay ON request\n");
    return;
  }

  // Apply polarity: active-LOW  → ON = LOW,  OFF = HIGH
  //                active-HIGH → ON = HIGH, OFF = LOW
  digitalWrite(_pin, state == _activeLow ? LOW : HIGH);
  _currentState = state;

  // Curated log event for MQTT event entity (only on real state change)
  PoolController::LogCapture::logEvent(state ? "PUMP_ON" : "PUMP_OFF", "%s %s", getId(), state ? "ON" : "OFF");

  // Persist relay state via Preferences (NVS)
  preferences.begin(_id, false);
  preferences.putBool("switch", state);
  preferences.end();

  LOG_INFO("  ◦ Relay '%s' switched to: %s\n", _id, state ? "ON" : "OFF");
}

bool RelayModuleNode::getSwitch() {
  return _currentState;
}

void RelayModuleNode::loop() {
  if (Utils::shouldMeasure(_lastMeasurement, _measurementInterval)) {
    _lastMeasurement = millis();
    LOG_DEBUG("〽 Relay '%s' status: %s\n", _id, getSwitch() ? "ON" : "OFF");
  }
}
