smart-swimmingpool/pool-controller/test/native/mocks/Arduino.h

#pragma once

#include <stdint.h>
#include <stddef.h>
#include <string.h>
#include <stdio.h>
#include <stdlib.h>
#include <cstdarg>
#include <cmath>
#include <algorithm>
#include <string>
#include <map>
#include <vector>
#include <chrono>

typedef int __FlashStringHelper;

#ifndef NAN
#define NAN __builtin_nanf("")
#endif

// ---- Basic types ----
typedef uint8_t byte;
typedef uint16_t word;

// ---- String class (Arduino-compatible) ----
class String {
public:
  String() : data_("") {}
  String(const char *s) : data_(s ? s : "") {}                          // NOLINT
  String(int val) : data_(std::to_string(val)) {}                       // NOLINT
  String(unsigned int val) : data_(std::to_string(val)) {}              // NOLINT
  String(long val) : data_(std::to_string(val)) {}                      // NOLINT
  String(unsigned long val) : data_(std::to_string(val)) {}             // NOLINT
  String(float val, int decimals = 2) : data_(std::to_string(val)) {}   // NOLINT
  String(double val, int decimals = 2) : data_(std::to_string(val)) {}  // NOLINT
  String(const String &other) : data_(other.data_) {}
  String(const char *s, size_t len) : data_(s, len) {}
  String(char c) : data_(1, c) {}  // NOLINT

  const char *c_str() const { return data_.c_str(); }
  operator std::string() const { return data_; }
  bool concat(const char *s) {
    data_ += s;
    return true;
  }
  bool concat(const String &s) {
    data_ += s.data_;
    return true;
  }
  size_t length() const { return data_.length(); }
  bool isEmpty() const { return data_.empty(); }
  void reserve(size_t n) { data_.reserve(n); }
  String &operator+=(const String &rhs) {
    data_ += rhs.data_;
    return *this;
  }
  int toInt() const { return atoi(data_.c_str()); }
  float toFloat() const { return static_cast<float>(atof(data_.c_str())); }
  String substring(int start, int end = -1) const {
    if (end < 0)
      end = data_.length();
    return data_.substr(start, end - start).c_str();
  }
  int indexOf(const String &s) const { return data_.find(s.data_); }
  int indexOf(char c) const { return data_.find(c); }
  void toUpperCase() { std::transform(data_.begin(), data_.end(), data_.begin(), ::toupper); }
  void toLowerCase() { std::transform(data_.begin(), data_.end(), data_.begin(), ::tolower); }
  String &operator=(const String &rhs) {
    data_ = rhs.data_;
    return *this;
  }
  String &operator=(const char *rhs) {
    data_ = rhs ? rhs : "";
    return *this;
  }
  String operator+(const String &rhs) const { return (data_ + rhs.data_).c_str(); }
  bool operator==(const String &rhs) const { return data_ == rhs.data_; }
  bool operator!=(const String &rhs) const { return data_ != rhs.data_; }
  bool operator<(const String &rhs) const { return data_ < rhs.data_; }
  bool operator>(const String &rhs) const { return data_ > rhs.data_; }
  bool operator>=(const String &rhs) const { return data_ >= rhs.data_; }
  bool operator<=(const String &rhs) const { return data_ <= rhs.data_; }
  char operator[](int index) const { return data_[index]; }
  char &operator[](int index) { return data_[index]; }
  bool operator==(const char *rhs) const { return data_ == rhs; }
  friend String operator+(const char *lhs, const String &rhs) { return String(lhs) + rhs; }
  void clear() { data_.clear(); }
  bool startsWith(const String &prefix) const { return data_.find(prefix.data_) == 0; }
  bool endsWith(const String &suffix) const {
    if (suffix.length() > length())
      return false;
    return data_.substr(length() - suffix.length()) == suffix.data_;
  }
  bool equalsIgnoreCase(const String &other) const {
    if (length() != other.length())
      return false;
    std::string lower1 = data_, lower2 = other.data_;
    std::transform(lower1.begin(), lower1.end(), lower1.begin(), ::tolower);
    std::transform(lower2.begin(), lower2.end(), lower2.begin(), ::tolower);
    return lower1 == lower2;
  }
  bool equalsIgnoreCase(const char *other) const { return equalsIgnoreCase(String(other)); }
  bool equals(const String &other) const { return data_ == other.data_; }
  bool equals(const char *other) const { return data_ == other; }
  char charAt(int index) const { return data_[index]; }
  void trim() {
    const char *ws = " \t\n\r";
    size_t start = data_.find_first_not_of(ws);
    size_t end = data_.find_last_not_of(ws);
    if (start == std::string::npos)
      data_.clear();
    else
      data_ = data_.substr(start, end - start + 1);
  }

private:
  std::string data_;
};

// ---- Serial mock ----
class SerialClass {
public:
  // Optional stdout capture for tests that need to assert on Serial output.
  // Disabled by default so existing tests are unaffected.
  static std::string s_capture;
  static bool s_captureEnabled;
  static void enableCapture() { s_captureEnabled = true; s_capture.clear(); }
  static void disableCapture() { s_captureEnabled = false; s_capture.clear(); }
  static const std::string &capture() { return s_capture; }

  void begin(int) {}
  void print(const char *s) {
    if (s_captureEnabled) s_capture += s;
    fprintf(stdout, "%s", s);
    fflush(stdout);
  }
  void print(int v) {
    fprintf(stdout, "%d", v);
    fflush(stdout);
  }
  void print(unsigned int v) {
    fprintf(stdout, "%u", v);
    fflush(stdout);
  }
  void print(float v) {
    fprintf(stdout, "%f", v);
    fflush(stdout);
  }
  void print(double v) {
    fprintf(stdout, "%f", v);
    fflush(stdout);
  }
  void println(const char *s) {
    fprintf(stdout, "%s\n", s);
    fflush(stdout);
  }
  void println(int v) {
    fprintf(stdout, "%d\n", v);
    fflush(stdout);
  }
  void println(unsigned int v) {
    fprintf(stdout, "%u\n", v);
    fflush(stdout);
  }
  void println(float v) {
    fprintf(stdout, "%f\n", v);
    fflush(stdout);
  }
  void println(double v) {
    fprintf(stdout, "%f\n", v);
    fflush(stdout);
  }
  void println() {
    fprintf(stdout, "\n");
    fflush(stdout);
  }
  void printf(const char *fmt, ...) {
    va_list args;
    va_start(args, fmt);
    vfprintf(stdout, fmt, args);
    fflush(stdout);
    va_end(args);
  }
  int available() { return 0; }
  int read() { return -1; }
  size_t readBytes(char *, size_t) { return 0; }
  void flush() {}
};
static SerialClass Serial;

// ---- Time functions ----
inline uint32_t millis() {
  static auto start = std::chrono::steady_clock::now();
  auto now = std::chrono::steady_clock::now();
  return std::chrono::duration_cast<std::chrono::milliseconds>(now - start).count();
}

inline void delay(uint32_t) {}

// ---- Min/max ----
#undef min
#undef max
template <typename T> inline T min(T a, T b) {
  return a < b ? a : b;
}
template <typename T> inline T max(T a, T b) {
  return a > b ? a : b;
}

// ---- IPAddress ----
class IPAddress {
public:
  IPAddress() : addr_{0, 0, 0, 0} {}
  IPAddress(uint8_t a, uint8_t b, uint8_t c, uint8_t d) : addr_{a, b, c, d} {}
  explicit IPAddress(uint32_t ip) {
    addr_[0] = (ip >> 0) & 0xFF;
    addr_[1] = (ip >> 8) & 0xFF;
    addr_[2] = (ip >> 16) & 0xFF;
    addr_[3] = (ip >> 24) & 0xFF;
  }
  String toString() const {
    char buf[20];
    snprintf(buf, sizeof(buf), "%d.%d.%d.%d", addr_[0], addr_[1], addr_[2], addr_[3]);
    return String(buf);
  }
  bool operator==(const IPAddress &o) const {
    return addr_[0] == o.addr_[0] && addr_[1] == o.addr_[1] && addr_[2] == o.addr_[2] && addr_[3] == o.addr_[3];
  }
  operator uint32_t() const { return (uint32_t)addr_[3] << 24 | (uint32_t)addr_[2] << 16 | (uint32_t)addr_[1] << 8 | addr_[0]; }
  uint8_t operator[](int i) const { return addr_[i]; }
  uint8_t &operator[](int i) { return addr_[i]; }

private:
  uint8_t addr_[4];
};

// ---- WiFi class mock ----
enum WiFiMode_t { WIFI_OFF = 0, WIFI_STA = 1, WIFI_AP = 2, WIFI_APSTA = 3 };
enum wl_status_t {
  WL_IDLE_STATUS = 0,
  WL_NO_SSID_AVAIL = 1,
  WL_SCAN_COMPLETED = 2,
  WL_CONNECTED = 3,
  WL_CONNECT_FAILED = 4,
  WL_CONNECTION_LOST = 5,
  WL_DISCONNECTED = 6
};
typedef int WiFiEvent_t;

class WiFiClass {
public:
  static wl_status_t status() { return WL_CONNECTED; }
  static int RSSI() { return -65; }
  static IPAddress localIP() { return IPAddress(192, 168, 1, 100); }
  static IPAddress softAPIP() { return IPAddress(192, 168, 4, 1); }
  static uint8_t *macAddress(uint8_t *mac) {
    static uint8_t m[6] = {0x84, 0xcc, 0xa8, 0x5a, 0x2d, 0x80};
    memcpy(mac, m, 6);
    return mac;
  }
  static String macAddress() { return "84:cc:a8:5a:2d:80"; }
  static String SSID() { return "TestSSID"; }
  static String SSID(int networkItem) { return String("TestAP"); }
  static int RSSI(int networkItem) { return -65; }
  static int encryptionType(int networkItem) { return 0; }
  static int scanNetworks() { return 2; }
  static String SOFTAPSSID() { return "PoolController-AP"; }
  static bool mode(WiFiMode_t) { return true; }
  static bool begin(const char *, const char *) { return true; }
  static void onEvent(void (*)(WiFiEvent_t)) {}
};
static WiFiClass WiFi;
#define WIFI_AUTH_OPEN 0

// ---- ESP class mock ----
class ESPClass {
public:
  static uint32_t getFreeHeap() { return 180000; }
  static uint32_t getMaxAllocHeap() { return 45000; }
  static uint32_t getEfuseMac() { return 0xDEADBEEF; }
  static void restart() {}
  static uint32_t getFlashChipSize() { return 4 * 1024 * 1024; }
  static uint32_t getSketchSize() { return 1200000; }
  static uint32_t getFreeSketchSpace() { return 800000; }
  static uint32_t getChipId() { return 0x5A2D80; }
};
static ESPClass ESP;

// ---- Preferences mock ----
class Preferences {
public:
  Preferences() : started_(false) {}
  bool begin(const char *ns, bool readOnly) {
    started_ = true;
    namespace_ = ns;
    return true;
  }
  void end() { started_ = false; }
  void clear() { s_data.clear(); }
  bool remove(const char *key) {
    s_data.erase(key);
    return true;
  }

  size_t putBytes(const char *key, const void *value, size_t len) {
    if (!started_)
      return 0;
    std::string &v = s_data[key];
    v.assign((const char *)value, len);
    return len;
  }

  size_t getBytes(const char *key, void *buf, size_t maxLen) {
    if (!started_ || s_data.find(key) == s_data.end())
      return 0;
    const std::string &v = s_data[key];
    size_t cpy = std::min(maxLen, v.size());
    memcpy(buf, v.data(), cpy);
    return cpy;
  }

  size_t putString(const char *key, const char *val) {
    if (!started_)
      return 0;
    s_data[key] = val;
    return strlen(val);
  }

  String getString(const char *key, const String &defaultVal = "") {
    if (!started_ || s_data.find(key) == s_data.end())
      return String(defaultVal);
    return String(s_data[key].c_str());
  }

  size_t putInt(const char *key, int val) {
    if (!started_)
      return 0;
    s_data[key] = std::to_string(val);
    return sizeof(int);
  }

  int getInt(const char *key, int defaultVal = 0) {
    if (!started_ || s_data.find(key) == s_data.end())
      return defaultVal;
    return atoi(s_data[key].c_str());
  }

  size_t putUInt(const char *key, unsigned int val) { return putInt(key, (int)val); }

  unsigned int getUInt(const char *key, unsigned int defaultVal = 0) { return (unsigned int)getInt(key, (int)defaultVal); }

  size_t putFloat(const char *key, float val) {
    if (!started_)
      return 0;
    s_data[key] = std::to_string(val);
    return sizeof(float);
  }

  float getFloat(const char *key, float defaultVal = 0.0f) {
    if (!started_ || s_data.find(key) == s_data.end())
      return defaultVal;
    return atof(s_data[key].c_str());
  }

  size_t putLong(const char *key, long val) {
    if (!started_)
      return 0;
    s_data[key] = std::to_string(val);
    return sizeof(long);
  }

  long getLong(const char *key, long defaultVal = 0) {
    if (!started_ || s_data.find(key) == s_data.end())
      return defaultVal;
    return atol(s_data[key].c_str());
  }

  size_t putDouble(const char *key, double val) {
    if (!started_)
      return 0;
    s_data[key] = std::to_string(val);
    return sizeof(double);
  }

  double getDouble(const char *key, double defaultVal = 0.0) {
    if (!started_ || s_data.find(key) == s_data.end())
      return defaultVal;
    return atof(s_data[key].c_str());
  }

  size_t putBool(const char *key, bool val) {
    if (!started_)
      return 0;
    s_data[key] = val ? "1" : "0";
    return 1;
  }

  bool getBool(const char *key, bool defaultVal = false) {
    if (!started_ || s_data.find(key) == s_data.end())
      return defaultVal;
    return s_data[key] == "1";
  }

  size_t putUChar(const char *key, uint8_t val) { return putInt(key, (int)val); }

  uint8_t getUChar(const char *key, uint8_t defaultVal = 0) { return (uint8_t)getInt(key, (int)defaultVal); }

  size_t putUShort(const char *key, uint16_t val) { return putInt(key, (int)val); }

  uint16_t getUShort(const char *key, uint16_t defaultVal = 0) { return (uint16_t)getInt(key, (int)defaultVal); }

  size_t putString(const char *key, const String &val) { return putString(key, val.c_str()); }

  bool isKey(const char *key) { return s_data.find(key) != s_data.end(); }

private:
  bool started_;
  std::string namespace_;
  static std::map<std::string, std::string> s_data;
};

// ---- LittleFS / FS mock ----
class File {
public:
  File() : valid_(false) {}
  bool operator!() const { return !valid_; }
  explicit operator bool() const { return valid_; }
  size_t size() { return data_.size(); }
  String readString() { return String(data_.c_str()); }
  size_t write(const uint8_t *, size_t) { return 0; }
  void close() {}
  bool seek(size_t) { return false; }
  int read() { return -1; }
  size_t readBytes(char *, size_t) { return 0; }
  bool available() { return false; }

  void _setData(const std::string &d) {
    data_ = d;
    valid_ = true;
  }
  void _setValid(bool v) { valid_ = v; }

private:
  bool valid_ = false;
  std::string data_;
};
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
