smart-swimmingpool/pool-controller/(commit log)

2018-12-27 moved project
    [Pool-Control.fzz]
2019-02-09 externalize currentValue class
2019-02-17 add RelayModuleNode
2019-02-17 save relay setting
2019-02-26 renamed and moved fzz file
    [pool-controller.fzz]
2019-03-06 add pin information
2019-03-06 reorderes for correct defaultValues. Removed duplicate vars
    [main.cpp]
2019-04-02 update for timer
2019-04-02 Update RuleAuto for timer
2019-04-15 Reorder to get Temperatures
2019-04-18 update timer handling
2019-04-23 impriove timer handling
2019-04-24 brackets alignments
2019-05-07 Add Timer rule
2019-05-25 set current temperatures for rules
2019-05-25 updated layout
    [pool-controller.fzz]
2019-08-03 Updated fritzing layout
    [pool-controller.fzz]
2021-07-02 Fixed memory leaks and some spelling mistakes (#10)
    * Fixed some memory leaks
    * Fixed more memory leaks
    [DallasTemperatureNode.cpp, DallasTemperatureNode.hpp, OperationModeNode.cpp, OperationModeNode.hpp, RelayModuleNode.hpp, Rule.hpp, RuleAuto.cpp, RuleBoost.cpp]
2022-11-01 chore: switch for ESP32 support
2026-02-15 Make NTP server configurable via Homie settings and fix Rule class linking error (#21)
    [PoolController.cpp, PoolController.hpp, TimeClientHelper.cpp, TimeClientHelper.hpp]
2026-02-16 Add coding guidelines and fix clang-format violations (#24)
    * Initial plan
    * Update linter and PlatformIO workflows with modern actions and quality checks
    * Use super-linter@v7 for latest stable v7.x version
    * Add proper permissions blocks to all workflow jobs for security
    * Fix CI failures: remove trailing whitespace, fix clang-format version, remove Arduino Lint
    * Remove clang-format check and fix YAML formatting for Pret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
    [Config.hpp, ESP32TemperatureNode.cpp, ESP32TemperatureNode.hpp, OperationModeNode.cpp, OperationModeNode.hpp, PoolController.cpp, PoolController.hpp, RelayModuleNode.cpp]
2026-02-16 Optimize for 24/7 operation, add native Home Assistant MQTT Discovery, state persistence, auto-recovery, OTA updates, configurable NTP/timezone, fix critical bugs, update libraries (#18)
    [DallasTemperatureNode.cpp, ESP32TemperatureNode.cpp, OperationModeNode.cpp, OperationModeNode.hpp, PoolController.cpp, PoolController.hpp, RCSwitchNode.cpp, RCSwitchNode.hpp]
2026-04-05 Edge case analysis and all critical reliability fixes (8 issues resolved) (#25)
    [CPPLINT.cfg]
2026-05-14 docs: add temperature-based filtration specification
    OpenSpec specification for the automatic filtration duration feature
    based on pool water temperature, volume, and pump capacity. Derived
    from the archived copilot/add-automatic-filtration-calculation branch.
2026-05-20 24/7 Resilience — Phasen 1–3 + ESP8266-Removal (P1–P9) (#61)
2026-05-20 docs(hardware): ESP32 Schaltplananalyse für Sensoren und Relais ergänzen (#59)
2026-05-21 fix: ESP32 compatibility, memory & buffer fixes + AGENTS.md update (#68)
    [OperationModeNode.cpp, OperationModeNode.hpp, SystemMonitor.hpp, WpsProvisioner.cpp]
2026-05-23 feat: Cleanup and fixes (#72)
    [OperationModeNode.hpp, PoolController.cpp]
2026-05-30 feat(ha): Replace timer H/Min number entities with single HH:MM text entities (#74)
    [DallasTemperatureNode.cpp, DegradationManager.cpp, DegradationManager.hpp, OperationModeNode.cpp, OperationModeNode.hpp, PoolController.cpp, PoolController.hpp, SystemMonitor.hpp]
2026-06-05 docs: align Home Assistant timer docs with merged HH:MM text entity model (#73)
2026-06-06 fix: mount LittleFS during web portal startup (#85)
    [WebPortal.cpp]
2026-06-06 feat: restructure web UI settings tabs and HA entity categories (#87)
    * feat: restructure web UI settings tabs and HA entity categories
    - Split monolithic settings tab into Pool (🌊) and Time (🕐) tabs
    - Pool tab: mode, loop interval, temps, hysteresis, timer schedule
    - Time tab: NTP server, timezone, time sync degradation
    - Added saveTimeSettings() with validation for time tab
    - Added entity_category support to HA MQTT discovery
    - Sensors → diagnostic, Controls → no category, Config → config
    * fix: single-column layout for settings on mobile devices
    Add media query (max-width: 520px) to switch .telemetry-grid to
    single column, preventing input fields from being cut off on
    smart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
    [MqttPublisher.cpp, MqttPublisher.hpp, TimeClientHelper.cpp, TimeClientHelper.hpp]
2026-06-06 chore(main): release 3.3.0 (#75)
    * chore(main): release 3.3.0
    * docs(changelog): add refactor entry for NVS migration (#84)
    * docs(changelog): fix markdown lint (MD004, MD012, MD013) — use dash lists, wrap long lines, squash blanks
    ---------
2026-06-06 docs: update to v3.3.0, add Hugo docs skill, fix notify workflow paths
    - Add hugo-docs skill under .opencode/skills/hugo-docs/
    - Update docs version refs: Pool Controller 2.0 → 3.3, README 3.2 → 3.3
    - Add historical banners to v3.1.0 summary docs
    - Fix notify-website-doc.yml: add path filter for doc-only triggers
    - Fix platformio.ini FW_VERSION to 3.3.0 (release-please missed it)
    - Fix release-please v4 extra-files: replace search-regex with annotations
2026-06-07 fix(web): clarify that timer start/end also applies in Auto mode
2026-06-07 docs: SEO optimization for documentation pages
    Improve search engine discoverability and page quality signals:
    Frontmatter & meta descriptions:
    - Add missing Hugo frontmatter (title, description, tags, menu) to mqtt-configuration.md,
    ota-updates.md, and state-persistence.md
    - Add keyword-rich unique meta descriptions to _index, users-guide, hardware-guide,
    software-guide, home-assistant pages (EN + DE)
    - Add descriptions to esp32-schematic-optimization-de and esp32-complete-wiring-de
    Noindex for internal documents:
    - Add noindex + private frontmatter to proposal-24-7-resilience (EN/DE),
    optimization-report, optimierungen-de, edge-case-analysis (EN/DE),
    architecture-improvement-plan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
2026-06-07 docs: hardware guide overhaul with manufacturing tips
    Complete rewrite and expansion of the hardware documentation:
    hardware-guide.md (EN):
    - Step-by-step wiring instructions for DS18B20 sensors and relay module
    - Enhanced parts list with alternative options and sourcing guidance
    - Text-based wiring diagram (ASCII art) with color-coded connections
    - Manufacturing tips: soldering technique, enclosure selection,
    cable management, strain relief, outdoor sensor installation
    - Power supply comparison table (USB vs. DIN-rail vs. VIN)
    - First power-on testing procedure with verification checklist
    - Comprehensive troubleshooting table (11 common issues)
    - Optional wiring optimization (GPIO15/16/1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
2026-06-07 docs: remove 10 stale internal documents, no content to migrate
    All reviewed internal docs contained completed/outdated information that
    is already covered by public documentation:
    Deleted:
    - proposal-24-7-resilience.md / -de.md (v3.2.0 proposal — features already in state-persistence.md)
    - optimization-report.md / optimierungen-de.md (v3.1.0 optimization log — fixes are in the code)
    - edge-case-analysis.md / -summary-de.md (v3.1.0 AI-generated analysis — edge cases handled)
    - architecture-improvement-plan.md (2024 draft — covered by architecture-refactor skill)
    - build-fix.md (one-time CI debug from v3.1.0)
    - summary.md / summary-de.md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
2026-06-07 docs: add Doxygen documentation headers to all source files
    Add @file + @brief headers to all 46 source files (23 .hpp + 23 .cpp).
    Add class-level @brief documentation to all major classes.
    Add method-level @param/@return/@brief docs to API headers:
    Rule, PoolController, RelayModuleNode, DallasTemperatureNode,
    WebPortal, NetworkManager, ConfigManager, MqttPublisher, etc.
    Document struct fields in ConfigManager.hpp, Timer.hpp, Config.hpp.
    Build verified: pio run succeeds.
2026-06-07 feat: add Home Assistant climate/thermostat MQTT entity
    Publishes a MQTT climate platform via HA Discovery that combines the
    existing pool temperature sensor, max pool temperature setting, and
    pump states into a single thermostat entity.
    HVAC mode ↔ pool operation mode mapping:
    off → manu (manual, pumps controlled via switches)
    auto → auto (automatic solar heating)
    heat → boost (forced heating)
    timer → auto (falls back to auto in climate state)
    Action state (heating/idle/off) derived from solar/pool pump states.
    All existing sensor/switch/select/number entities remain unchanged —
    the climate entity is additive.
2026-06-07 docs: add temperature-based circulation concept (DE/EN)
2026-06-07 feat: temperature-based circulation time with continuous extension
    Adds dynamic pump runtime extension based on pool water temperature.
    When the timer is active and pool temperature exceeds the configurable
    threshold, the pump runtime is extended proportionally.
    Implementation:
    - ConfigManager: 3 new parameters (tempCircThreshold/Factor/MaxRuntime)
    - Timer: calculateEffectiveEndMinutes() helper with midnight crossing support
    - Rule: new checkPoolPumpTimer(float poolTemp) overload with 'only-extend'
    policy — end time only moves later, never earlier
    - RuleTimer/RuleAuto: use extended timer with pool temperature input
    - OperationModeNode: reset extension on mode change
    - MqttPublisher: 3 N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
    [ConfigManager.hpp, MqttPublisher.cpp, OperationModeNode.cpp, Rule.hpp, RuleAuto.cpp, RuleTimer.cpp, Timer.cpp, Timer.hpp]
2026-06-07 feat(web): add temperature-based circulation parameters to Web UI
    - Add 3 new input fields to Pool settings tab:
    - Circ. Temp Threshold (°C)
    - Circ. Temp Factor (min/°C)
    - Circ. Max Runtime (min)
    - Show effective runtime in dashboard telemetry section
    - Backend: serialize new fields in GET /api/config
    - Backend: persist from POST /api/config (type=settings)
    - Backend: expose effective_runtime in GET /api/status
2026-06-07 docs: add end-user guide for temperature-based circulation
2026-06-07 fix: review findings for temperature-based circulation
    P1: checkPoolPumpTimer no longer clears _activeEndMinutes when
    base timer window ends — extension keeps pump running past
    the timer end time.
    P2: Add NVS persistence keys for tempCircThreshold, tempCircFactor,
    tempCircMaxRuntime so values survive reboot.
    P2: Guard circ_* field deserialization with hasArg() so saveTimeSettings
    (which posts type=settings without circ fields) doesn't overwrite
    them with 0.
    P2: Add getEffectiveRuntimeMinutes() helper to Rule — returns actual
    runtime minutes (endTime - startTime) instead of end-of-day
    minutes-since-midnight. Fixes both WebPortal and MqttPublisher.
    [ConfigManager.cpp, MqttPublisher.cpp, Rule.hpp, WebPortal.cpp]
2026-06-08 refactor: replace RelayModule dependency with inline GPIO control
    Remove the unmaintained YuriiSalimov/RelayModule library (last push Sep 2019,
    repo transferred) by inlining its trivial 76-line functionality:
    - digitalWrite/digitalRead directly in RelayModuleNode
    - _currentState bool cache for fast state reads
    - pinMode in begin() instead of RelayModule constructor
    - Active-LOW behavior preserved (ON=LOW, OFF=HIGH)
    This removes one external dependency, ~30 lines of generated library code,
    and the Git-pinned URL from platformio.ini.
    [RelayModuleNode.cpp, RelayModuleNode.hpp]
2026-06-08 refactor: migrate from PubSubClient to AsyncMqttClient
    Replace the unmaintained knolleary/PubSubClient (last release May 2020,
    566 open issues) with marvinroger/AsyncMqttClient (v0.9.0, actively
    maintained, ESP32-native async TCP).
    Key changes:
    - AsyncMqttClient is fully event-driven — no mqttClient_.loop() needed
    - onConnect callback publishes LWT 'online' immediately
    - onDisconnect callback logs reason code
    - Removed WiFiClient/WiFiClientSecure manual management (AsyncTCP
    handles transport internally)
    - setSecure() guarded by #if ASYNC_TCP_SSL_ENABLED (not available
    in stock AsyncTCP; logs warning if TLS is configured)
    - publish/subscribe signatures updated to async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
    [MqttPublisher.cpp, MqttPublisher.hpp, NetworkManager.cpp, NetworkManager.hpp]
2026-06-08 refactor: remove TLS/MQTTS support from MQTT config and web UI
    AsyncMqttClient on ESP32 does not support TLS with the stock AsyncTCP
    library (ASYNC_TCP_SSL_ENABLED not available). Rather than keeping a
    dead config option that logs a warning at runtime, remove useTls
    entirely:
    - Removed bool useTls from MqttConfig struct
    - Removed kMqttTls NVS key, read, and write from ConfigManager
    - Removed TLS checkbox from web UI (index.html, app.js)
    - Removed use_tls from REST API (WebPortal getConfig/saveConfig)
    - Removed conditional #if ASYNC_TCP_SSL_ENABLED from connectMqtt()
    The MQTT port defaults to 1883 (non-TLS). Users who need MQTTS can
    set up a local TLS-terminating proxy (e.g. stunn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
2026-06-08 fix(mqtt): prevent dangling pointer and duplicate callback on reconnect
    String clientId was a local variable in connectMqtt(), but AsyncMqttClient
    stores the const char* pointer for async CONNECT packet construction.
    After the function returns, the pointer dangles.
    Fix: use static char buffer initialized once at first call.
    Also remove onMessage() re-registration in connectMqtt(). Every reconnect
    pushed another callback into AsyncMqttClient's internal vector,
    accumulating duplicates over time. The callback is already registered
    once in setMqttCallback().
    [NetworkManager.cpp]
2026-06-08 feat(web): format effective runtime as duration in WebUI and HA
    - WebUI: display effective runtime as Xh Ym instead of raw minutes
    - HA: add device_class 'duration' to uptime and effective-runtime
    sensors, publish effective-runtime in seconds for consistent
    duration formatting
2026-06-08 docs: refactor documentation — remove redundancies, fix inconsistencies, update for v3.3
    - Remove duplicate frontmatter in _index.md / _index.de.md
    - Update roadmap: temperature-based circulation marked as done
    - Strip TLS references (removed from firmware in v3.3)
    - Update library list: PubSubClient -> AsyncMqttClient, remove obsolete deps
    - Rewrite MQTT section in software-guide to point to dedicated pages
    - Add missing HA entities (temp-circ-*) to entity tables
    - Fix effective-runtime unit from min to s
    - Strip all ESP8266/nodemcuv2 artifacts from OTA docs
    - Update version strings to 3.3.0, remove stale future-enhancement entries
2026-06-09 feat: optimierte Pin-Belegung (GPIO32/33/25/26) + Status-LED mit Homie-Blinkcodes
    - Config.hpp: Pins auf optimierte Werte umgestellt (GPIO32/33/25/26 statt
    15/16/18/19) — vermeidet Strapping-Pins und ADC2-Probleme
    - Config.hpp: PIN_LED_STATUS + PIN_LED_WARN für eingebaute LED
    - StatusLed.hpp/.cpp: Neue Klasse mit Homie-konformen Blink-Patterns:
    AP-Modus (5 Hz), WiFi-Verbindung (1 Hz), MQTT getrennt (Herzschlag),
    Online (dauerhaft), OTA-Update (10 Hz), Safe-Mode (Doppelblink)
    - PoolController.cpp: StatusLed::begin() in setup(), Pattern-Steuerung
    in loop(), erweitertes Pin-Logging mit optimierter-Belegung-Hinweis
    - Docs (EN/DE): Pin-Tabellen, Schaltplan, Kabelfarben und Anschluss-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
    [Config.hpp, PoolController.cpp, StatusLed.cpp, StatusLed.hpp]
2026-06-09 fix: docs synced de/en
2026-06-09 Resolve workflow merge conflict and align PlatformIO dependency install (#91)
    [NetworkManager.hpp, Rule.hpp, StatusLed.cpp]
2026-06-11 Merge main into feat/temp-based-circulation: resolve Unicode conflict (#93)
    * docs: add temperature-based circulation concept (DE/EN)
    * feat: temperature-based circulation time with continuous extension
    - R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
    [MqttPublisher.cpp, Rule.hpp]
2026-06-11 chore: remove unused DHT sensor library and fix clang-format violations (#96)
    [ConfigManager.cpp, ConfigManager.hpp, MqttPublisher.cpp, MqttPublisher.hpp, NetworkManager.cpp, Rule.hpp, StatusLed.cpp, StatusLed.hpp]
2026-06-11 feat(norvi): add OLED display with 4 info pages, button navigation, and QR code
    - NORVI AE01-R OLED display with MAIN/NETWORK/SYSTEM/QRCODE pages
    - Three-button navigation (S1/S2/S3) with long-press support
    - Shared footer with time, firmware version, page number
    - QR code page for quick web interface access (ricmoo/QRCode)
    - Sensor setup wizard for DS18B20 address mapping
    - Manual degree symbol via drawCircle (avoids font encoding issues)
    - Button hints consistently positioned on right side of all pages
    - cpplint compliance: single-line if statements to multi-line
    - Documentation: NORVI hardware guide (EN+DE) + users-guide OLED section
    - Remove deprecated .travis.yml
    [Config.hpp, DallasTemperatureNode.cpp, DallasTemperatureNode.hpp, NorviButtonHandler.cpp, NorviButtonHandler.hpp, NorviOledDisplay.cpp, NorviOledDisplay.hpp, PoolController.cpp]
2026-06-11 feat: OLED Menu-Navigation, Sensor-Mapping in WebUI+HA, mDNS
    NORVI AE01-R:
    - Neues OLED-Navigationskonzept: S1=UP, S2=DOWN, S3=CONFIRM
    - First-Boot-Flow: WiFi → Sensor-Setup → Dashboard
    - Invertierte Sub-Item-Anzeige für Setup-Schritte
    - Auto-Return nach 60s Idle auf Dashboard
    - Burn-In-Schutz (2px-Offset alle 2 Minuten)
    - S3-Longpress: Mapping speichern & Reboot
    Setup-Reihenfolge gefixt:
    - loadSensorAddressMapping() + ConfigManager::begin() vor OLED-Init
    - needsSensorMapping() prüft jetzt NVS-Filter-State statt Wizard-State
    Sensor-Mapping WebUI:
    - Neuer '🔬 Sensors' Tab mit Radio-Button-Auswahl pro Rolle
    - GET /api/sensors + POST /api/sensors/map REST-Endpunkte
    - Hex-String-Parser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
    [MqttPublisher.cpp, MqttPublisher.hpp, NetworkManager.cpp, NorviOledDisplay.cpp, NorviOledDisplay.hpp, PoolController.cpp, WebPortal.cpp, WebPortal.hpp]
2026-06-11 fix(ha): select-Entity-Status ohne Temperatur publishen
    Der State enthielt die Temperatur ('ADDR (TEMP°C)'), aber nach dem
    Setzen des Adressfilters war der Wert kurz NaN ('--.-°C') — das
    entsprach keiner Option, HA setzte auf '— Not configured —' zurück.
    Fix: State = nur die Hex-Adresse (ohne Temperatur), exakt wie die
    Optionen in publishSensorMappingDiscovery().
    [MqttPublisher.cpp]
2026-06-11 fix(ha): Sensor-Mapping Discovery bei jedem MQTT-Reconnect publishen
    publishSensorMappingDiscovery() wurde nur einmalig via static-Flag
    in publishStates() aufgerufen. Bei MQTT-Broker-Neustart nach Disconnect
    gingen die select-Entities verloren.
    Fix: publishSensorMappingDiscovery() in publishDiscovery() aufrufen,
    damit sie bei jedem MQTT-Reconnect (initial + nach Disconnect) erneut
    publisht wird. Der einmalige Aufruf in publishStates() entfällt.
    [MqttPublisher.cpp]
2026-06-11 fix(ui): display dashboard thresholds without-auth via /api/status, 4-across mode cards
    - Add temp_max_pool + temp_min_solar to /api/status endpoint (no auth required)
    - Update loadTelemetry() to populate dashboard thresholds every 2s poll
    - Fix mode-selector grid to always show 4 cards in one row (repeat(4, 1fr))
    - Remove conflicting inline styles; let CSS classes control layout cleanly
    [WebPortal.cpp]
2026-06-11 docs: add missing German translations and rename misnamed files
    - Add DE translations: users-guide, ota-updates, state-persistence, mqtt-configuration
    - Rename esp32-complete-wiring-schematic-de.md -> .de.md (convention fix)
    - Rename esp32-schematic-optimization-de.md -> .de.md (convention fix)
    - Add EN originals for both renamed files
    - Update internal cross-references in hardware-guide (EN+DE) and renamed files
2026-06-11 feat(ui): iOS-style bottom tab bar with glassmorphism
    - Replace top cogwheel + settings dropdown with bottom tab bar (Dashboard, Pool, Time, Sensors, More)
    - Add More bottom sheet for WiFi/MQTT/System tabs
    - Remove all '← Dashboard' back links (tab bar handles navigation)
    - Remove old fixed footer (version inline in header)
    - iOS 26 glassmorphism: backdrop-filter blur(24px), frosted dark background, glow dot indicator on active tab
    - Bottom safe-area handling for iPhone notch/home indicator
2026-06-11 feat(ui): add About section in More bottom sheet
    - Add 'ℹ️ About' entry in More menu with divider
    - Create About tab showing firmware version, uptime, heap, IP, links
    - About tab fields populated live from /api/status telemetry
    - More-tab sub-pages (wifi/mqtt/system/about) keep 'more' highlighted in tab bar
    - .more-sheet-divider CSS for visual separation
2026-06-12 docs(mqtt): group HA entities table into logical sections
    - Split flat table into Sensors, Switches, Configuration, Buttons & Diagnostics
    - Circ. temp threshold/factor/max-runtime now sit in 'Configuration' section alongside pool-max-temp, solar-min-temp, hysteresis, etc.
    - Both EN and DE docs updated identically
2026-06-12 feat(mqtt): set HA entity_category for all discovery entities
    - Primary sensors (pool-temp, solar-temp): no entity_category → main device page
    - Switches + mode: entity_category: control → Controls section
    - All configurable numbers/selects/texts/times: entity_category: config → Configuration section
    - Diagnostics (heap, rssi, uptime, etc.): entity_category: diagnostic → Diagnostics section
    - Climate/Update/Button/Log-serial: entity_category: config
    - publishTextDiscovery now accepts entityCategory parameter (was hardcoded to 'config')
    - Docs updated with Entity Category column in all tables + reference table
2026-06-14 fix: restore telemetry updates and HA entity visibility
    - Remove stale fwVersionDisplay reference in app.js that caused
    a TypeError, breaking loadTelemetry() → heap/signal/uptime/circ
    values stayed at '--' in the Web UI
    - Remove entity_category from pump switches and operation mode
    select in MQTT discovery, so they appear on the main HA device
    page instead of being hidden under 'Controls'
    [MqttPublisher.cpp]
2026-06-14 Revert "fix: restore telemetry updates and HA entity visibility"
    This reverts commit 716dfe66a49507b6a0cb33b904c28bfb6101e171.
    [MqttPublisher.cpp]
2026-06-14 fix: add native test infrastructure with ASan and coverage reporting (#98)
    [Arduino.h, AsyncMqttClient.h, Bounce2.h, ConfigManager.cpp, ConfigManager.hpp, DNSServer.h, DallasTemperature.h, DallasTemperatureNode.hpp]
2026-06-15 docs: add Quick Start Guide, FAQ, and Safety Documentation
    Adds three new documentation pages in German:
    - **Quick Start Guide** (docs/quickstart.md): step-by-step wiring, flashing, and first-use instructions for the pool-controller ESP32, including ASCII wiring diagrams and a command reference table
    - **FAQ** (docs/faq.md): answers to common questions covering WiFi connectivity, sensor issues, relay operation, MQTT, LED status, and integration with Home Assistant / ioBroker
    - **Safety** (docs/safety.md): comprehensive safety instructions for working with pool electrical systems, including DOs/DON'Ts, emergency procedures, and legal compliance (VDE, DIN, EU)
2026-06-17 feat(docs): add KiCad 9.0 schematic generator and PDF exports (#104)
    [esp32-dev-board.kicad_sch, norvi-ae01-r.kicad_sch]
2026-06-19 🔒 IoT Security & Memory Optimization Analysis (#112)
2026-06-21 🔒 Security & Memory Fixes: High Priority Issues (#113)
    [Arduino.h, ConfigManager.cpp, ConfigManager.hpp, MqttPublisher.cpp, MqttPublisher.hpp, OtaUpdater.cpp, OtaUpdater.hpp, TimeClientHelper.cpp]
2026-06-22 fix(web): remove leftover merge conflict markers in index.html (#118)
    [WebPortal.cpp]
2026-06-24 Fix MegaLinter: Convert FILTER_REGEX_EXCLUDE from list to string
2026-06-24 Integrate MegaLinter config directly into workflow
    - Remove external .megalinter.yml file
    - Set ENABLE, DISABLE, FILTER_REGEX_EXCLUDE directly in workflow env
    - This avoids YAML parsing issues with external config files
    - Maintains same linter configuration
2026-06-24 test: add StateManager and Timer unit tests, fix mock infrastructure (#121)
    [Arduino.h, ConfigManager.cpp, DegradationManager.hpp, StateManager.hpp, SystemMonitor.hpp, TimeClientHelper.hpp, captures.cpp, stubs.cpp]
2026-06-27 fix(ota): select correct firmware binary per board type
    The OTA updater now looks for a board-specific asset name first
    (firmware-norvi_ae01_r.bin or firmware-esp32dev.bin) before
    falling back to a generic firmware.bin. This ensures NORVI AE01-R
    builds get the correct OLED-enabled binary from the GitHub release.
    [OtaUpdater.cpp]
2026-06-27 fix(wps): correct ESP-IDF version guard for esp_wifi_wps_start API
    The ESP-IDF 5.x changed esp_wifi_wps_start() to take no arguments
    instead of an int parameter. The guard was incorrectly checking for
    ESP-IDF >= 6.0.0 but the change happened in 5.0.0.
    The project uses espressif32 @ 7.0.1 which includes ESP-IDF 5.x,
    so the wrong guard would cause compilation/link errors with the
    newer toolchain.
    [WpsProvisioner.cpp]
2026-06-27 fix(mqtt): remove duplicate Home Assistant Discovery entities
    The publishDiscovery() method was publishing timezone, hysteresis,
    and ntp-server entities twice — once in the correct config section
    and again in a redundant block at the end of the function.
    The duplicates at lines 445-448 were leftover from a refactor and
    would cause HA warnings about duplicate unique_ids. The second
    ntp-server publish also lacked entity_category, so it would
    inconsistently overwrite the config-category assignment.
    Removed the redundant block. Each entity now publishes exactly once.
    [MqttPublisher.cpp]
2026-06-27 fix(network): remove always-true WPS function pointer check
    NetworkManager::begin() checked WpsProvisioner::runIfRequested != nullptr
    to decide whether to reload config. Since runIfRequested is a compiled-in
    static function, this pointer comparison is always true — making the
    condition meaningless dead code.
    The intent was: 'WPS may have run and saved new credentials, so reload
    config.' The fix unconditionally calls ConfigManager::load() after
    runIfRequested() completes, which is both correct and simpler.
    [NetworkManager.cpp]
2026-06-27 style(ota): fix clang-format violations for inline continue statements
    clang-format --Werror rejects single-line if-continue statements.
    Split 'if (!name) continue;' and 'if (strstr(...) == nullptr) continue;'
    onto two lines to satisfy the formatter.
    [OtaUpdater.cpp]
2026-06-27 docs(config): fix documentation — config uses NVS, not LittleFS
    The ConfigManager class uses NVS (via Arduino Preferences) for
    persistent storage, not LittleFS (SPIFFS/LittleFS filesystem).
    Updated all doc comments to correctly say 'NVS' instead of 'LittleFS'.
    Also includes the pre-existing clang-format fix in OtaUpdater.cpp
    to pass MegaLinter checks.
    [ConfigManager.cpp, ConfigManager.hpp]
2026-06-27 fix(pool-controller): stop overriding persisted TimerSetting with hardcoded values
    initializeController() was reading the timer setting from OperationModeNode
    (which loads from NVS via StateManager), then immediately overwriting it
    with hardcoded 10:30-17:30 values. This defeated NVS persistence — any
    user changes to timer settings via HA or the web portal were silently
    discarded on reboot.
    OperationModeNode::begin() already loads the persisted timer setting from
    NVS with the same defaults (10:30-17:30). The override in PoolController
    was redundant at best and destructive at worst.
    Also includes the pre-existing clang-format fix for MegaLinter compliance.
    [PoolController.cpp]
2026-06-27 refactor(mqtt): consolidate duplicated device info block into helper method
    The device JSON block (identifiers, name, manufacturer, model, sw_version)
    was duplicated in all 8 HA Discovery methods — publishSensorDiscovery,
    publishSwitchDiscovery, publishSelectDiscovery, publishNumberDiscovery,
    publishTextDiscovery, publishTimeDiscovery, publishUpdateDiscovery,
    and publishClimateDiscovery.
    Replaced the duplicated 6-line block with a call to addDeviceInfo(doc),
    a new helper that populates the device object on the JsonDocument.
    The old getDeviceJson() was dead code (declared and defined but never
    called anywhere). Replaced it with addDeviceInfo().
    Net: -35 LoC, zero functional change.
    Also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
    [MqttPublisher.cpp, MqttPublisher.hpp]
2026-06-29 fix: correct #pragmaonce to #pragma once in RuleAuto.hpp
    - Fix typo introduced during SPDX-License-Identifier addition
    - This caused the PlatformIO CI build failure
    [RuleAuto.hpp]
2026-06-29 fix(config): correct Doxygen description — uses NVS (Preferences), not LittleFS
    Addresses PR #133 review comment.
    [ConfigManager.cpp, ConfigManager.hpp]
2026-06-29 chore(ci): silence MegaLinter release-notice banner, switch to C/C++ flavor
    - Add SECURITY_SUGGESTIONS: false to suppress the default release banner
    - Switch from oxsecurity/megalinter (full image) to
    oxsecurity/megalinter/flavors/c_cpp for faster CI runs
2026-06-30 docs(ha): update Lovelace dashboard and entity tables for v4.0.0
    - Replace all garten_pool_controller prefixes with pool_controller
    - Fix entity IDs to match actual MQTT objectIds (pool_temp, rssi, heap, etc.)
    - Add missing entities: circulation params, climate thermostat,
    sensor mapping, controller temp, effective runtime, max alloc
    - Split into two audience-specific views:
    - Pool view for daily operation (Bademeister)
    - System view for diagnostics & configuration (IoT developer)
    - Update HA entity reference tables in EN and DE docs
    - Correct entity_category values (all numbers are now config)
    - Add sensor_found diagnostics and climate thermostat
2026-06-30 feat(ha): add state_class, binary_sensor, RSSI class, and climate preset modes
    Enhance Home Assistant MQTT Discovery entities for better integration:
    - Add state_class to all sensor entities: "measurement" for temperature/
    diagnostics, "total_increasing" for uptime — enables HA history statistics
    (min/max/avg) and long-term graphs
    - Change solar-sensor-found/pool-sensor-found from text sensor to
    binary_sensor with device_class "connectivity" — shows green/red status
    indicator in HA frontend
    - Add device_class "signal_strength" to RSSI sensor — improves visualization
    - Add preset_modes (none/manual/schedule/boost) to the climate thermostat
    entity with dedicated command/state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
2026-06-30 feat(ha): add display precision, circulating action, outlet class, MQTT sensor, cleaner names
    Further Home Assistant MQTT Discovery enhancements:
    - Add suggested_display_precision: 1 to all temperature sensors for
    consistent decimal display in HA frontend
    - Change climate action from "idle" to "circulating" when pool pump
    is running without solar heating — more accurate description
    - Add device_class "outlet" to pool-pump and solar-pump switches
    - Add binary_sensor "mqtt-status" with device_class "connectivity"
    for MQTT connection monitoring from HA
    - Normalize entity display names: "Max. Pool Temp" → "Maximum Pool
    Temperature", "Min. Solar Temp" → "Minimum Solar Temperature",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
2026-07-01 Add WiFi status icon to NORVI display footer
    - Added small WiFi icon in the footer of all display pages
    - Icon shows 4 vertical bars when WiFi is connected
    - Icon shows 4 vertical bars with X overlay when WiFi is disconnected
    - Positioned at (64, 56) between time and firmware version
    - Uses existing NetworkManager::isWiFiConnected() API
    - Fixed clang-format compliance
    - Fixed trailing whitespace in auto-merge-release.yml
    This provides a quick visual indication of WiFi connectivity status on the NORVI OLED display.
    [NorviOledDisplay.cpp]
2026-07-02 Fix clang-format violations in MqttPublisher
    - Fix parameter formatting in publishBinarySensorDiscovery declaration
    - Fix parameter formatting in publishBinarySensorDiscovery and publishSwitchDiscovery definitions
    - Split long function calls across multiple lines to comply with 130 character limit
    - Fix NetworkManager::publish calls to split across lines
    Addresses MegaLinter clang-format errors in PR #138
    [MqttPublisher.cpp, MqttPublisher.hpp]
2026-07-02 Fix clang-format issues: proper indentation for continuation lines
    [MqttPublisher.cpp]
2026-07-02 Fix clang-format: pack parameters on first line where possible
    [MqttPublisher.cpp]
2026-07-02 Fix NetworkManager::publish calls formatting
    [MqttPublisher.cpp]
2026-07-02 Fix clang-format: use LLVM style for function definitions and calls
    [MqttPublisher.cpp]
2026-07-02 Fix hysteresis line formatting
    [MqttPublisher.cpp]
2026-07-02 Fix mqtt-status line formatting
    [MqttPublisher.cpp]
2026-07-02 Fix timezone line formatting
    [MqttPublisher.cpp]
2026-07-02 fix(clang-format): apply clang-format to MqttPublisher.cpp
    Fix 29 clang-format violations in src/MqttPublisher.cpp that caused
    PR #138 CI build failures. Changes are purely formatting:
    - Bin-pack function parameters on first line where possible
    - Use ContinuationIndentWidth: 2 for continuation lines
    - Single-line calls where they fit within ColumnLimit: 130
    [MqttPublisher.cpp]
2026-07-04 docs: add comprehensive Codex code review for Clean Code & 24/7 IoT readiness
    Review covers:
    - 8 critical findings (String heap fragmentation in MQTT hot-path, DegradationManager pessimistic init, millis rollover, excessive logging, etc.)
    - 9 mid-severity Clean Code findings (magic strings, tight coupling, singleton anti-pattern, code duplication, etc.)
    - Positive patterns worth preserving (SystemMonitor, DegradationManager, boot-loop detection, etc.)
    - Prioritized remediation action plan
    Generated via Codex review on 2026-07-04, branch review/codex-clean-code-iot-review
2026-07-04 refactor: address Codex review findings — replace String, deduplicate NVS, fix millis wrap, add sensor boot guard, quiet timer logging
    Changes from code review PR #143:
    - K1 (mqtt): replace String concatenation with char buffers in MqttPublisher hot path and all discovery methods. getBaseTopic() now writes to caller-provided buffer.
    - K3 (system): add sensorsEverReported_ flag to DegradationManager so sensor failure count is skipped until first measurement cycle.
    - K4 (ota): remove redundant millis() wrap-safety check in OtaUpdater — unsigned arithmetic handles wrap per C++ standard.
    - K7 (config): extract saveSensorMapping/loadSensorMapping into ConfigManager; remove duplicated NVS cod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
    [ConfigManager.cpp, ConfigManager.hpp, DegradationManager.cpp, DegradationManager.hpp, MqttPublisher.cpp, MqttPublisher.hpp, OtaUpdater.cpp, PoolController.cpp]
2026-07-05 feat(ha): add circulation-extension sensor showing extra minutes beyond base timer
    Adds a new HA Discovery sensor 'circulation-extension' that publishes
    the temperature-based runtime extension in seconds — the extra minutes
    the pump runs beyond the base timer window.
    - New Rule::getCirculationExtensionMinutes() method
    - HA Discovery entity 'Circulation Extension' (sensor, duration, s)
    - State published in MqttPublisher::publishStates()
2026-07-05 feat(web-ui): show circulation extension (extra minutes) on dashboard
    Adds a new 'Extension' field to the Dashboard telemetry grid showing
    how many extra minutes the pump runs beyond the base timer window
    due to temperature-based circulation. Highlighted in accent color
    when active, dimmed when no extension applies.
    - WebPortal: new 'circulation_extension' JSON field in /api/status
    - index.html: 5-column telemetry grid with 'Extension' column
    - app.js: display formatted duration with '+' prefix when active
2026-07-05 chore: migrate Super-Linter to MegaLinter, fix clang-format and markdown violations
    [ConfigManager.cpp, MqttPublisher.cpp, OtaUpdater.cpp, Rule.hpp]
2026-07-05 feat(web-ui): redesign timer display as intuitive time range instead of abstract minutes
    Replaces separate 'Circ. Runtime' and 'Extension' telemetry items with a
    single combined 'Timer' display that shows the actual time window:
    Before: Circ. Runtime: 11h 0m | Extension: +3h 0m
    After: Timer: 10:00→21:00 (+3h)
    - WebPortal API now returns timer_start_h/m, timer_end_h/m, timer_extended_end
    - Timer window with arrow, extended end time in accent color when active
    - Clean 4-column telemetry grid
    [WebPortal.cpp]
2026-07-05 fix(test): add missing saveSensorMapping/loadSensorMapping to mock ConfigManager
    The Native Tests CI was failing because saveSensorMapping/loadSensorMapping
    were added to the production ConfigManager.hpp/cpp (commit ca01a59) but
    the mock ConfigManager in test/native/mocks/ was never updated.
    The wrapper WebPortal.cpp (copied from production source) calls
    ConfigManager::saveSensorMapping() inside saveSensorMappingNvs(), but the
    mock shadowed the production header without declaring these methods.
    Add in-memory implementations to the mock so the native tests compile.
    [ConfigManager.cpp, ConfigManager.hpp]
2026-07-06 fix(test): add strlcat fallback for native test builds
    strlcat is not available on glibc < 2.38 (e.g. GitHub Actions Ubuntu
    22.04 runners). The Codex review refactored MqttPublisher.cpp to use
    char buffers + strlcat instead of String concatenation, but the native
    test target failed to compile on CI.
    Add a CMake CheckSymbolExists probe and provide strlcat via stubs.cpp
    on hosts that lack it. Declare it in Arduino.h under the same guard so
    wrapper files see a declaration.
    Also fixes the saveSensorMapping mock issue found in the same review
    (commit 00d349b).
    Addresses PR #144 review comments.
    [Arduino.h, stubs.cpp]
2026-07-06 docs: add NORVI display navigation UX concept
    Detailliertes Bedien- und Navigationskonzept für das 128×64 OLED-Display
    mit den drei Fronttasten (S1/S2/S3) des NORVI IIOT-AE01-R.
    Beinhaltet:
    - Ist-Analyse der aktuellen UX-Probleme
    - Neues Button-Mapping (S1=prev, S2=next, S3=action)
    - Aktionsmenü auf MAIN-Seite statt direktem Mode-Cycle
    - Hint-Bar-Design mit eindeutigen Labels
    - Sensor-Wizard-Navigation inkl. Cancel
    - Edge Cases (Auto-Return, Long-Press, QR-Seiten)
    - Umsetzungsplan für Code-Änderungen
2026-07-07 docs: incorporate second review — I2C perf, S1 wrap, wizard cancel label
    Änderungen basierend auf zweitem Review (Usability-Fokus):
    - I2C-Performance: Partial-Redraw oder 5 diskrete Stufen für
    Fortschrittsbalken (8.2)
    - Wizard-Cancel: Label-Wechsel up→back (invertiert) an Index 0 für
    bessere Discoverability (9.3)
    - Auto-Return-Warnung: gilt jetzt einheitlich für Info-Seiten,
    Aktionsmenü und Wizard (9.2)
    - Schritt-Indikator: Titel auf 'Setup [1/2]' verkürzt (Platzbedarf
    zur Hint-Bar) (9.4)
    - S1 auf MAIN: Wrap-around als Alternative zur Diskussion gestellt
    (12.3)
    - Review-Change-Log um neue Einträge ergänzt (11)
    - PR 3: I2C-Performance als Anforderung aufgenommen (10)
2026-07-07 docs: finalize S1 wrap decision on MAIN page
    S1 auf MAIN springt per Wrap-Around zur letzten Seite (WIFI_SETUP).
    Praktisch für Ersteinrichtung — kein viermaliges 'next' nötig.
2026-07-07 feat(display): update hint labels, footer page format, and S1 wrap
    UX-Verbesserungen gemäß Navigationskonzept (PR #146):
    - Hint-Labels:
    - S1 auf Info-Seiten: 'nxt' → 'prev'
    - S1 auf MAIN: 'nxt' → 'wrap' (Wrap-Around zur letzten Seite)
    - S2 auf Info-Seiten: 'nxt' → 'next'
    - S3 auf MAIN: 'ok' → 'menu'
    - S3 auf NETWORK/SYSTEM/QRCODE/WIFI_SETUP: 'ok' → ausgeblendet
    - S3 im Sensor-Wizard: 'ok'/'set' → 'select'/'assign'/'setup'
    - Footer:
    - Page-Zahl: '1'-'6' → '1/5'-'6/5' (X/Y-Format)
    - Version leicht nach links verschoben (76→68)
    - Navigation:
    - S1 auf MAIN springt per Wrap zu WIFI_SETUP (statt SENSOR_SETUP)
2026-07-07 feat(display): action menu, wizard-cancel, and step indicator
    Aktionsmenü auf MAIN-Seite (gemäß Navigationskonzept):
    - S3 auf MAIN öffnet ein 3-Item-Menü (Mode, Pump, Exit)
    - S1/S2 navigieren zwischen Menü-Einträgen
    - S3 bestätigt Auswahl und führt Aktion aus
    - 30s Auto-Return schließt Menü bei Inaktivität
    - Kein direkter Mode-Cycle mehr auf Info-Seiten
    Wizard-Cancel:
    - S1 auf erstem Sensor (Index 0) in SELECT_SENSOR → zurück zu IDLE
    - Explizites Abbrechen statt Timeout-Erzwingung
    Schritt-Indikator:
    - '[1/2]' / '[2/2]' neben Wizard-Titel in SELECT_SENSOR/ROLE
    Button-Callbacks:
    - S1/S2 priorisieren Menu-Navigation vor Wizard/Page
    - S3 dispatch: menu → execute → MAIN | MA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
2026-07-07 feat(display): long-press progress bar and auto-return warning
    Long-Press-Feedback (gemäß Navigationskonzept):
    - NorviButtonHandler::getLongPressProgress() exponiert 0.0-1.0
    - drawProgressBar() zeigt horizontalen Fortschrittsbalken während
    S3-Long-Press auf SENSOR_SETUP (IDLE, beide Sensoren zugewiesen)
    - Loop beschleunigt Redraw während Long-Press für flüssige Animation
    - I2C-schonend: nur Balken-Pixel werden gezeichnet (partial overlay)
    Auto-Return-Warnung:
    - 5s vor Timeout: Version/Page-Nummer im Footer durch '→ MAIN Xs' ersetzt
    - Gilt für Info-Seiten (60s) und Menü (30s)
    - autoReturnWarningMs als file-scope Variable (loop setzt, footer zeichnet)
    Build: SUCCESS (Flash 96,3%)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
2026-07-07 fix(relay): correct relay polarity for NORVI AE01-R active-HIGH relays
    The NORVI AE01-R uses active-HIGH relays:
    HIGH = relay energized (ON)
    LOW = relay de-energized (OFF)
    The code assumed active-LOW (standard external relay modules),
    causing inverted behavior: setSwitch(false) wrote HIGH to the GPIO
    pin, which turned the NORVI relay ON instead of OFF.
    Fix:
    - Add bool activeLow parameter to RelayModuleNode constructor
    (default true for backward compatibility with standard relay modules)
    - Use polarity-aware logic in begin() and setSwitch() digitalWrite calls
    - Create NORVI relay nodes with activeLow=false in PoolController.cpp
    [PoolController.cpp, RelayModuleNode.cpp, RelayModuleNode.hpp]
2026-07-07 fix(display): ADC threshold calibration and QR code sizing
    ADC threshold fix (critical):
    - THRESH_NO_PRESS von 3800 auf 2000 gesenkt — der Ruhepegel
    liegt bei ~2445 (war fälschlich in Button-2-Range)
    - Tastenbereiche proportional zwischen 0–2000 komprimiert
    - Serial-Debug: ADC-Rohwert bei Änderung (>50) loggen
    QR-Code fixes:
    - QRCODE-Seite: QR bei verbundenem WiFi durch große IP-Anzeige
    ersetzt (nicht scanbar, zu klein)
    - QRCODE-Seite: Button-Hints nur im Nicht-WiFi-Modus
    - WIFI_SETUP-Seite: QR von Scale 1 (21×21) auf Scale 2 (42×42)
    vergrößert, vollflächig zentriert
    - WIFI_SETUP-Seite: drawFooter entfernt (QR nutzt volle Höhe)
    Build: SUCCESS (Flash 96,3%)
    [NorviButtonHandler.cpp, NorviButtonHandler.hpp, NorviOledDisplay.cpp]
2026-07-07 docs(norvi): document active-HIGH relay polarity
    - Add relay polarity explanation to both EN and DE NORVI docs
    - Add activeLow parameter info to build instructions
    - Add relay polarity row to differences comparison table
    - Run clang-format on RelayModuleNode files
    Follow-up to 6e92aa0 (fix relay polarity).
    [RelayModuleNode.cpp, RelayModuleNode.hpp]
2026-07-07 fix(relay): avoid int→bool ambiguity in constructor overloads
    Separate constructor overloads for (pin, measurementInterval) vs
    (pin, bool activeLow, measurementInterval) prevent implicit int→bool
    conversion when passing a numeric measurement-interval argument.
    [RelayModuleNode.cpp, RelayModuleNode.hpp]
2026-07-07 refactor(relay): remove dead measurementInterval parameter from constructors (YAGNI)
    No caller passes measurementInterval to the constructor — it's always set
    via setMeasurementInterval() afterwards. Remove the dead parameter from
    both constructor overloads.
    Also add 'Tote Funktionsparameter (YAGNI)' to the clean-code skill's K3
    checklist.
2026-07-07 docs(deploy): replace espota.py instructions with web-based OTA workflow
    The project uses HTTP-based OTA via POST /api/update, not ArduinoOTA.
    Replace the old espota.py section with the actual login + firmware upload
    workflow using curl.
2026-07-07 feat(display): horizontal text scrolling for long strings
    Implementiert horizontales Text-Scrolling für Texte die breiter als
    die Anzeige sind (128 Pixel bei Text Size 1 ≈ 21 Zeichen).
    drawScrollingText() Helper:
    - Scrollt bei Überschreitung von maxWidth automatisch
    - Pause 2s am Start → 25 px/s nach links → Pause 1s → 50 px/s zurück
    - Nutzt Hardware-Clipping des SSD1306 (zeichnet bei negativem x)
    - Setzt Animation beim Seitenwechsel zurück
    Betroffene Seiten:
    - NETWORK: SSID scrollt falls > 21 Zeichen (vorher auf 9 gekürzt)
    - WIFI_SETUP: AP-Name scrollt im AP-Modus (vorher auf 14 gekürzt)
    - QRCODE: URL scrollt wenn kein WiFi verbunden (vorher auf 20 gekürzt)
    Build: SUCCESS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
2026-07-07 docs: add horizontal text scrolling to navigation concept
    Neuer Abschnitt 8.6: Horizontaler Text-Scroll bei Überlänge
    - Problembeschreibung (SSID, AP-Name, URL)
    - Scroll-Verhalten (Pause 2s → 25px/s → Pause 1s → 50px/s)
    - Implementierungshinweise (SSD1306 Hardware-Clipping)
    - Neuer Abschnitt 9.5 im Umsetzungsplan
2026-07-07 fix(display): address PR #147 review comments
    - Move footer version text from x=68 to x=78 to avoid WiFi icon overlap
    - Move footer page number from x=110 to x=112
    - Move S1/S2/S3 button hints left (x=86/83/80) so six-char labels
    like 'select'/'assign' fit before the button glyph at x=117
    Addresses PR #147 review comments.
    [NorviOledDisplay.cpp]
2026-07-07 fix: sensor setup UX, button thresholds, QR page layout
    - Restore original NORVI ADC thresholds (B1:200-1200, NoPress>3800)
    - S1 selects Solar role, S2 selects Pool role (no more toggle confusion)
    - Hints show 'Solar'/'Pool' instead of 'up'/'dn' on role selection
    - S1 wraps on SELECT_SENSOR (no cancel at first item)
    - QR page: IP textSize 1, 'Open browser' at y=28 (no footer overlap)
    [NorviButtonHandler.hpp, NorviOledDisplay.cpp, NorviOledDisplay.hpp, PoolController.cpp]
2026-07-07 style: fix clang-format violations in NorviOledDisplay
    15 clang-format errors reported by MegaLinter CI.
    [NorviOledDisplay.cpp, NorviOledDisplay.hpp]
2026-07-07 fix: address CodeQL code scanning alerts — thread-safe time functions, path-exclude libdeps, update skills
    [NorviOledDisplay.cpp, Rule.hpp, Timer.cpp]
2026-07-07 fix: address Codex clean-code review findings
    - K8: Guard remaining Serial.printf calls in Rule.hpp with DEBUG_RULE_TIMER (3 calls)
    - K7: Remove duplicate saveSensorAddressMapping/saveSensorMappingNvs wrappers,
    call ConfigManager::saveSensorMapping directly
    - C3: Create src/Nodes.hpp with centralized extern declarations,
    update 4 files that previously repeated them
    - C5: Refactor hashSha256() to write to caller-provided buffer (char[65])
    instead of allocating String (heap reduction)
    Build: norvi_ae01_r SUCCESS
    [ConfigManager.cpp, DegradationManager.cpp, MqttPublisher.cpp, Nodes.hpp, NorviOledDisplay.cpp, PoolController.cpp, Rule.hpp, WebPortal.cpp]
2026-07-07 fix(homeassistant): remove 'none' from preset_modes discovery config
    HA MQTT climate schema validation strictly rejects 'none' as a preset mode
    (preset_modes must not include 'none'). This caused the entire climate
    entity discovery to be rejected by HA, making it appear as 'not provided'.
    The 'none' value is HA-reserved for 'no preset active' and HA handles it
    internally — it does not belong in the preset_modes list.
    Fixes: climate entity not discovered in Home Assistant
    [MqttPublisher.cpp]
2026-07-07 test(mqtt): add regression tests for HA preset_modes 'none' bug
    - MqttPublisher::publishClimateDiscovery: assert preset_modes never
    contains the HA-reserved value 'none' (HA rejects the entire climate
    discovery config otherwise)
    - MqttPublisher::publishClimateState: assert preset/state still
    publishes 'none' when no preset is active (state reporting is
    unaffected by the discovery-list fix)
    - Verified both tests fail against the pre-fix code and pass against
    the current code
    Also fix an unrelated native-test build break: src/MqttPublisher.cpp's
    #include "Nodes.hpp" (added in f1d6da2) resolves against src/ headers
    when compiled from test/native/build/wrappers/, bypassing the mocks/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
    [Nodes.hpp]
2026-07-07 fix(ci): filter .pio/libdeps from CodeQL SARIF instead of paths-ignore
    paths-ignore in a CodeQL config file only filters results for
    no-build/interpreted analysis. For compiled languages like C/C++,
    the build tracer extracts everything the compiler touches during
    'platformio run', so third-party dependency alerts under
    .pio/libdeps/ kept appearing regardless of the config.
    Switch to the GitHub-recommended workaround: write analyze@v4 output
    to a directory with upload: never, strip .pio/libdeps/ results from
    the SARIF with jq, then upload the filtered file separately via
    upload-sarif@v4. Drop the now-dead codeql-config.yml.
    Addresses PR #152 review comment (P2).
2026-07-07 style(rule): clang-format DEBUG_RULE_TIMER guards in checkPoolPumpTimer
    Preprocessor directives must be at column 0 per .clang-format,
    matching the existing #ifdef DEBUG_RULE_TIMER blocks elsewhere in
    this file.
    Fixes MegaLinter CPP clang-format check (PR #152).
    [Rule.hpp]
2026-07-09 feat(web): make dashboard and operating parameters visible without login
    Serve the dashboard HTML always (no auth redirect). Add 'authenticated'
    flag to /api/status so the frontend can gate interactive controls.
    Add missing operating parameters (hysteresis, circulation settings, NTP,
    timezone) to /api/status so Pool and Time tabs display read-only values
    without requiring /api/config.
    Frontend shows a 'Sign In' banner and login modal when not authenticated.
    Interactive controls (pump toggle, mode change, threshold edits, admin
    tabs) are hidden or disabled in read-only mode. GET /api/sensors is
    also unauthenticated for sensor info display.
    Builds on both esp32dev and norvi_ae01_r.
    [WebPortal.cpp]
2026-07-09 fix(web): use streaming multipart upload for /api/fs/upload
    ESP32 WebServer limits form field values to ~10KB for url-encoded POSTs.
    Switch to multipart file upload with streaming handler (same pattern as
    OTA /api/update) so web assets of any size (e.g. app.js at 40KB) can be
    deployed after OTA without a serial connection.
    [WebPortal.cpp, WebPortal.hpp]
2026-07-09 fix(ci): fix native test build and clang-format violations
    - Add mkdir() and String open() overload to LittleFSClass mock
    so handleFsUploadStream() compiles in native tests
    - Fix clang-format violation: single-line lambda for upload handler
    - Hide tab bar when not authenticated (read-only dashboard)
    - Move login banner below operating mode section
    [Arduino.h, WebPortal.cpp]
2026-07-11 fix(norvi): move solar pump relay from R1 (GPIO12) to R5 (GPIO33) (#158)
    * fix(norvi): move solar pump relay from R1 (GPIO12) to R5 (GPIO33)
    A field unit's R1 relay channel was found permanently conducting —
    the relay audibly clicks on setSwitch(true/false), but COM1/NO1 never
    actually opens. This is confirmed to be a hardware fault (welded/fused
    contact or NO/NC miswiring during field installation), not a firmware
    regression: Relay Output 0 (pool pump) uses the identical
    RelayModuleNode / activeLow=false logic on a different GPIO and
    switches correctly.
    Reassigns PIN_RELAY_SOLAR to Relay Output 5 (GPIO33), which is
    otherwise unused on NORVI AE01-R builds. Units whose R1 channel works
    co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
    [Config.hpp]
2026-07-12 fix(sensor): apply address filter to running instance immediately (#160)
    [DallasTemperatureNode.cpp, DallasTemperatureNode.hpp]
2026-07-12 fix(web): make /api/fs/upload work by also accepting upload.filename
    server_.arg('path') is unreliable during the upload callback because
    the ESP32 WebServer's multipart arg parser may not have the text-field
    argument ready by the time UPLOAD_FILE_START fires. As a fallback,
    use upload.filename (the Content-Disposition filename attribute) as
    the target path. This makes 'curl -F "content=@file;filename=/web/app.js"'
    work correctly.
    [WebPortal.cpp]
2026-07-12 fix(web): stop tabs from reopening WiFi settings after navigation
    updateAuthUI() set element.style.display = '' to un-hide admin tabs
    (WiFi/MQTT/System/Sensors) once authenticated. These divs have no CSS
    rule hiding them by default, so clearing the inline style falls back
    to the browser default display:block — re-revealing whichever admin
    tab was previously active on every 2s telemetry poll, regardless of
    which tab switchTab() had actually selected.
    Since tab-wifi sits earliest in the DOM among the admin tabs, users
    navigating to e.g. Sensors after login would see the tab flash briefly
    and then get bounced back to WiFi Settings within ~2 seconds.
    updateAuthUI() now only ever force-hides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
2026-07-13 fix: solar pump hysteresis at max pool temperature
    Solar pump now turns OFF when pool_temp reaches maxPoolTemp (was maxPoolTemp + hysteresis).
    Boost mode also stops independently when max pool temperature is exceeded.
    Also includes OTA watchdog feeding during download and updated GitHub CA cert (USERTrust ECC) for future OTA reliability.
    [Config.hpp, OtaUpdater.cpp, RelayModuleNode.cpp, RuleAuto.cpp, RuleBoost.cpp]
2026-07-15 fix(docs): align HA entity table with name-based generation, fix domain errors (#157)
    [Arduino.h, stubs.cpp, test_relay_safety.cpp]
2026-07-18 feat(web): replace pump text toggle with visible toggle-switch controls (#166)
2026-08-10 fix(logging): trace operation mode command sources (#174)
    [MqttPublisher.cpp, OperationModeNode.cpp, OperationModeNode.hpp, PoolController.cpp, WebPortal.cpp]
2026-08-11 feat: add Olimex ESP32-C6 local UI (#175)
    * docs: add olimex c6 local ui concept
    * docs: refine olimex local ui display concept
    * docs: verify olimex local ui power compatibility
    * docs: make olimex display configuration flexible
    * docs: add olimex local ui implementation plan
    * docs: adjust olimex implementation pin defaults
    * build: add olimex esp32-c6 board variant
    * build: use pioarduino for olimex c6 arduino
    * build: pin onewire for esp32-c6 compatibility
    * build: use adafruit tft libraries for c6
    * fix(build): add explicit cstdint include
    * fix(build): support esp32-c6 arduino compatibility
    * build: pin pioarduino platform release
    * feat(ui): add local settings menu state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
    [Config.hpp, ConfigManager.cpp, ESP32TemperatureNode.cpp, ESP32TemperatureNode.hpp, Ky040Decoder.cpp, Ky040Decoder.hpp, LocalSettingsMenu.cpp, LocalSettingsMenu.hpp]
2026-08-13 feat(system): log concrete reason when entering safe mode (#179)
    * feat(system): log concrete reason when entering safe mode
    Safe-mode entry now logs the specific cause instead of a generic message:
    boot-loop (forced), critically low free heap, or a breakdown of the
    concurrent failures (WiFi, NTP, sensor). Priority mirrors evaluateLevel()
    decision logic.
    * style(system): fix clang-format line join in safe-mode reason log
    * fix(system): gate NTP reason on wifi availability in safe-mode log
    NTP loss while WiFi is down is a consequence, not an independent
    failure — evaluateLevel() only counts it when WiFi is up. Mirror that
    condition in the safe-mode reason breakdown so the diagnosis matc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
    [DegradationManager.cpp]
2026-08-13 fix: move solar pump relay to R2 (GPIO13), add RC snubber docs (#165)
    [Config.hpp, StatusLed.cpp]
2026-08-13 fix(button): Add ADC filtering and improved debouncing for NORVI front panel buttons (#177)
    [NorviButtonHandler.cpp, NorviButtonHandler.hpp]
2026-08-16 fix(button): stop phantom NORVI operation-mode switches (#181)
    [ConfigManager.cpp, ConfigManager.hpp, NorviButtonHandler.cpp, NorviButtonHandler.hpp, WebPortal.cpp]
2026-08-17 feat(calibration): guided NORVI button calibration wizard (#182)
    * docs: add NORVI button calibration design spec
    * docs(calibration): add implementation plan for button calibration
    * feat(calibration): add CalibrationManager state machine with measurement
    * test(calibration): cover threshold computation and error paths
    * feat(calibration): suppress button actions during calibration
    * feat(calibration): add REST endpoints for calibration wizard
    * feat(calibration): add guided calibration wizard to web UI
    * style(calibration): apply clang-format to CalibrationManager
    * style(calibration): fix clang-format and trailing newlines for CI
    * docs(calibration): fix trailing newlines for edi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
    [CalibrationManager.cpp, CalibrationManager.hpp, ConfigManager.cpp, ConfigManager.hpp, NorviButtonHandler.cpp, NorviButtonHandler.hpp, PoolController.cpp, WebPortal.cpp]
2026-08-17 fix(timer): keep pump running when extension wraps past midnight (#180)
    [Rule.hpp, TestTime.hpp, stubs.cpp]
2026-10-02 fix(mqtt): handle MQTT commands on the loop task (#209)
    [MqttCommandQueue.hpp, MqttPublisher.cpp, MqttPublisher.hpp, OperationModeNode.hpp, PoolController.cpp, TimeClientHelper.cpp, TimeClientHelper.hpp, stubs.cpp]
2026-10-29 ci(codeql): force a fresh PlatformIO compile so the tracer sees C/C++ sources (#235)
2026-10-29 Improve device web UI accessibility and center tab bar on desktop (#234)
2026-10-29 docs: draw ESP32 wiring schematic as svgbob diagrams (#236)
2026-10-30 docs: draw pool-controller wiring diagrams as svgbob (#237)
    * docs: draw ESP32 wiring schematic as svgbob diagrams
    Claude-Session: https://claude.ai/code/session_018328oAnNJiDkBWGPUaUwDd
    * docs: wrap long line in wiring schematic
    Claude-Session: https://claude.ai/code/session_018328oAnNJiDkBWGPUaUwDd
    * docs: draw hardware guide wiring as svgbob diagrams
    Claude-Session: https://claude.ai/code/session_018328oAnNJiDkBWGPUaUwDd
    * docs: draw contactor guide wiring as svgbob diagrams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
2026-10-30 docs: fix relay polarity (active-low) and remove non-existent relay-invert setting (#238)
    * docs: fix relay polarity (active-low) and remove non-existent relay-invert setting
    The firmware drives standard external relay modules active-low
    (PoolController.cpp) and has no runtime relay-invert option. The hardware
    guide, quick start guides, build-from-zero, troubleshooting and the production
    checklist said the opposite (must be active-high / relay-invert). Also label
    the hardware guide cost total correctly (it includes the optional parts).
    Claude-Session: https://claude.ai/code/session_018328o8Q4ZG13zRaqWob4aG
    * docs: fix markdownlint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
2026-10-30 docs: align cost estimate with the website (35–55 €) (#240)
